Shoziiii/David_marshal_project/PCB 18.16 AS ORDERED/PCB 18.16 AS ORDERED/Knock sensor from PCB with Modifications.docx

Knock Sensor

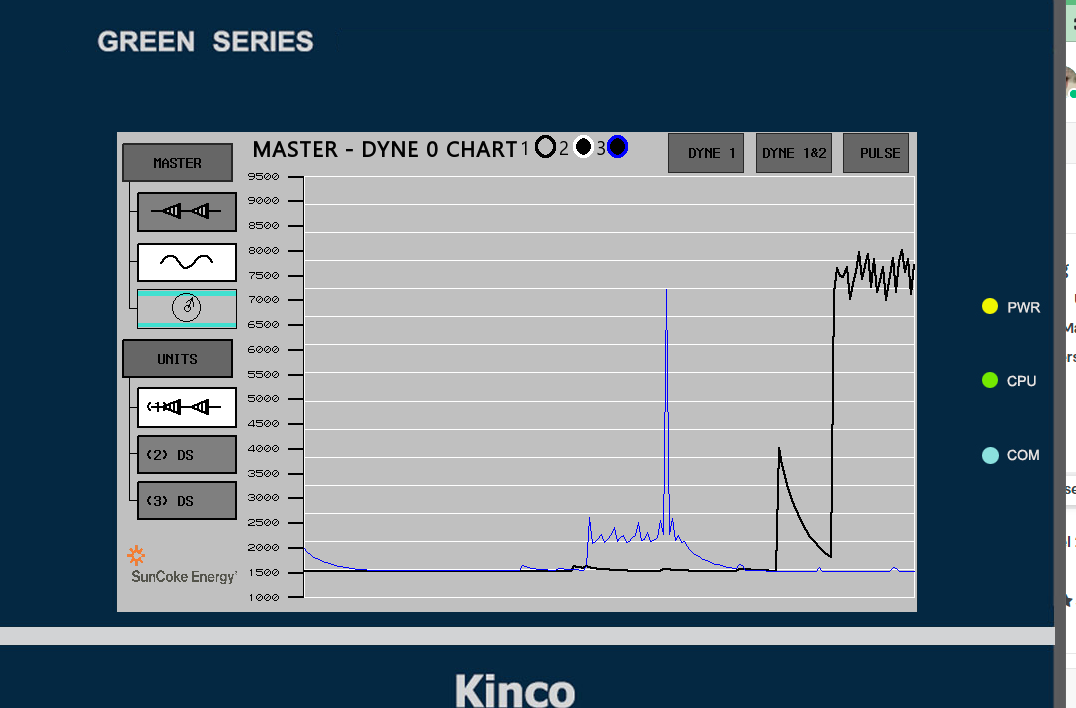
[picture p3: figure]

Blue is RST on PO-2, trigger

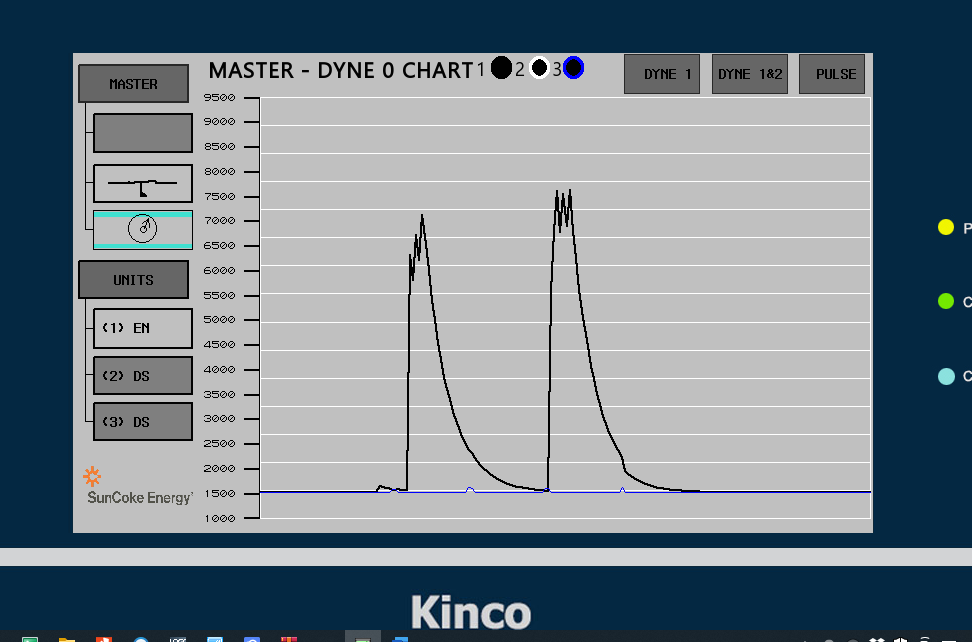
[picture p4: figure]
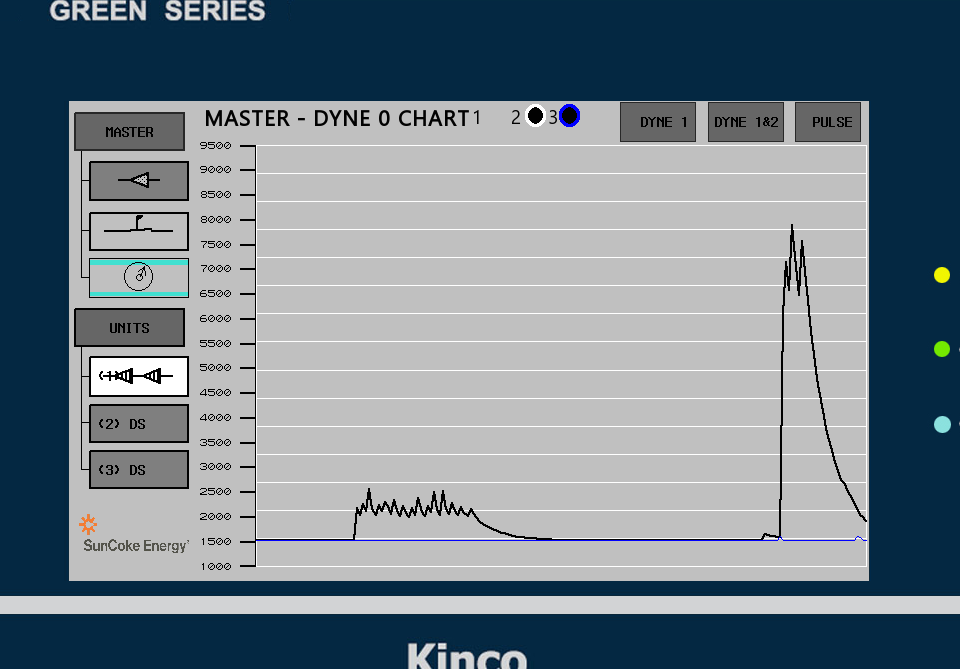
[picture p5: figure]

Black is 12V on RST, PO-1. Voltage is over 360R, V x 100
