Shoziiii/David_marshal_project/PCB 18.16 AS ORDERED/PCB 18.16 AS ORDERED/NODE RED/NODE RED MODBUS FLOW.PNG

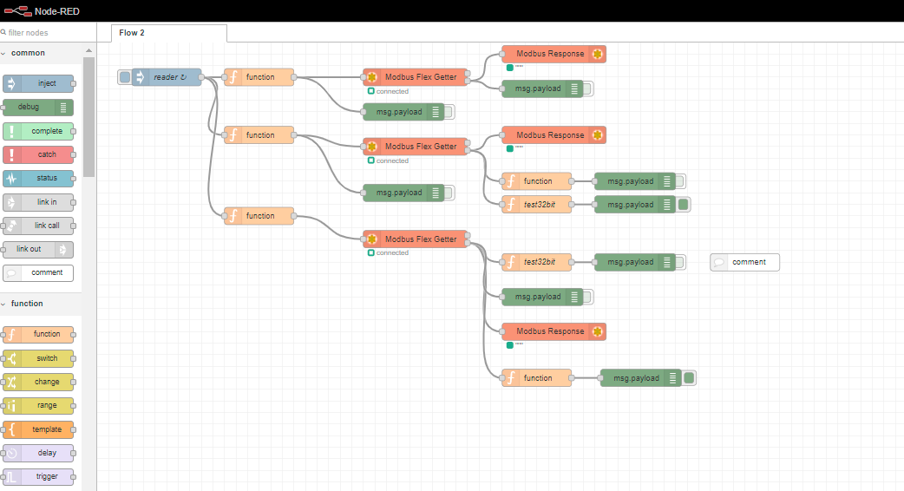
PCB 18.16 AS ORDERED/PCB 18.16 AS ORDERED/NODE RED/NODE RED MODBUS FLOW.PNG
