Shoziiii/David_marshal_project/PCB 18.16 AS ORDERED/PCB 18.16 AS ORDERED/Prob 1 3 5 Snaps B4 Aftr_01/Prob 5_After.png

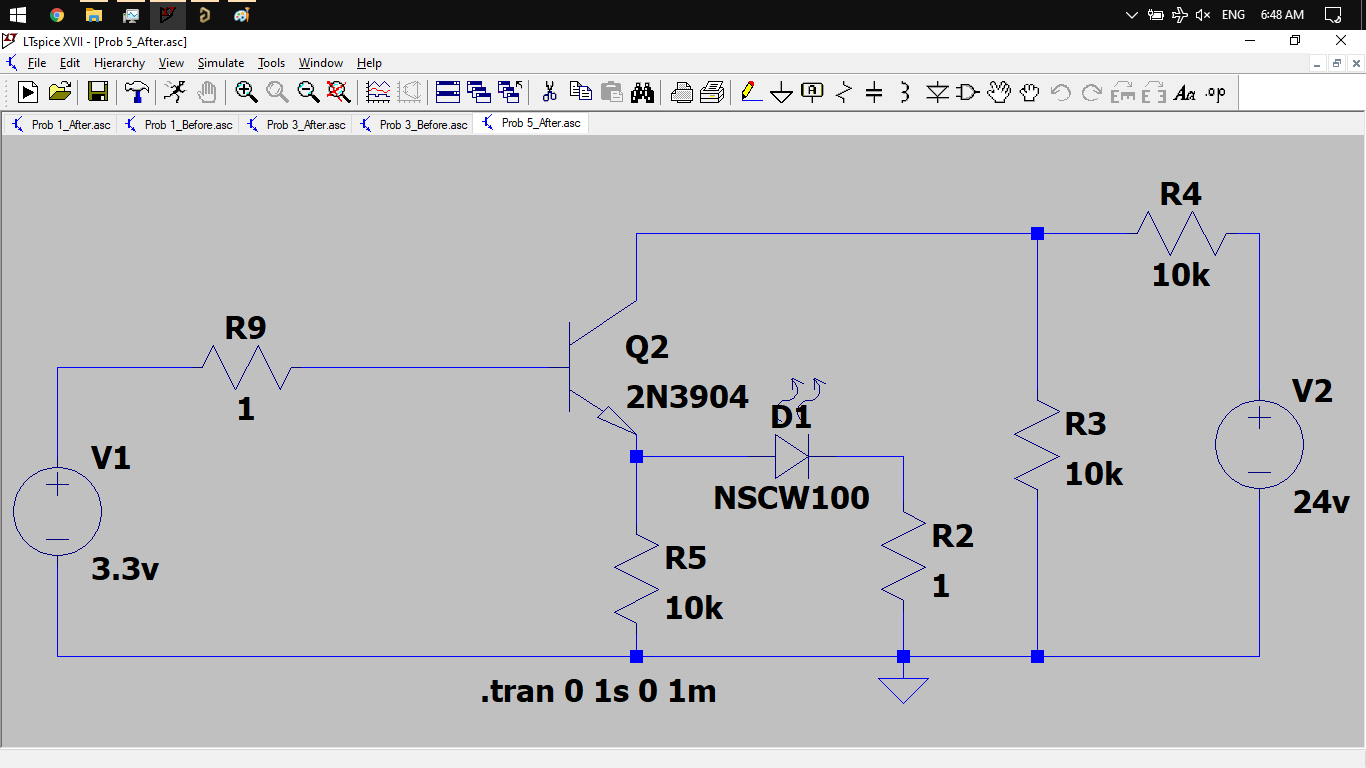
PCB 18.16 AS ORDERED/PCB 18.16 AS ORDERED/Prob 1 3 5 Snaps B4 Aftr_01/Prob 5_After.png
