Shoziiii/David_marshal_project/4220-0500-0400-0350-0105-00.DXF

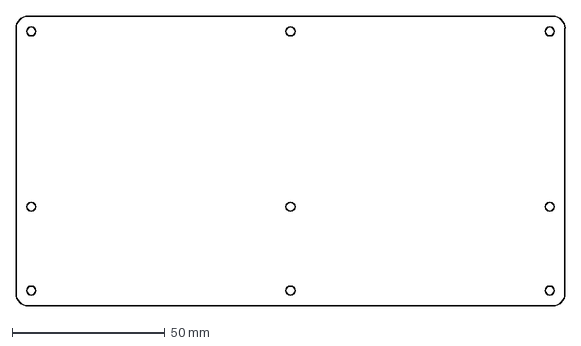
[picture p14: CAD file, 2022-06-06]
4220-0500-0400-0350-0105-00.DXF
180.0 x 95.0 mm
