Shoziiii/David_marshal_project/CAD MODELS/CAD MODELS/WJ15EDGVM-3.81-03P-14-00A.SLDPRT

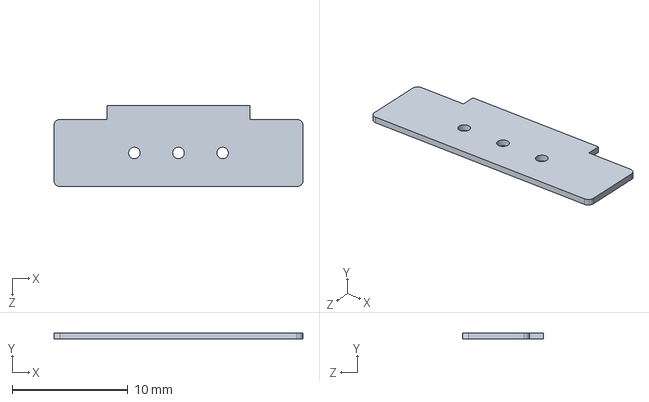
[picture p15: CAD file, 2022-06-06]
CAD MODELS/CAD MODELS/WJ15EDGVM-3.81-03P-14-00A.SLDPRT
21.5 x 0.5 x 7.00 mm
