Shoziiii/David_marshal_project/KICAD/symbols/LIB_INA3221AIRGVR/INA3221AIRGVR/3D/INA3221AIRGVR.stp

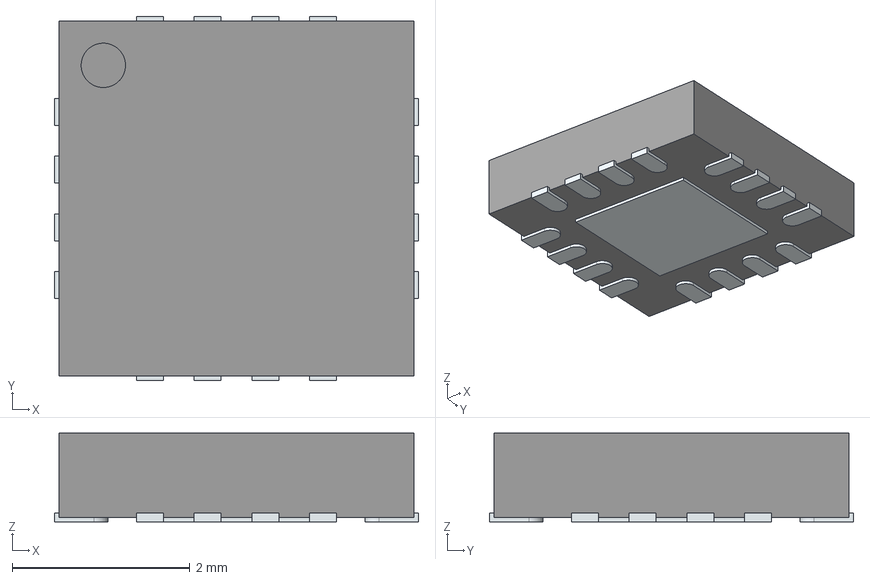
[picture p16: CAD file, 2022-06-06]
KICAD/symbols/LIB_INA3221AIRGVR/INA3221AIRGVR/3D/INA3221AIRGVR.stp
4.10 x 4.10 x 1.00 mm
ThermalPin
PinsArrayLR
PinsArrayTB
