Shoziiii/David_marshal_project/KICAD/symbols/LIB_LM358DR2G/LM358DR2G/3D/LM358DR2G.stp

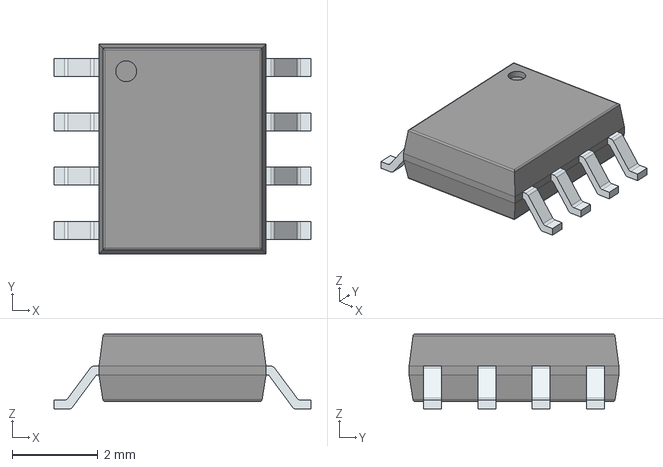
[picture p17: CAD file, 2022-06-06]
KICAD/symbols/LIB_LM358DR2G/LM358DR2G/3D/LM358DR2G.stp
6.00 x 4.90 x 1.75 mm
PinsArrayLR
