Shoziiii/David_marshal_project/KICAD/symbols/LIB_RVT1V471M1010/RVT1V471M1010/3D/RVT1V471M1010.stp

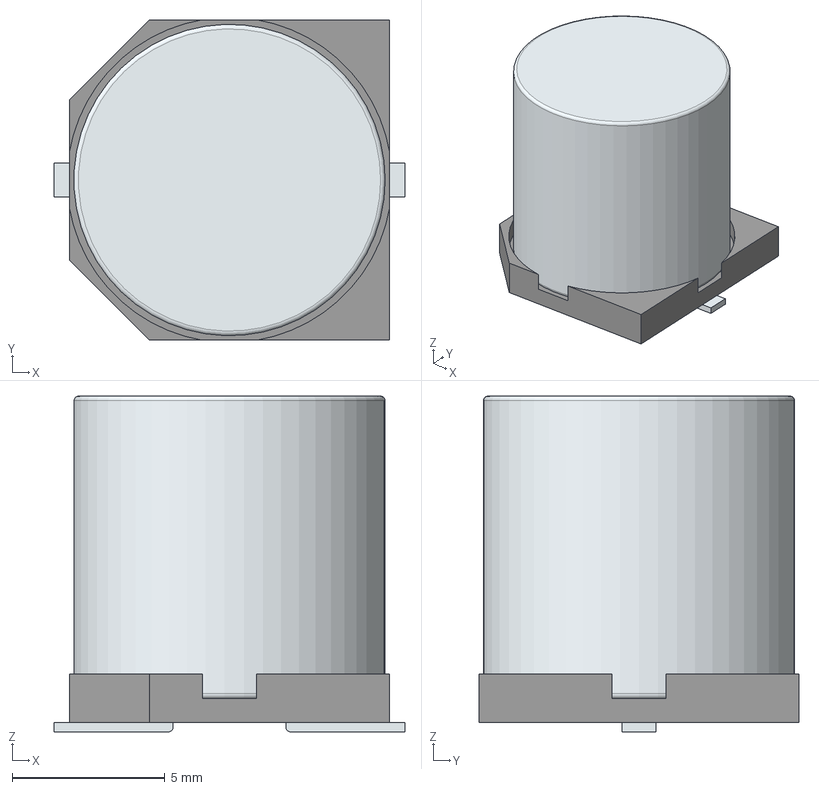
[picture p18: CAD file, 2022-06-06]
KICAD/symbols/LIB_RVT1V471M1010/RVT1V471M1010/3D/RVT1V471M1010.stp
11.5 x 10.5 x 11.0 mm
Base
Pin1Fillet
Pin2Fillet
