Shoziiii/David_marshal_project/KICAD/symbols/NE555DR/NE555DR.step

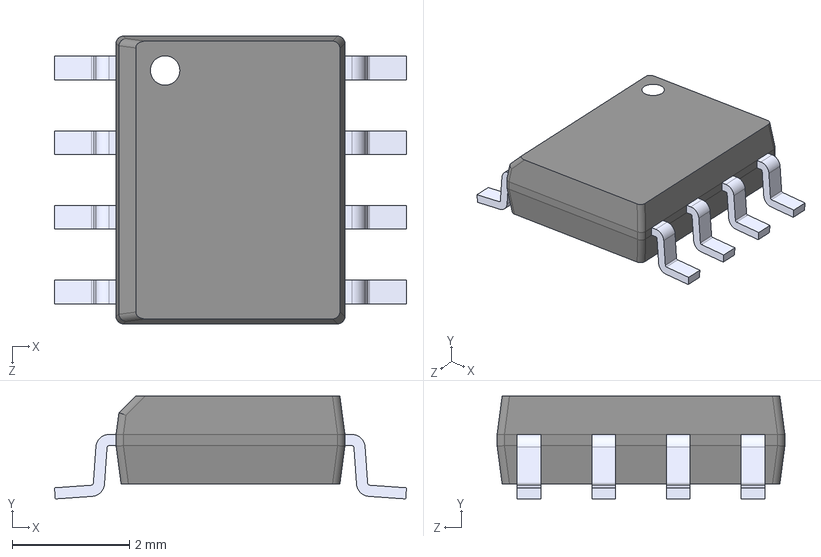
[picture p19: CAD file, 2022-06-06]
KICAD/symbols/NE555DR/NE555DR.step
5.99 x 1.75 x 4.90 mm
