Shoziiii/David_marshal_project/CAD MODELS/CAD MODELS/15EDGVM-3.81-02P-14-00A(H).SLDPRT

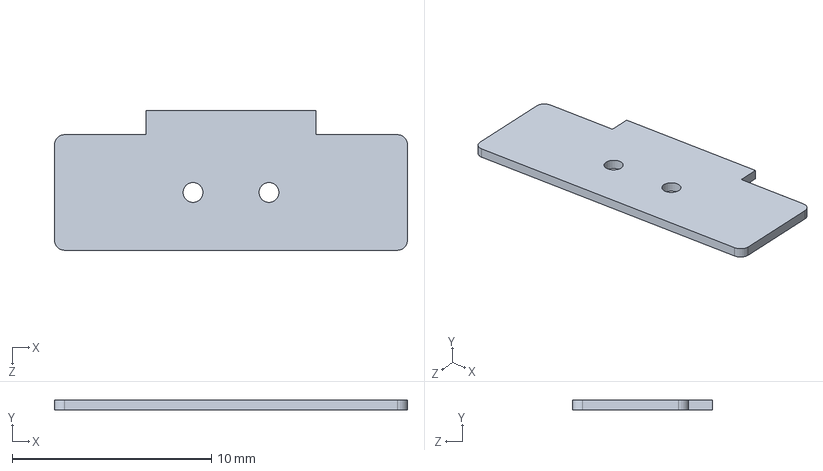
[picture p20: CAD file, 2022-06-06]
CAD MODELS/CAD MODELS/15EDGVM-3.81-02P-14-00A(H).SLDPRT
17.7 x 0.5 x 7.00 mm
