Shoziiii/David_marshal_project/CAD MODELS/CAD MODELS/WJ15EDGVM-3.81-04P-14-00A.SLDPRT

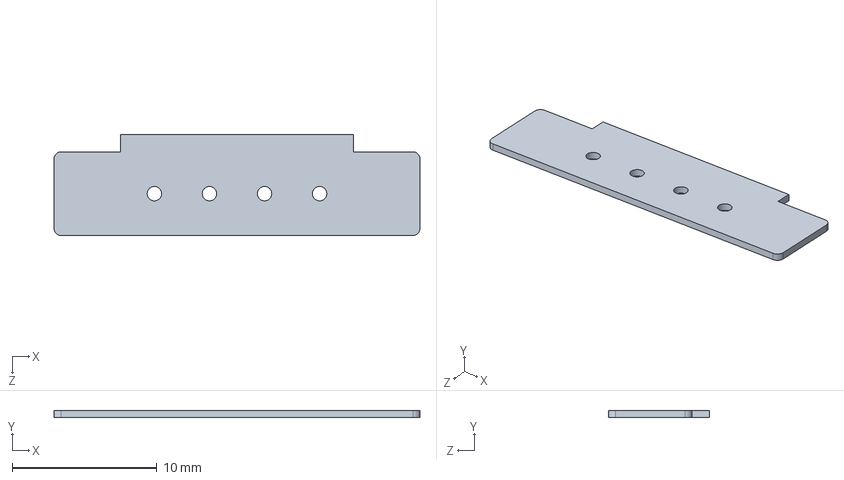
[picture p21: CAD file, 2022-06-06]
CAD MODELS/CAD MODELS/WJ15EDGVM-3.81-04P-14-00A.SLDPRT
25.3 x 0.5 x 7.00 mm
