Shoziiii/David_marshal_project/(list of files, cad)

Other CAD files:
KICAD/symbols/LIB_MCP6002T-I_SN/MCP6002T-I_SN/3D/MCP6002T-I_SN.stp
KICAD/symbols/LIB_XL1509-5.0E1/XL1509-5.0E1/3D/XL1509-5.0E1.stp
CAD MODELS/CAD MODELS/15EDGVM-3.81-02P-14-00A(H).SLDDRW
CAD MODELS/CAD MODELS/WJ15EDGVM-3.81-03P-14-00A.SLDDRW
KICAD/symbols/LIB_INA3221AIRGVR/INA3221AIRGVR/3D/INA3221AIRGVR.stl
KICAD/symbols/LIB_INA3221AIRGVR/INA3221AIRGVR/Allegro/qfn65p400x400x100-17n-d.psm
KICAD/symbols/LIB_INA3221AIRGVR/INA3221AIRGVR/DEHDL/ina3221airgvr/chips/chips.prt
KICAD/symbols/LIB_LM358DR2G/LM358DR2G/3D/LM358DR2G.stl
KICAD/symbols/LIB_LM358DR2G/LM358DR2G/Allegro/soic127p600x175-8n.psm
KICAD/symbols/LIB_LM358DR2G/LM358DR2G/DEHDL/lm358dr2g/chips/chips.prt
KICAD/symbols/LIB_MCP6002T-I_SN/MCP6002T-I_SN/3D/MCP6002T-I_SN.stl
KICAD/symbols/LIB_MCP6002T-I_SN/MCP6002T-I_SN/Allegro/soic127p600x175-8n.psm
KICAD/symbols/LIB_MCP6002T-I_SN/MCP6002T-I_SN/DEHDL/mcp6002t_i_sn/chips/chips.prt
KICAD/symbols/LIB_RVT1V471M1010/RVT1V471M1010/3D/RVT1V471M1010.stl
KICAD/symbols/LIB_RVT1V471M1010/RVT1V471M1010/Allegro/capae1030x1100n.psm
KICAD/symbols/LIB_RVT1V471M1010/RVT1V471M1010/DEHDL/rvt1v471m1010/chips/chips.prt
KICAD/symbols/LIB_XL1509-5.0E1/XL1509-5.0E1/3D/XL1509-5.0E1.stl
KICAD/symbols/LIB_XL1509-5.0E1/XL1509-5.0E1/Allegro/soic127p600x175-8n.psm
KICAD/symbols/LIB_XL1509-5.0E1/XL1509-5.0E1/DEHDL/xl1509_5.0e1/chips/chips.prt
