Shoziiii/David_marshal_project/PCB 18.16 AS ORDERED/PCB 18.16 AS ORDERED/CODE/Arduino Build Document.docx

Pins_arduino.h file:

C:\Users\dj1en\AppData\Local\Arduino15\packages\arduino\hardware\mbed_rp2040\2.7.2\variants\RASPBERRY_PI_PICO

Change:

I2C Wire:

// Wire

#define PIN_WIRE_SDA (8u)

#define PIN_WIRE_SCL (9u)
