Shoziiii/David_marshal_project/19.20/Schematic Diagram PDF/19.20.pdf

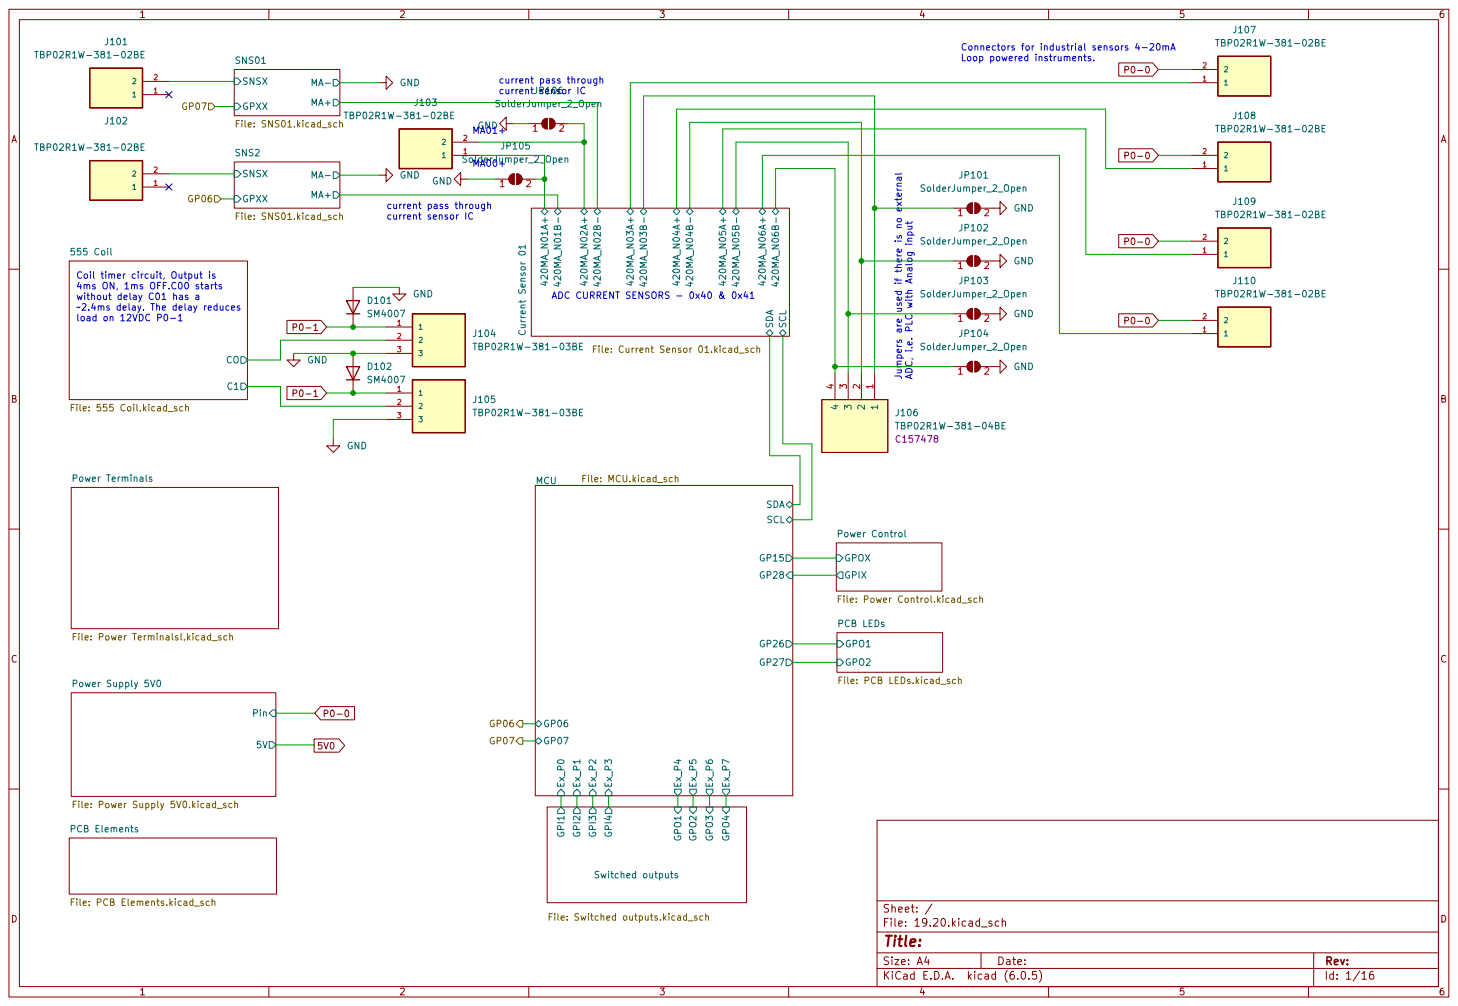
[picture p27: page 1]

Connectors for industrial sensors 4-20mA

File: Power Supply 5V0.kicad_sch CO

current pass through current sensor IC

SNSX
Power Control File: Power Control.kicad_sch MA- MA+ GPXX

~2.4ms delay. The delay reduces
load on 12VDC P0-1

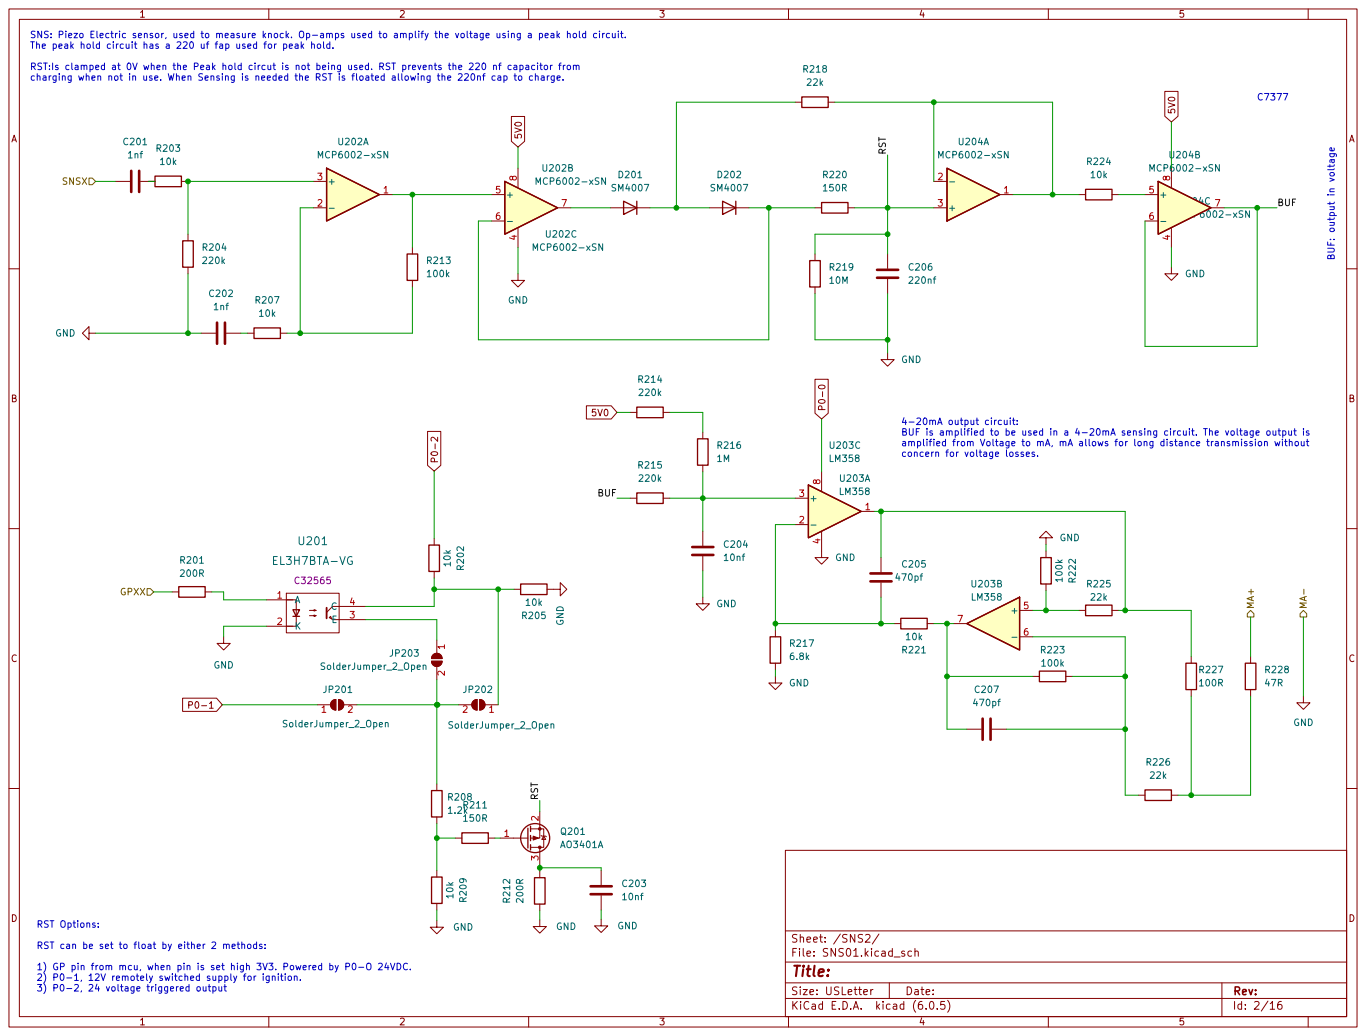
[picture p28: page 2]

SNS: Piezo Electric sensor, used to measure knock. Op-amps used to amplify the voltage using a peak hold circuit.
The peak hold circuit has a 220 uf fap used for peak hold.

RST:Is clamped at 0V when the Peak hold circut is not being used. RST prevents the 220 nf capacitor from
charging when not in use. When Sensing is needed the RST is floated allowing the 220nf cap to charge.

4-20mA output circuit:
BUF is amplified to be used in a 4-20mA sensing circuit. The voltage output is
amplified from Voltage to mA, mA allows for long distance transmission without
concern for voltage losses.

RST can be set to float by either 2 methods:

1) GP pin from mcu, when pin is set high 3V3. Powered by P0-O 24VDC.
2) P0-1, 12V remotely switched supply for ignition.

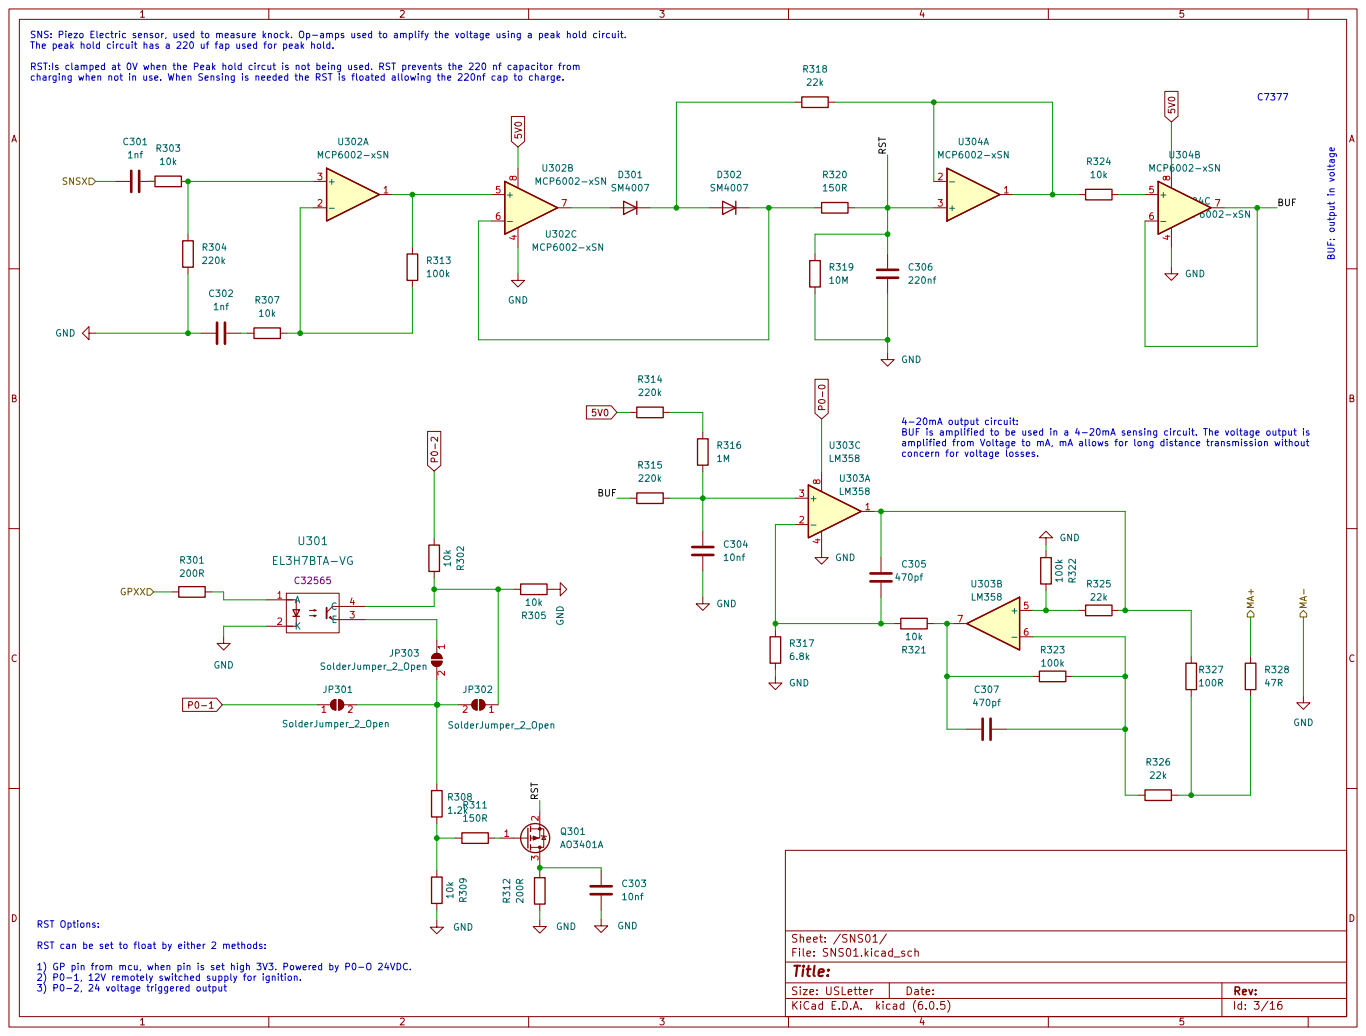
[picture p29: page 3]
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

RST can be set to float by either 2 methods:

1) GP pin from mcu, when pin is set high 3V3. Powered by P0-O 24VDC.
2) P0-1, 12V remotely switched supply for ignition.

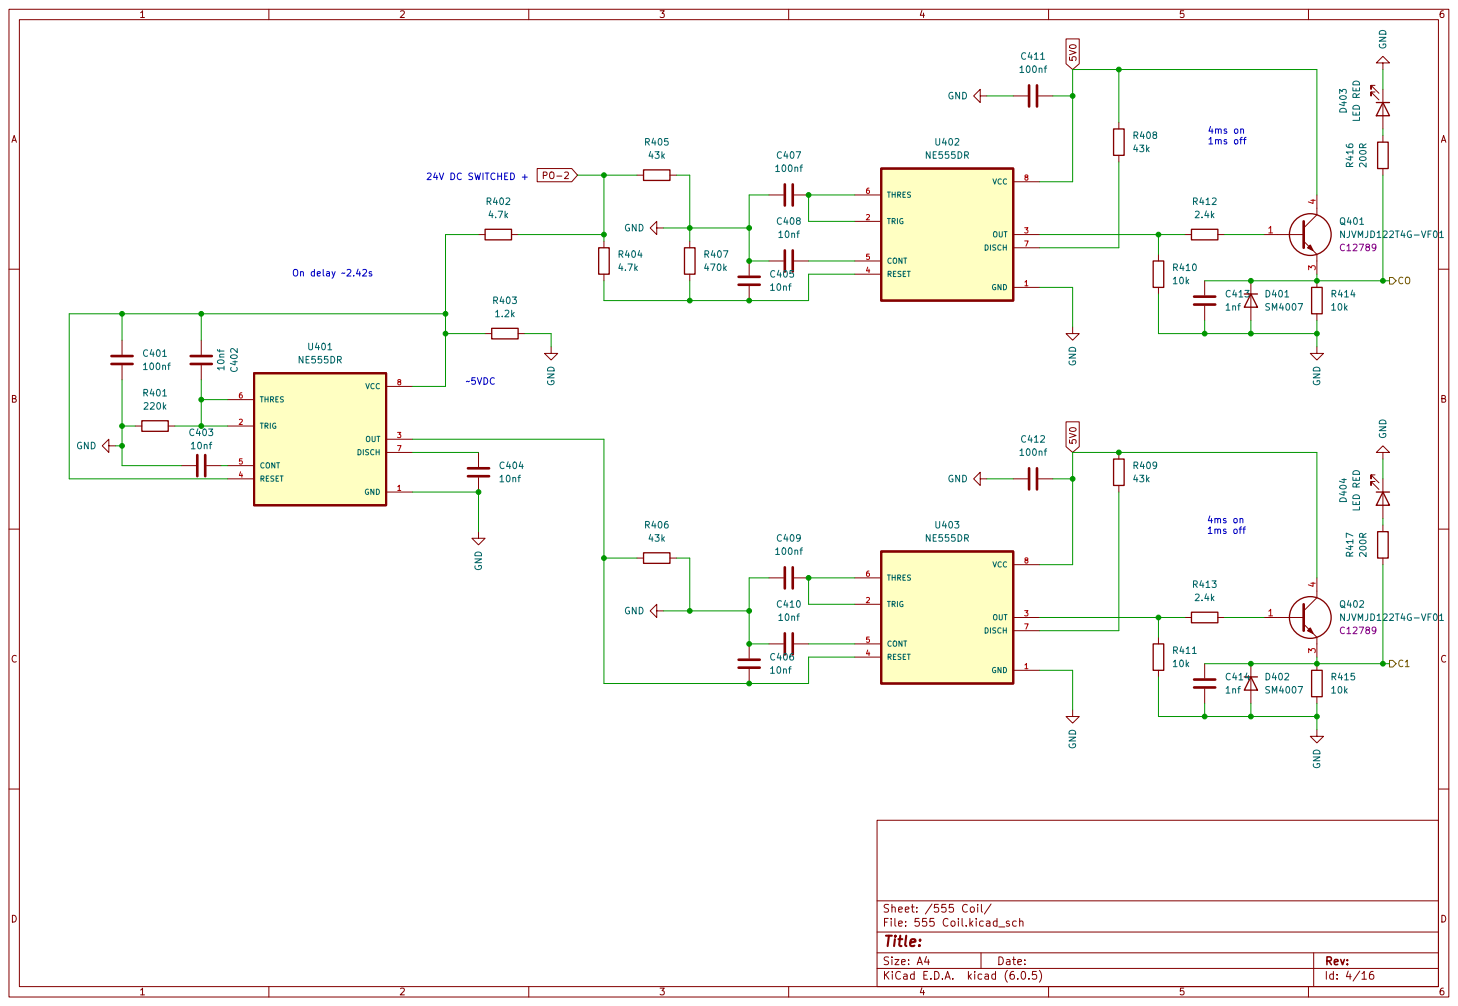
[picture p30: page 4]

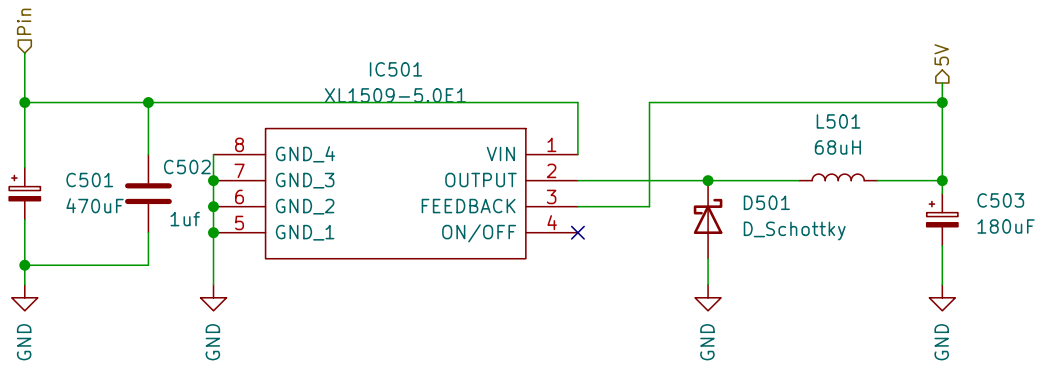
[picture p31: page 5]

Sheet: /Power Supply 5V0/ GND

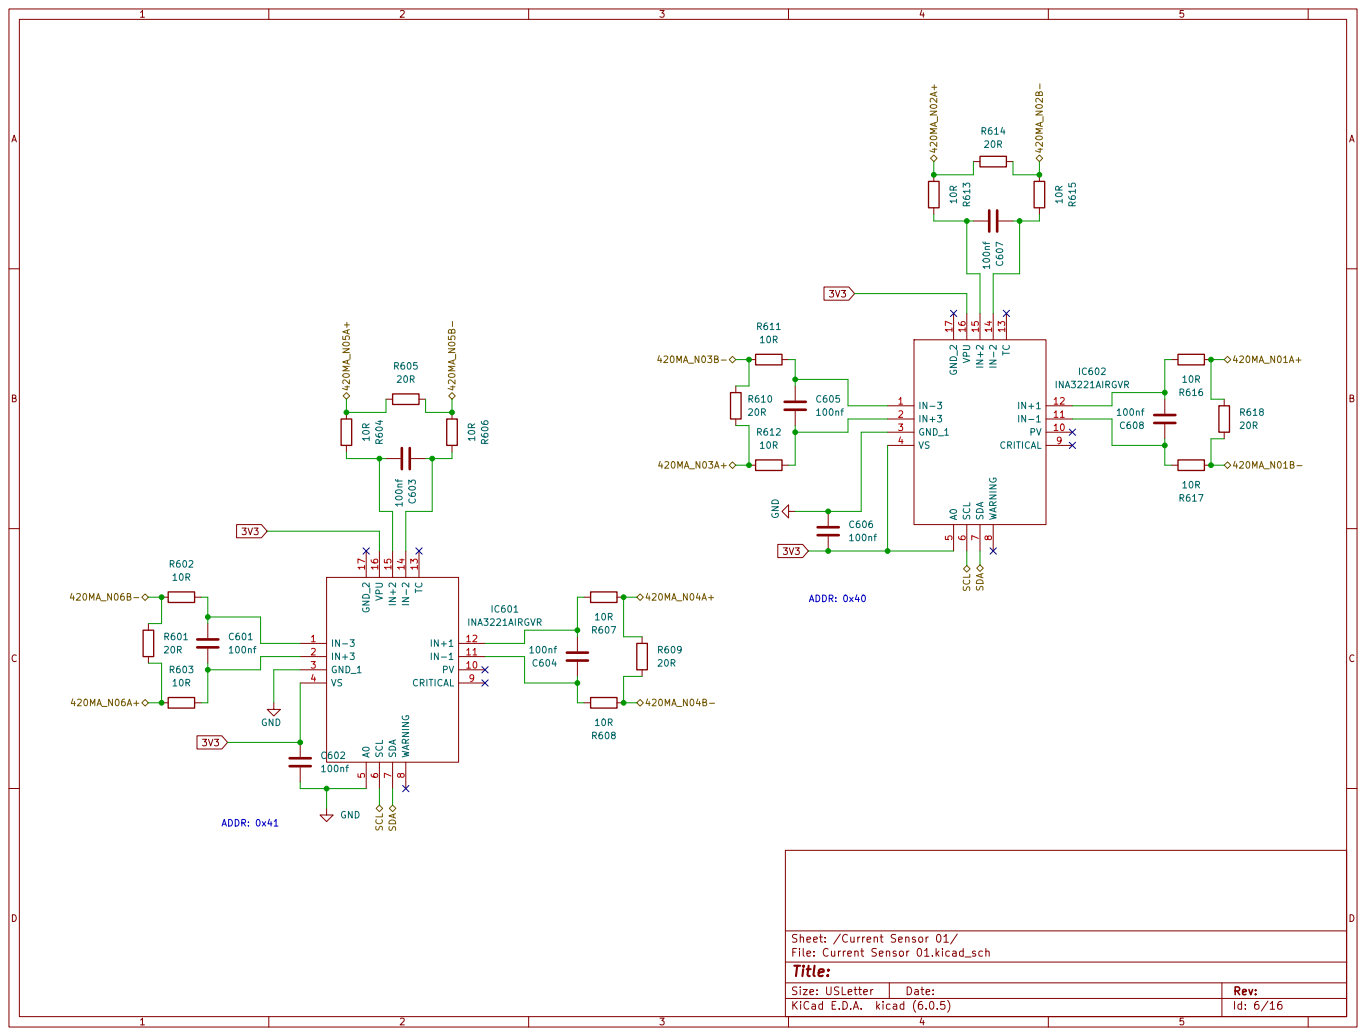
[picture p32: page 6]

File: Current Sensor 01.kicad_sch Sheet: /Current Sensor 01/

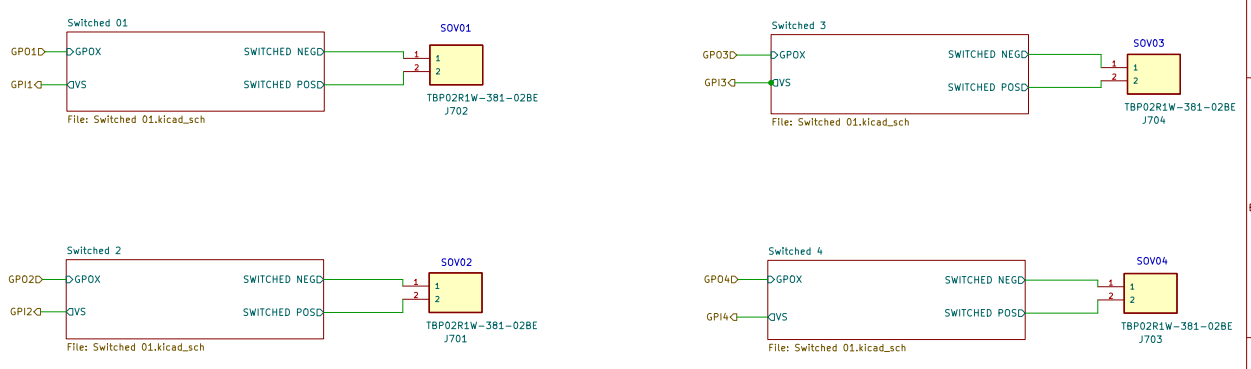
[picture p33: page 7]

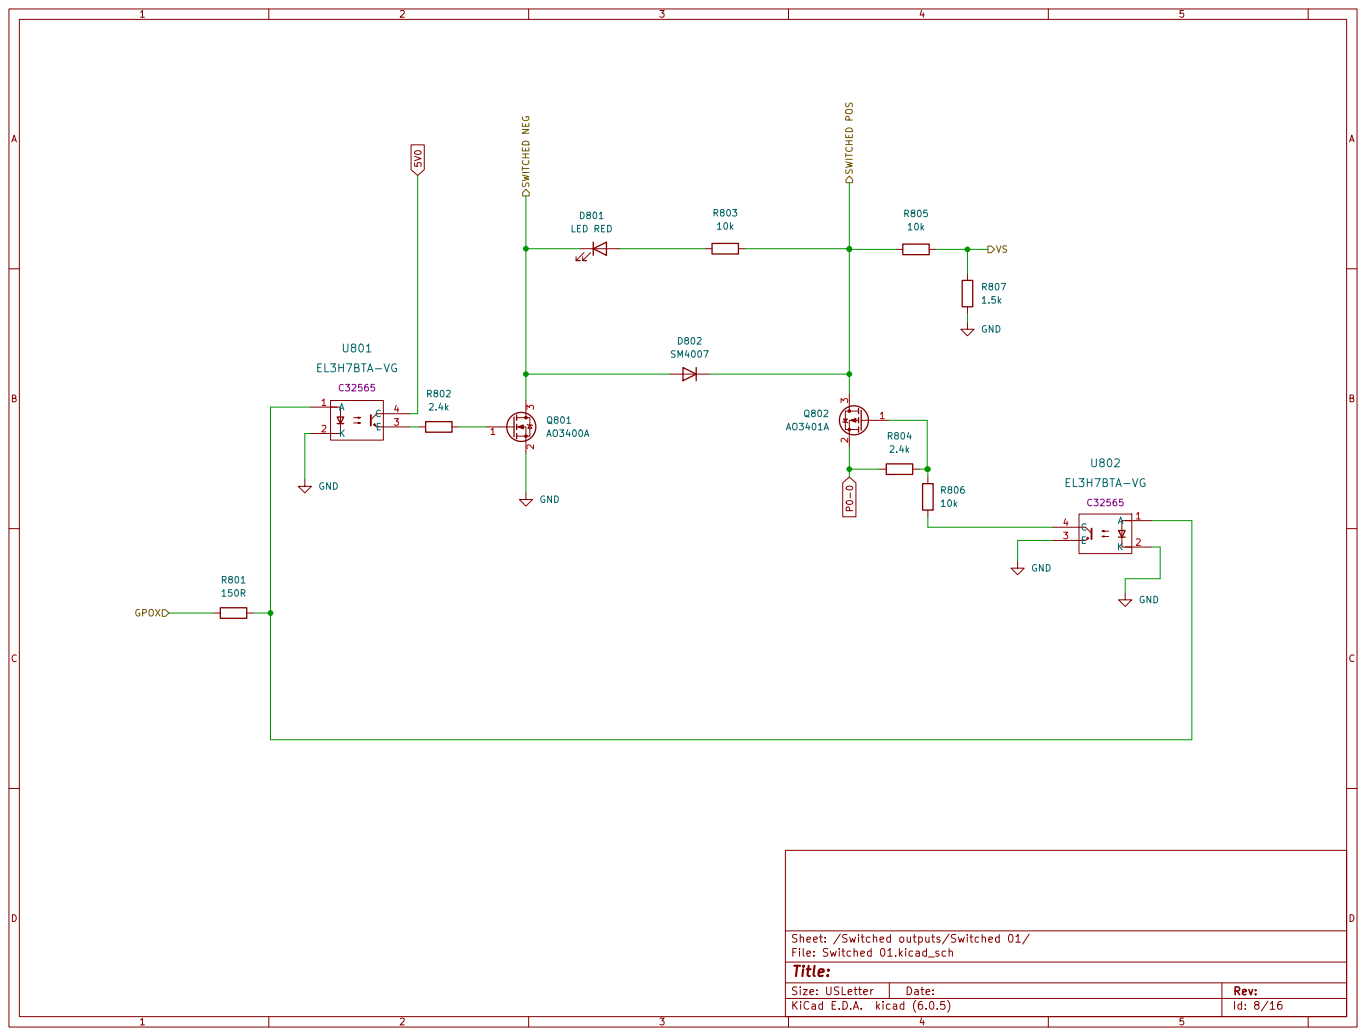
[picture p34: page 8]

Sheet: /Switched outputs/Switched 01/ GND

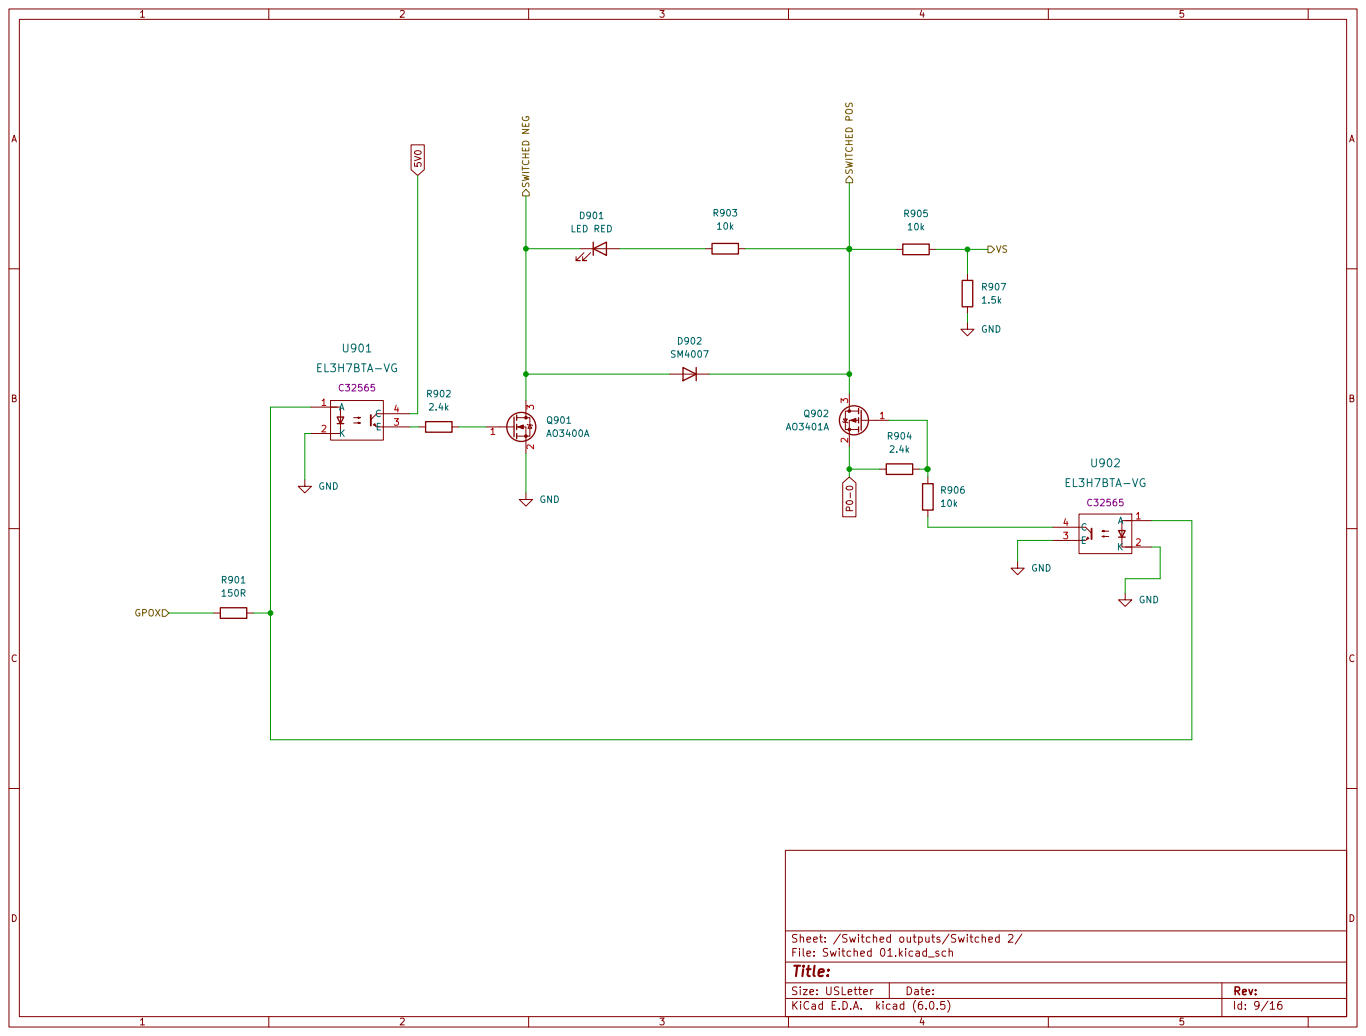
[picture p35: page 9]

Sheet: /Switched outputs/Switched 2/ GND

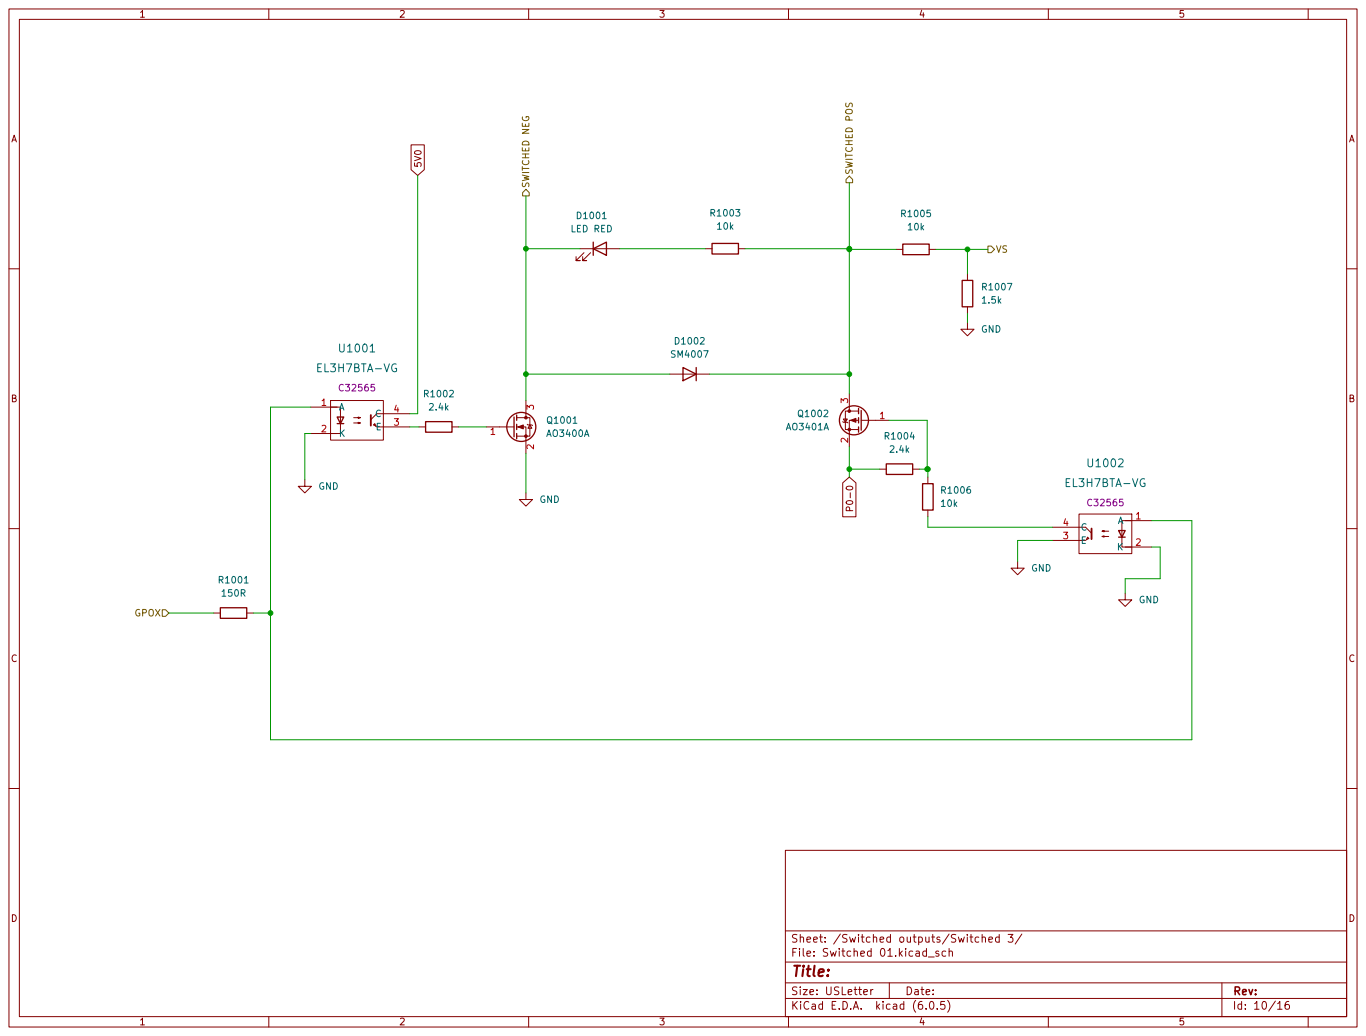
[picture p36: page 10]

Sheet: /Switched outputs/Switched 3/ GND

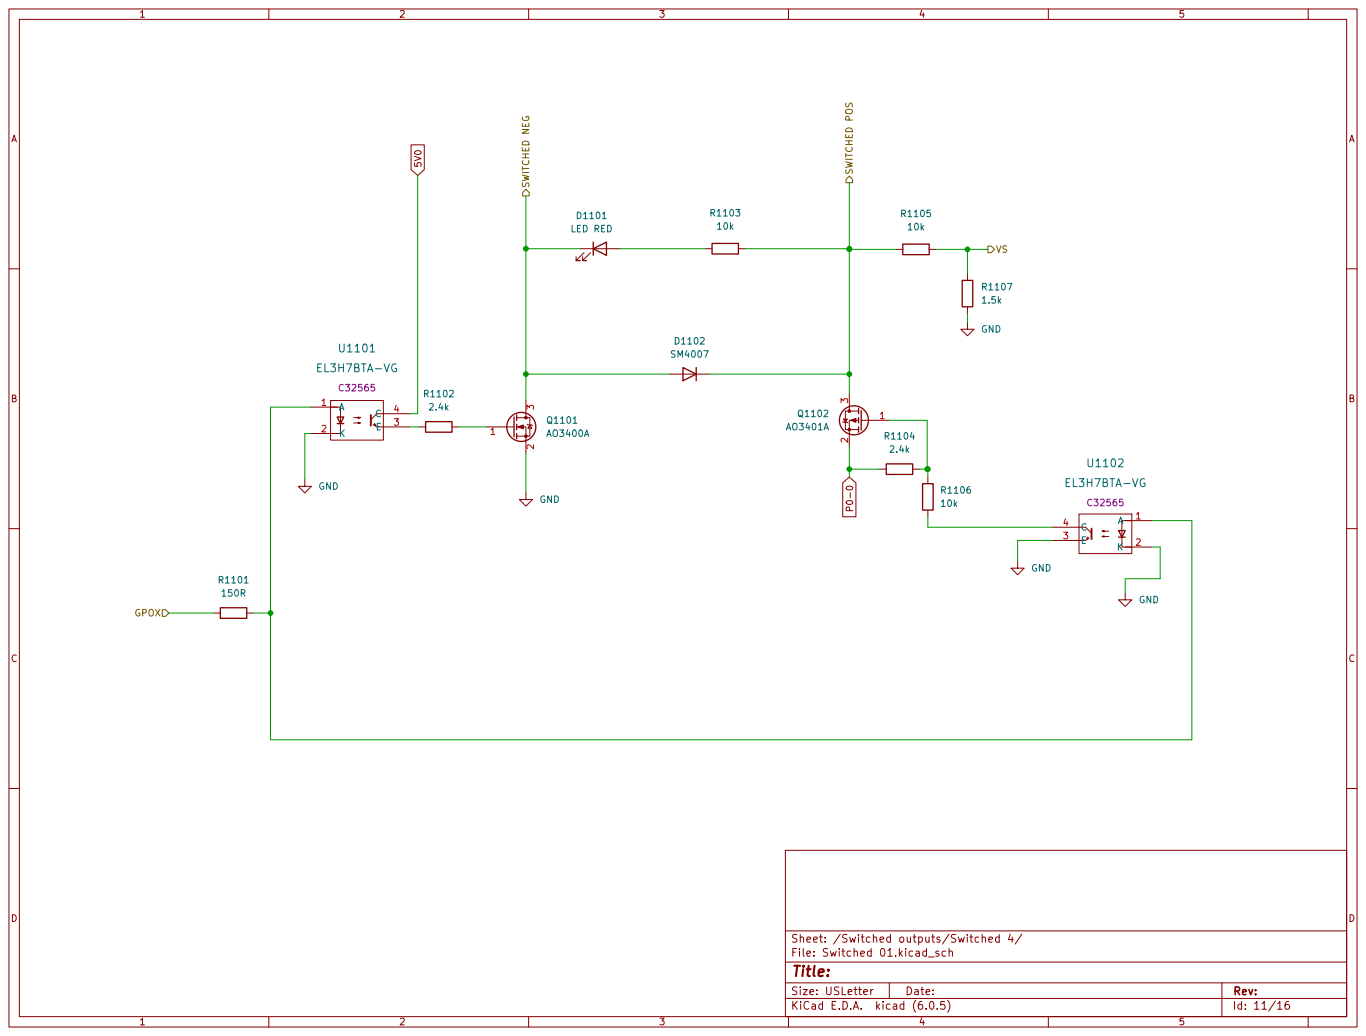
[picture p37: page 11]

Sheet: /Switched outputs/Switched 4/ GND

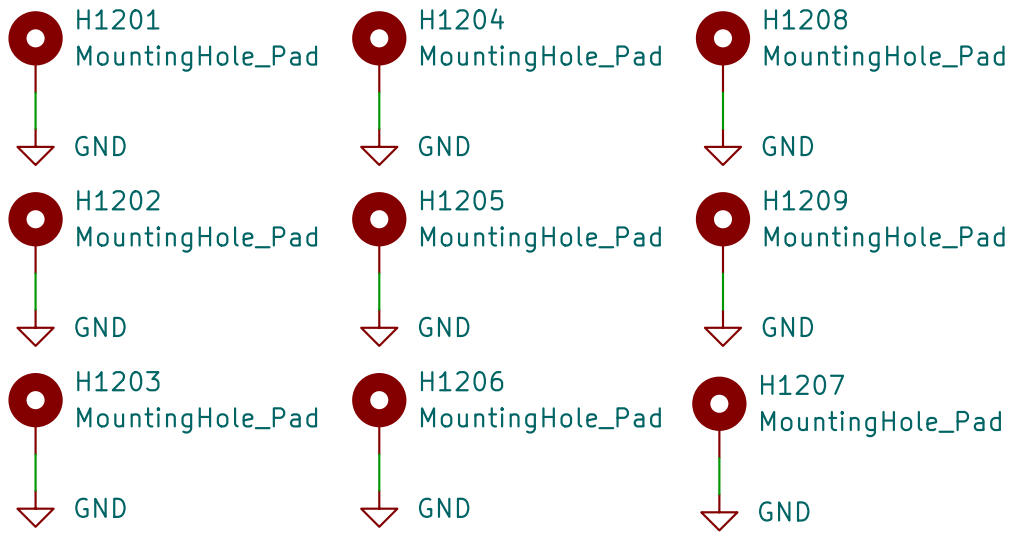
[picture p38: page 12]

File: PCB Elements.kicad_sch Sheet: /PCB Elements/
Id: 12/16 Title:

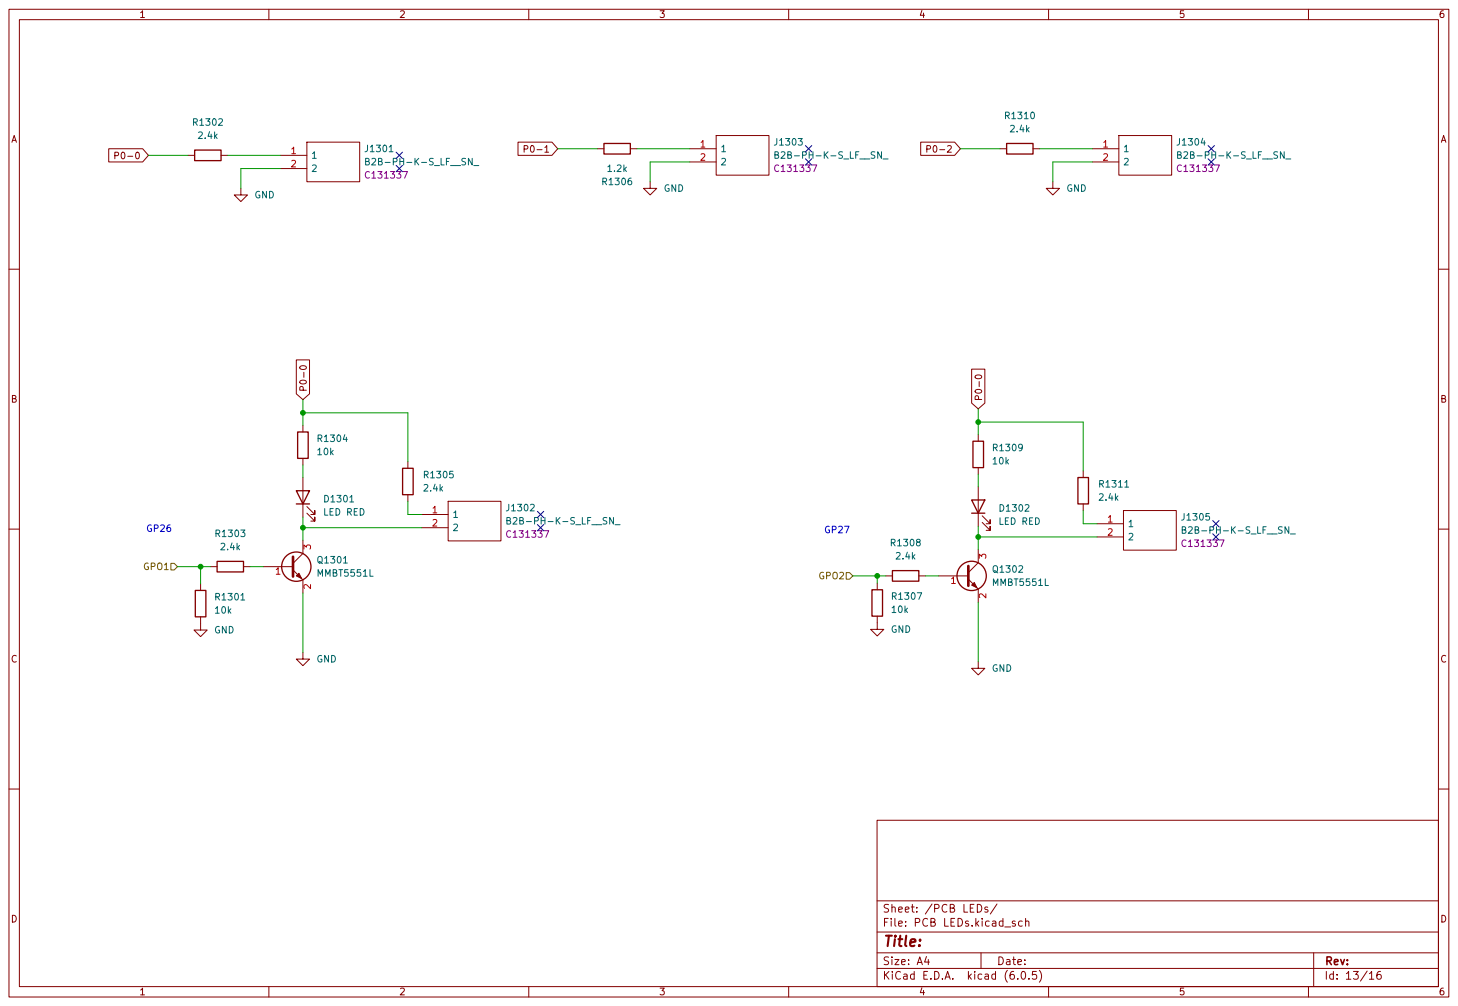
[picture p39: page 13]

File: PCB LEDs.kicad_sch Sheet: /PCB LEDs/
Id: 13/16 Title:

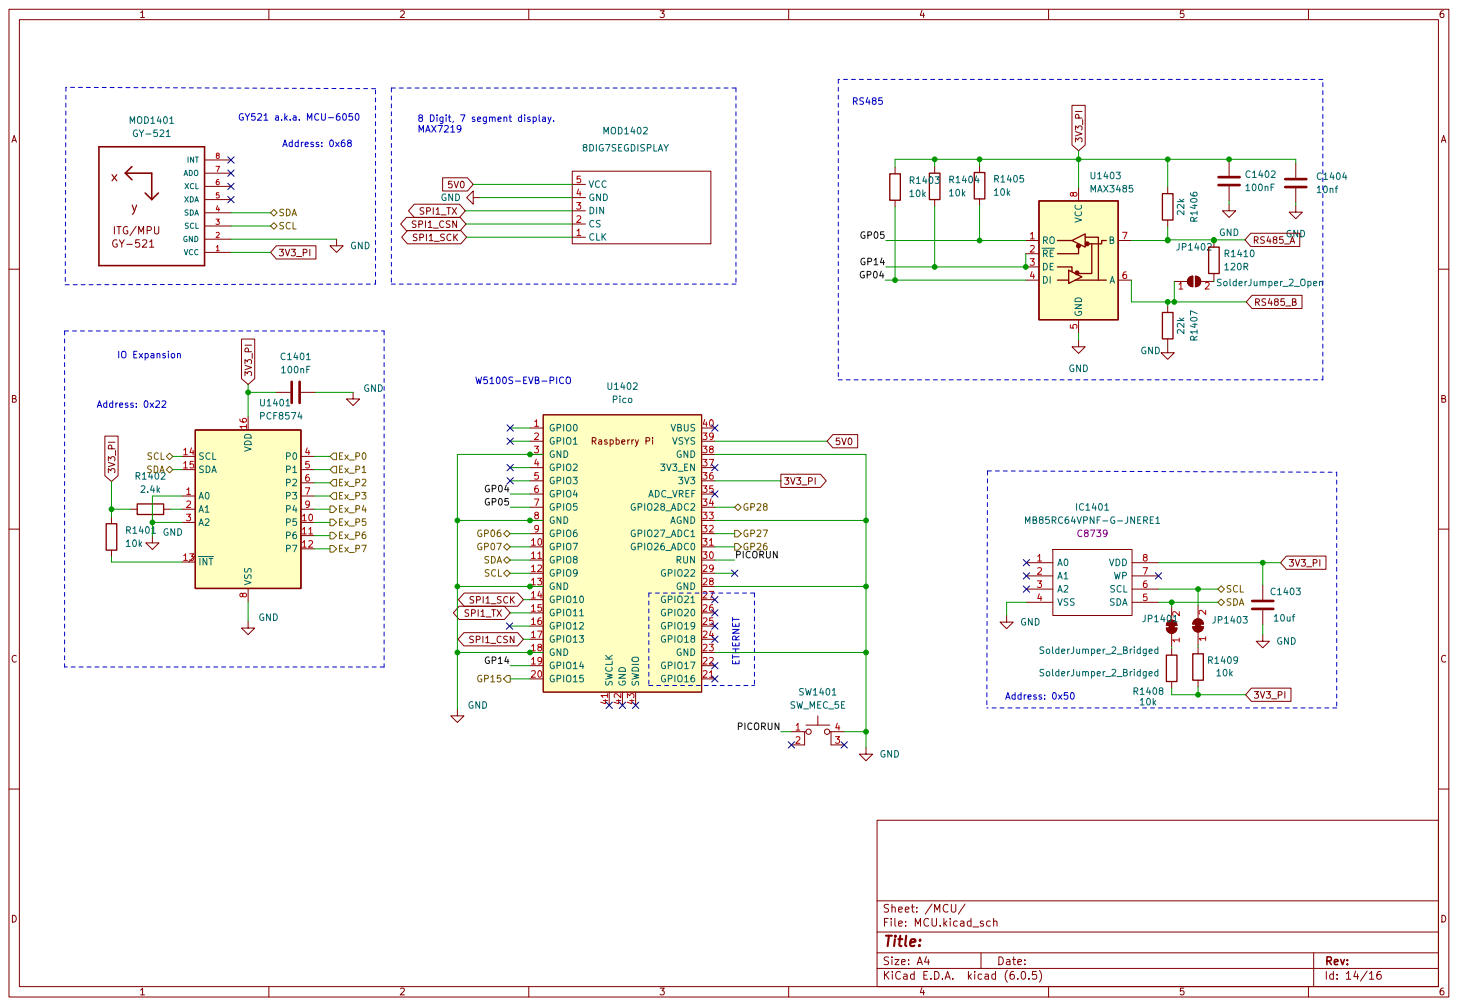
[picture p40: page 14]

File: MCU.kicad_sch Sheet: /MCU/
Id: 14/16 Title:

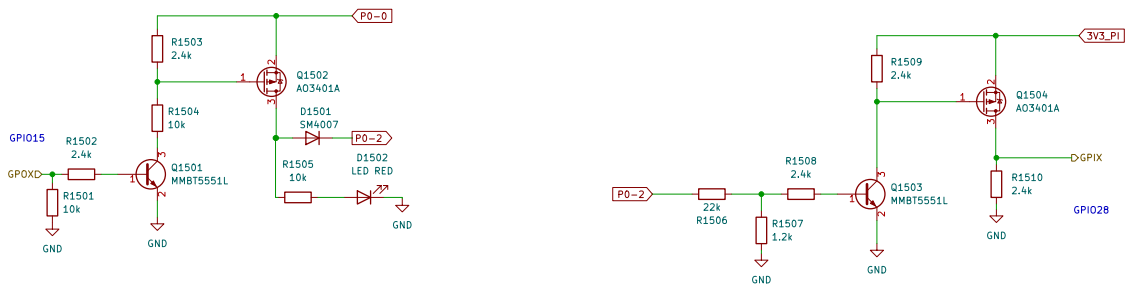
[picture p41: page 15]

File: Power Control.kicad_sch Sheet: /Power Control/ GND

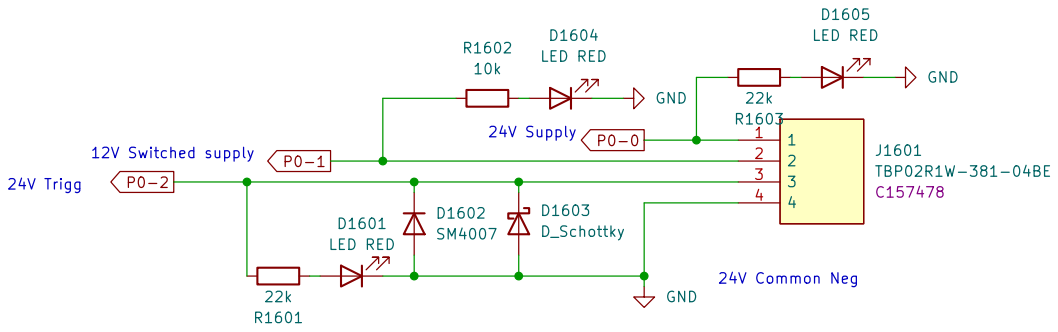
[picture p42: page 16]

File: Power Terminalsl.kicad_sch Sheet: /Power Terminals/
Id: 16/16 Title:
