Shoziiii/David_marshal_project/PCB 18.16 AS ORDERED/PCB 18.16 AS ORDERED/Schematic_DV_MR_rev_modbus_18.16_2022-01-25.pdf

## 24VDC / 2 Amps / Induductive coil load

## 24VDC / 2 Amps / Induductive coil load

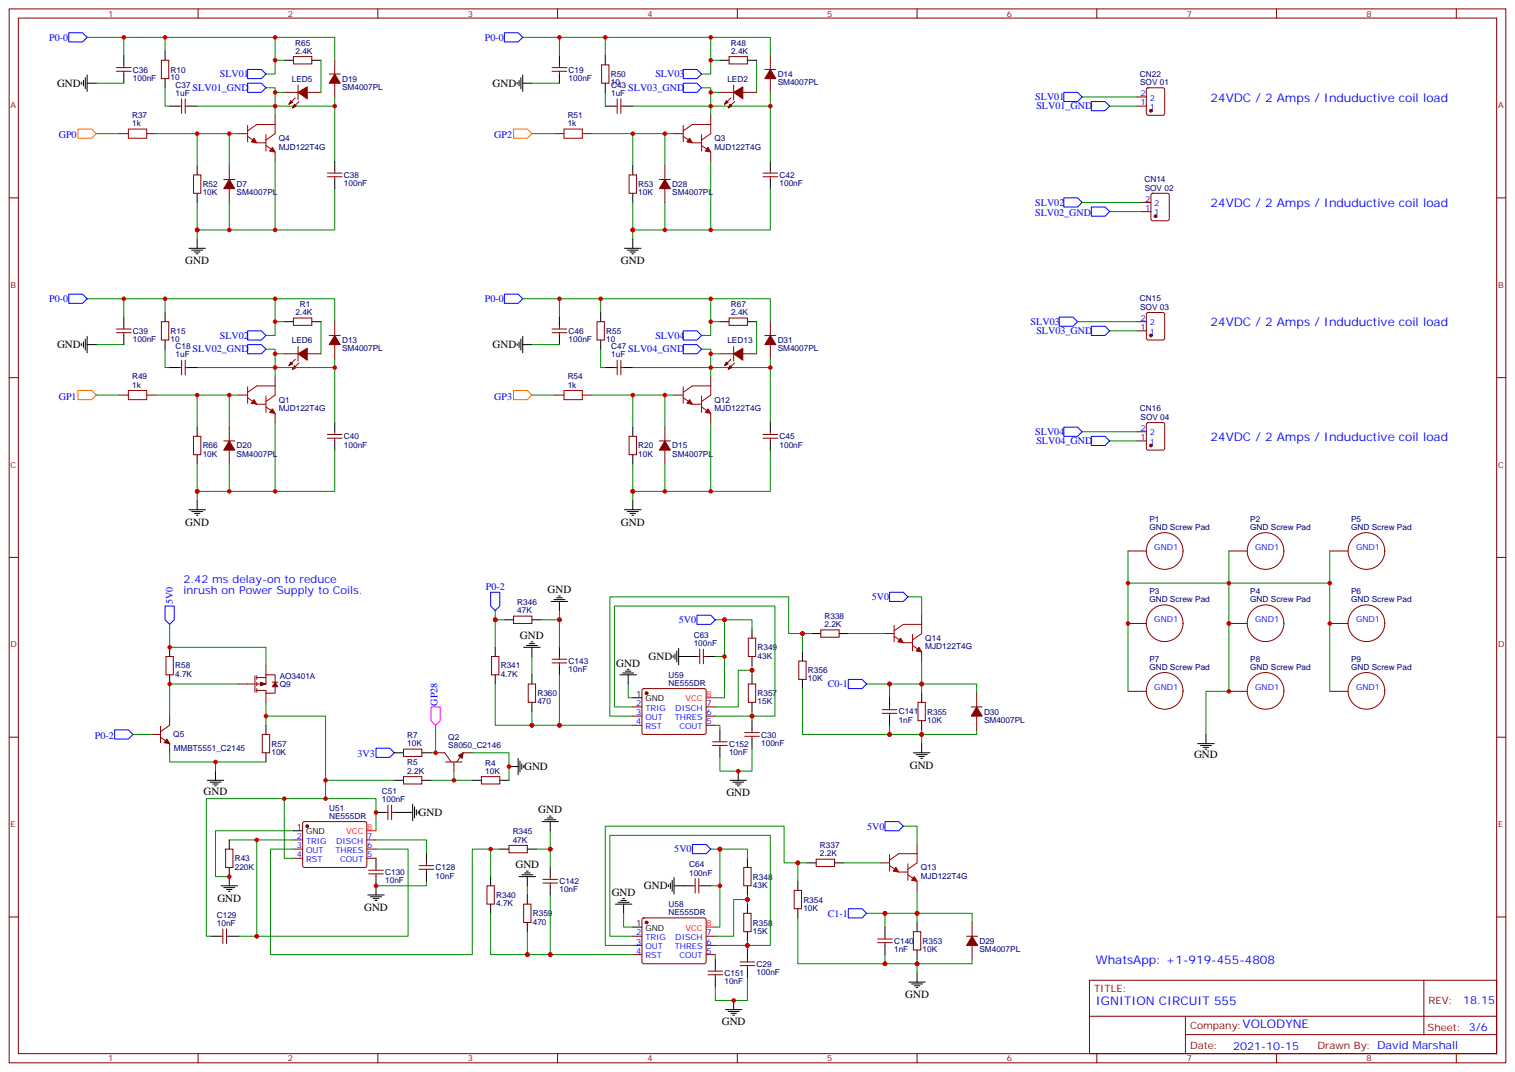
[picture p43: page 1]

24VDC / 2 Amps / Induductive coil load

2.42 ms delay-on to reduce
inrush on Power Supply to Coils.

Drawn By: David Marshall

# REVIEW ALL ADDRESS FOR I2C BUS GP¹⁴

## GYROSCOPE, added to I2C interface

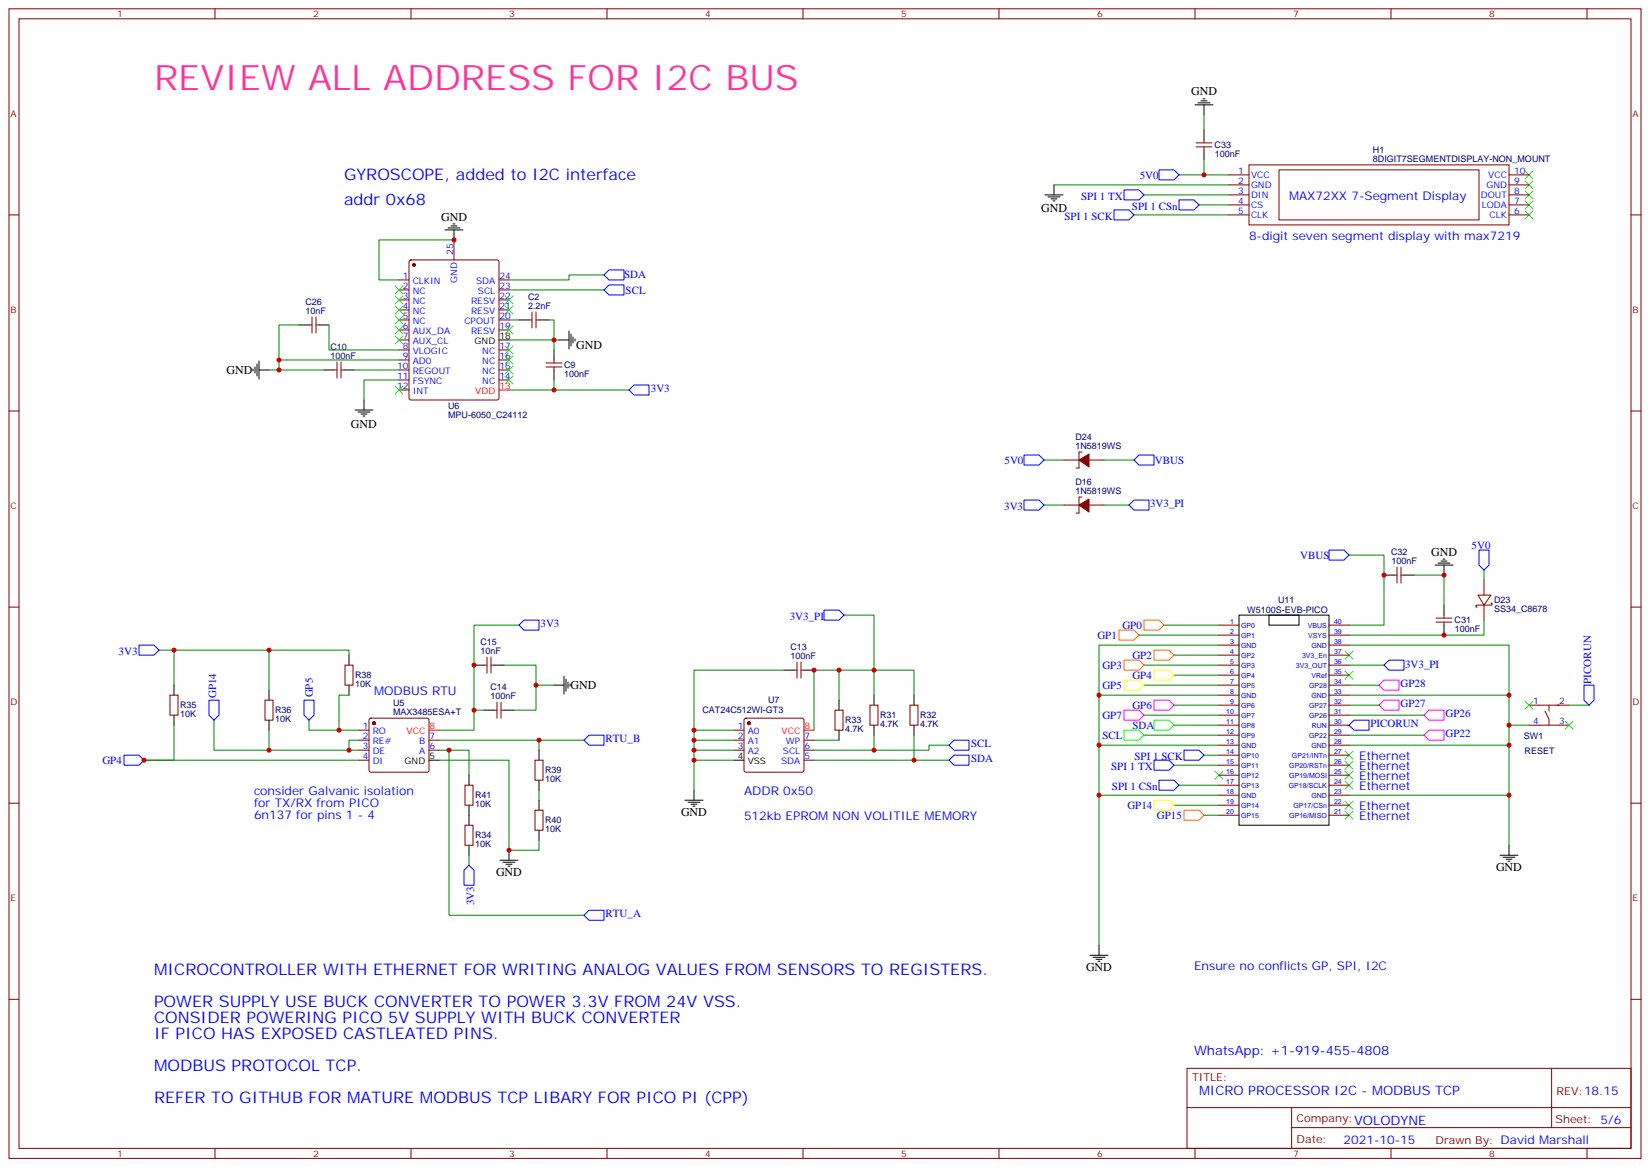
[picture p44: page 2]

consider Galvanic isolation
for TX/RX from PICO
6n137 for pins 1 - 4

ADDR 0x50
512kb EPROM NON VOLITILE MEMORY

POWER SUPPLY USE BUCK CONVERTER TO POWER 3.3V FROM 24V VSS.
CONSIDER POWERING PICO 5V SUPPLY WITH BUCK CONVERTER
IF PICO HAS EXPOSED CASTLEATED PINS.
MODBUS PROTOCOL TCP.
REFER TO GITHUB FOR MATURE MODBUS TCP LIBARY FOR PICO PI (CPP)

Ensure no conflicts GP, SPI, I2C

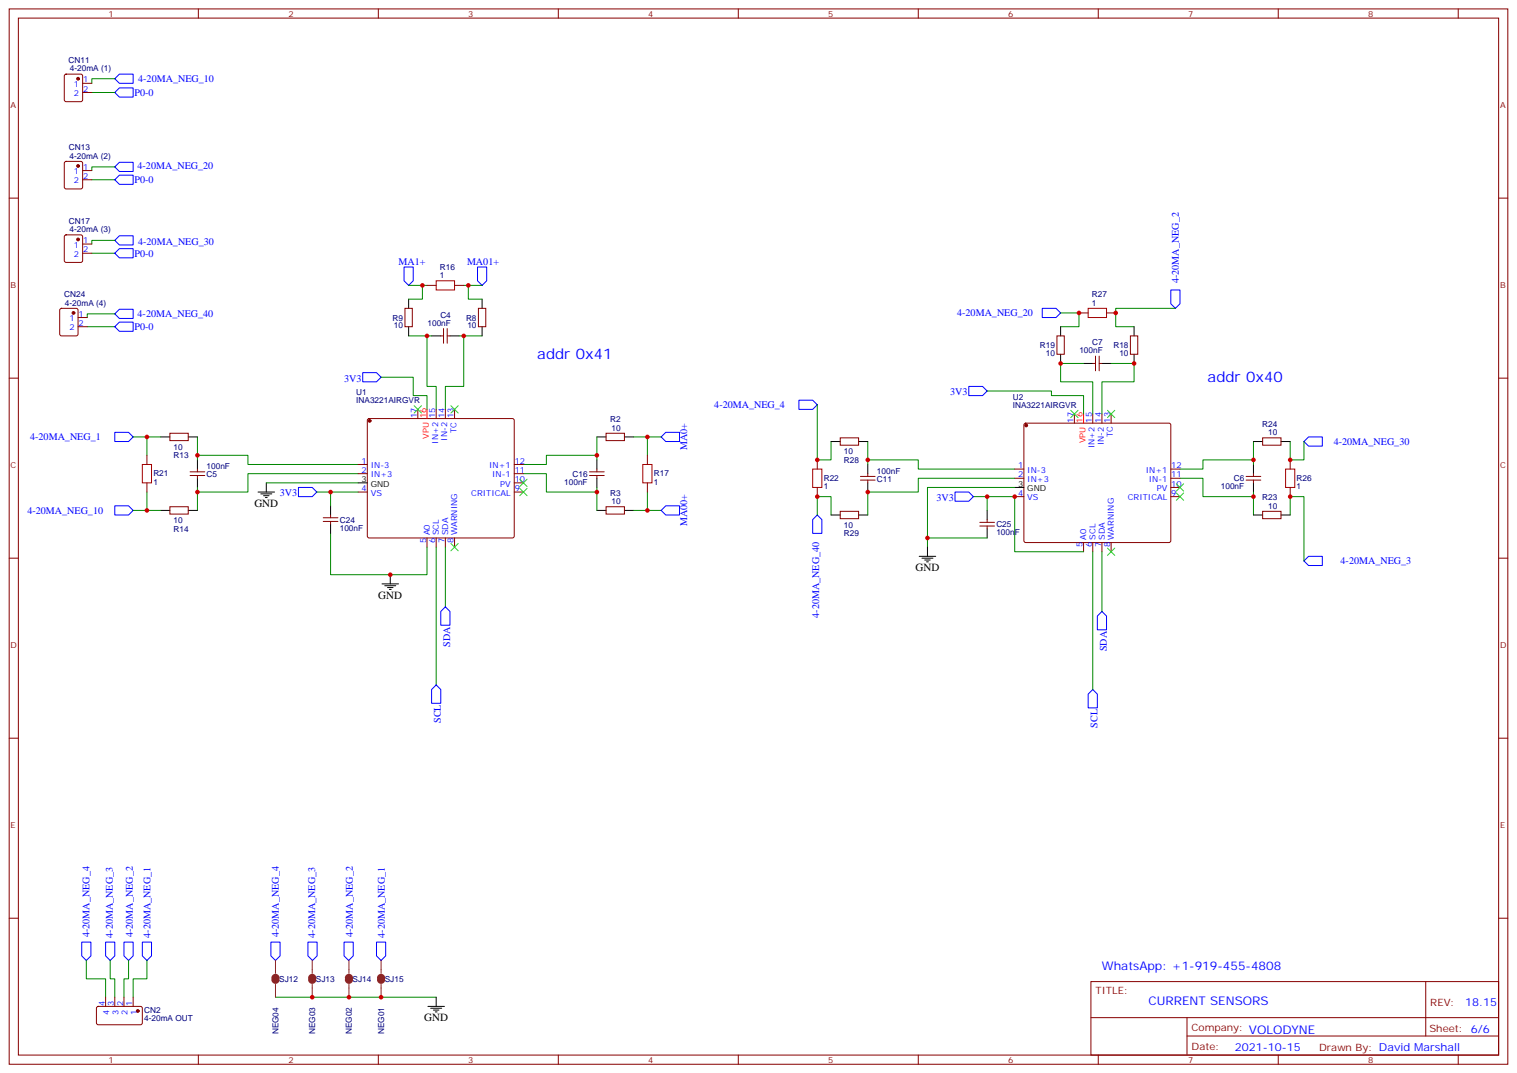
[picture p45: page 3]

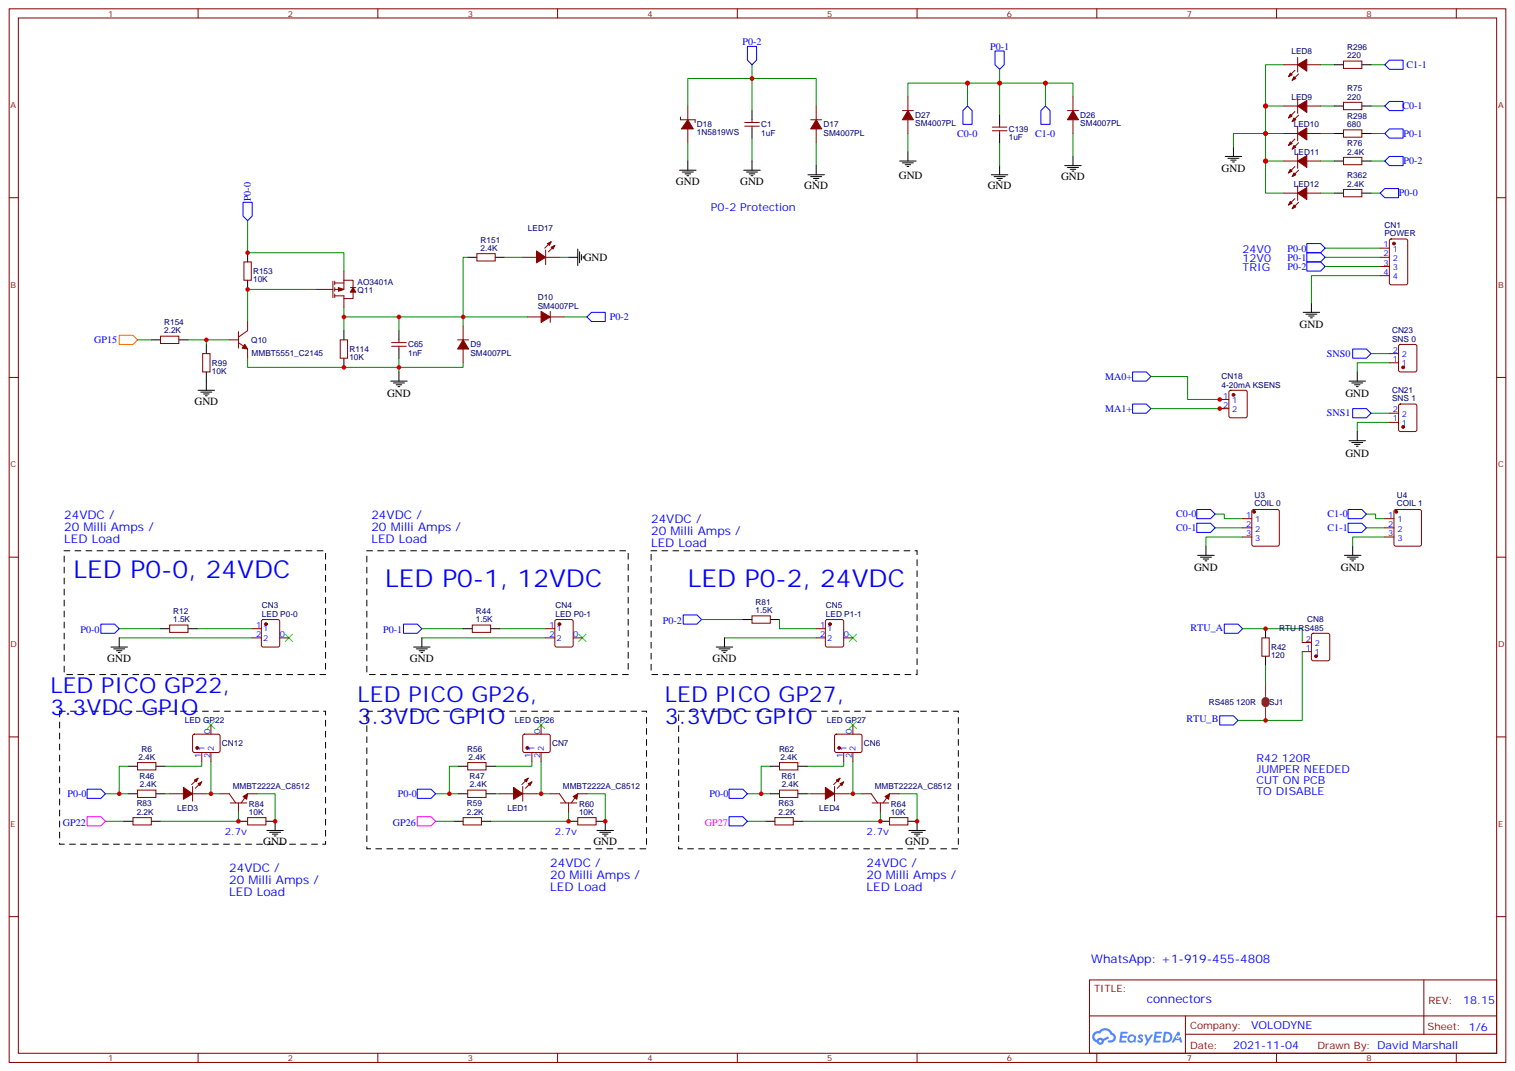
[picture p46: page 4]

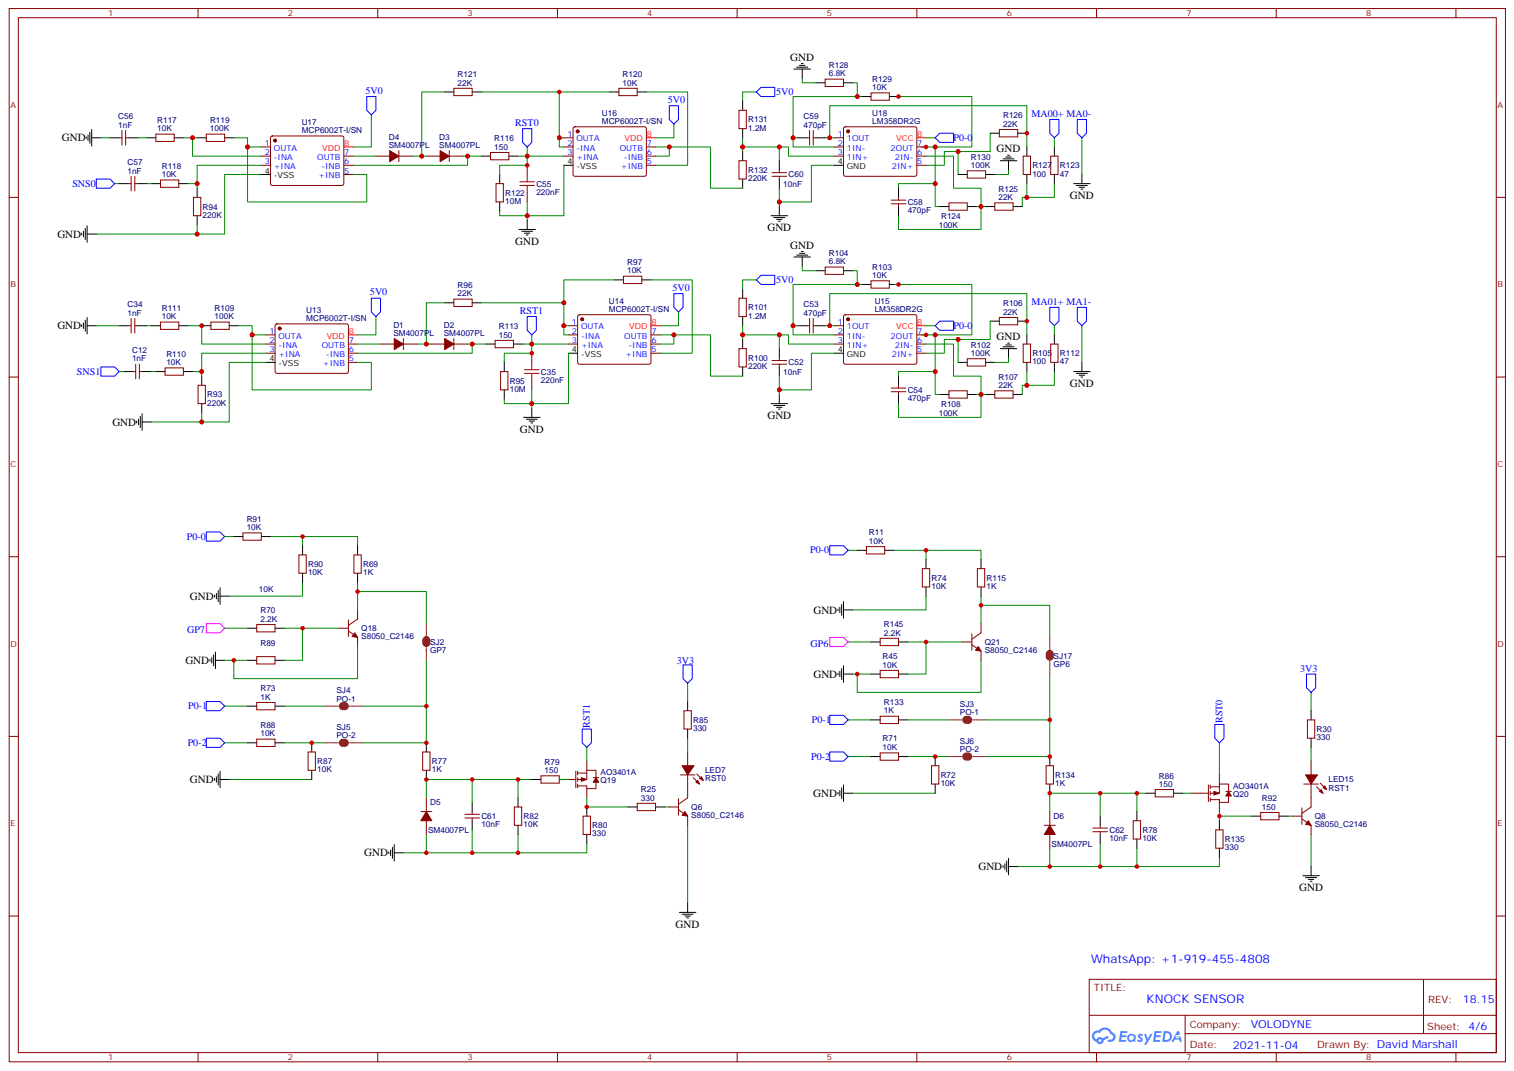
[picture p47: page 5]

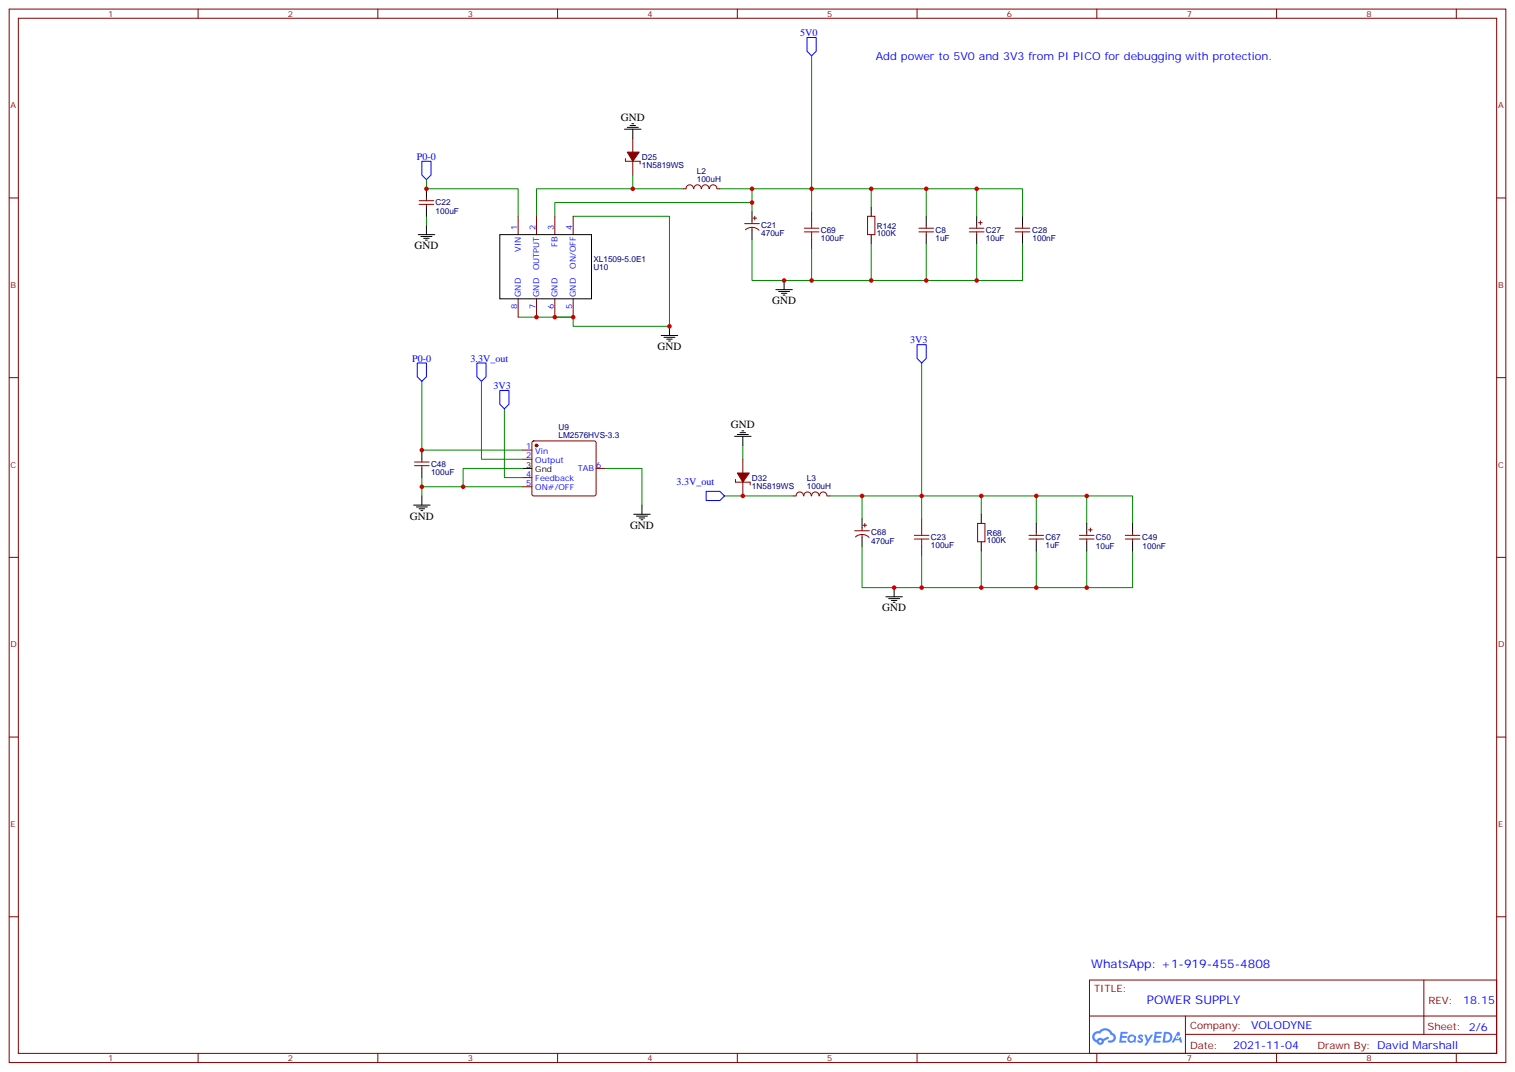
[picture p48: page 6]

Add power to 5V0 and 3V3 from PI PICO for debugging with protection.
