Shoziiii/David_marshal_project/19.20.pdf

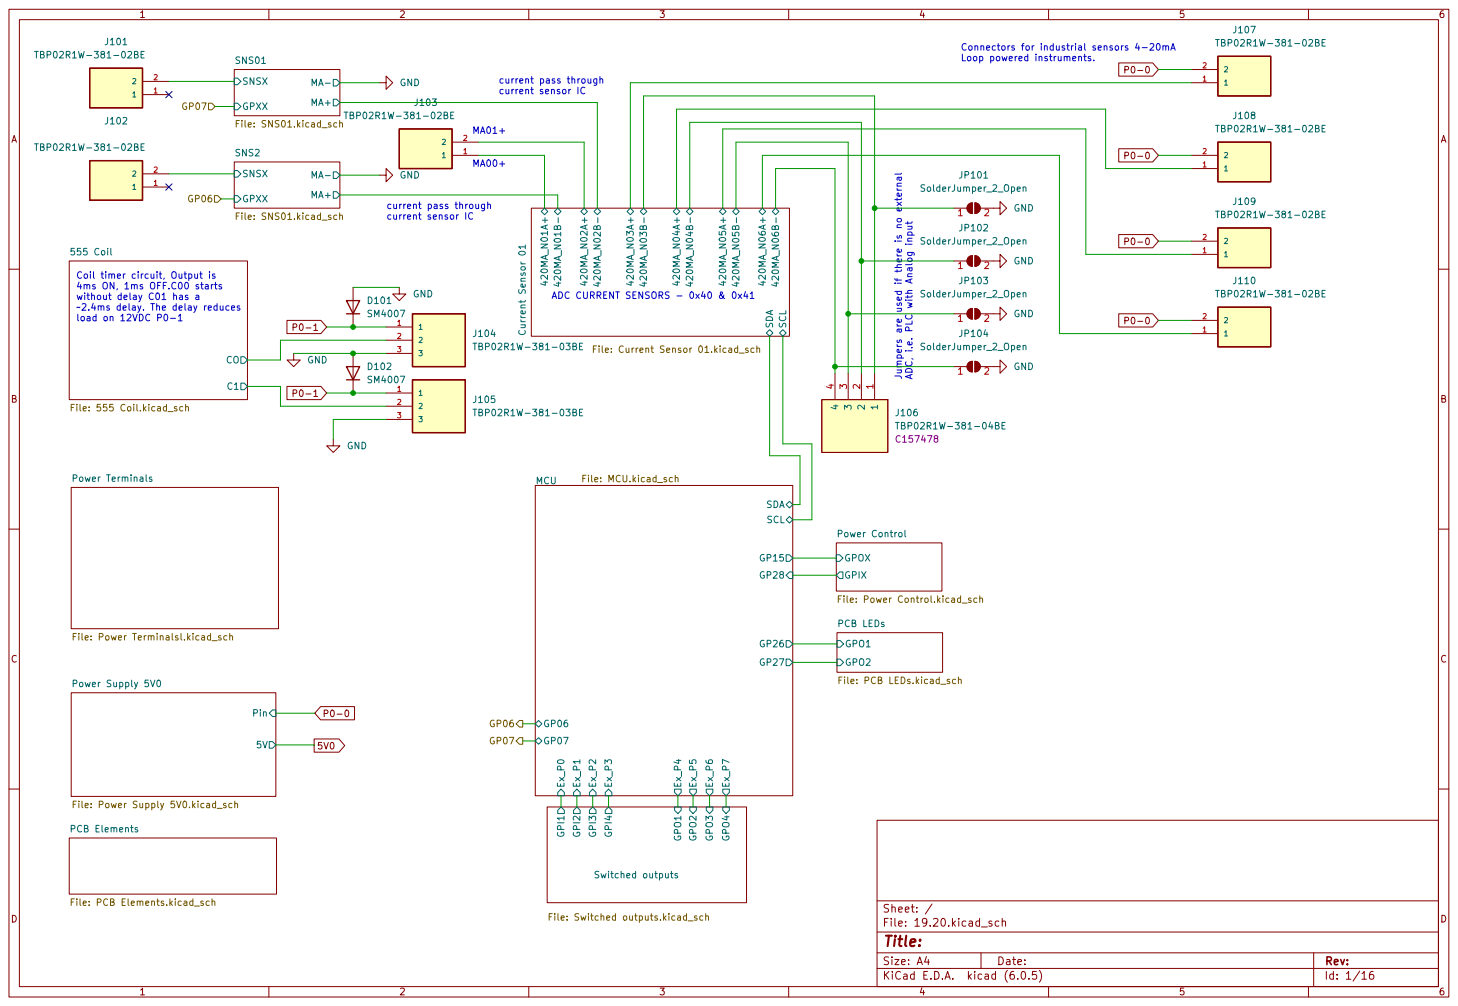
[picture p49: page 1]

Loop powered instruments. Jumpers are used if there is no external ADC, i.e. PLC with Analog input MA01+

current pass through current sensor IC

File: Power Supply 5V0.kicad_sch Power Terminals File: Power Terminalsl.kicad_sch

ADC CURRENT SENSORS - 0x40 & 0x41 Coil timer circuit, Output is 4ms ON, 1ms OFF.C00 starts without delay C01 has a

~2.4ms delay. The delay reduces

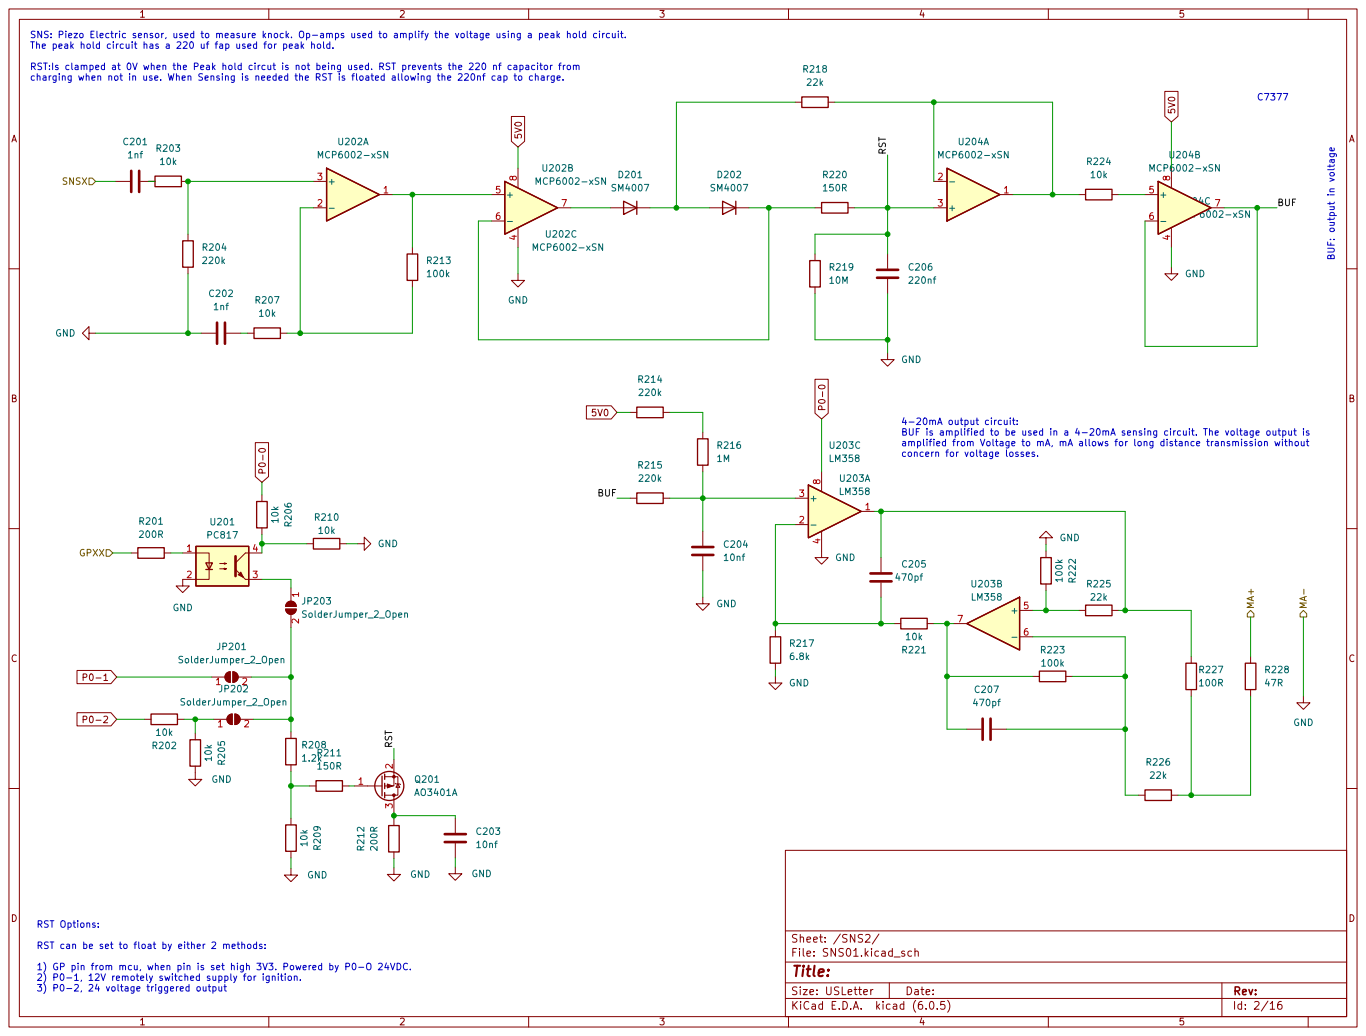
[picture p50: page 2]

SNS: Piezo Electric sensor, used to measure knock. Op-amps used to amplify the voltage using a peak hold circuit.
The peak hold circuit has a 220 uf fap used for peak hold.

RST:Is clamped at 0V when the Peak hold circut is not being used. RST prevents the 220 nf capacitor from
charging when not in use. When Sensing is needed the RST is floated allowing the 220nf cap to charge.

4-20mA output circuit:
BUF is amplified to be used in a 4-20mA sensing circuit. The voltage output is
amplified from Voltage to mA, mA allows for long distance transmission without
concern for voltage losses.

RST can be set to float by either 2 methods:

1) GP pin from mcu, when pin is set high 3V3. Powered by P0-O 24VDC.
2) P0-1, 12V remotely switched supply for ignition.
3) P0-2, 24 voltage triggered output

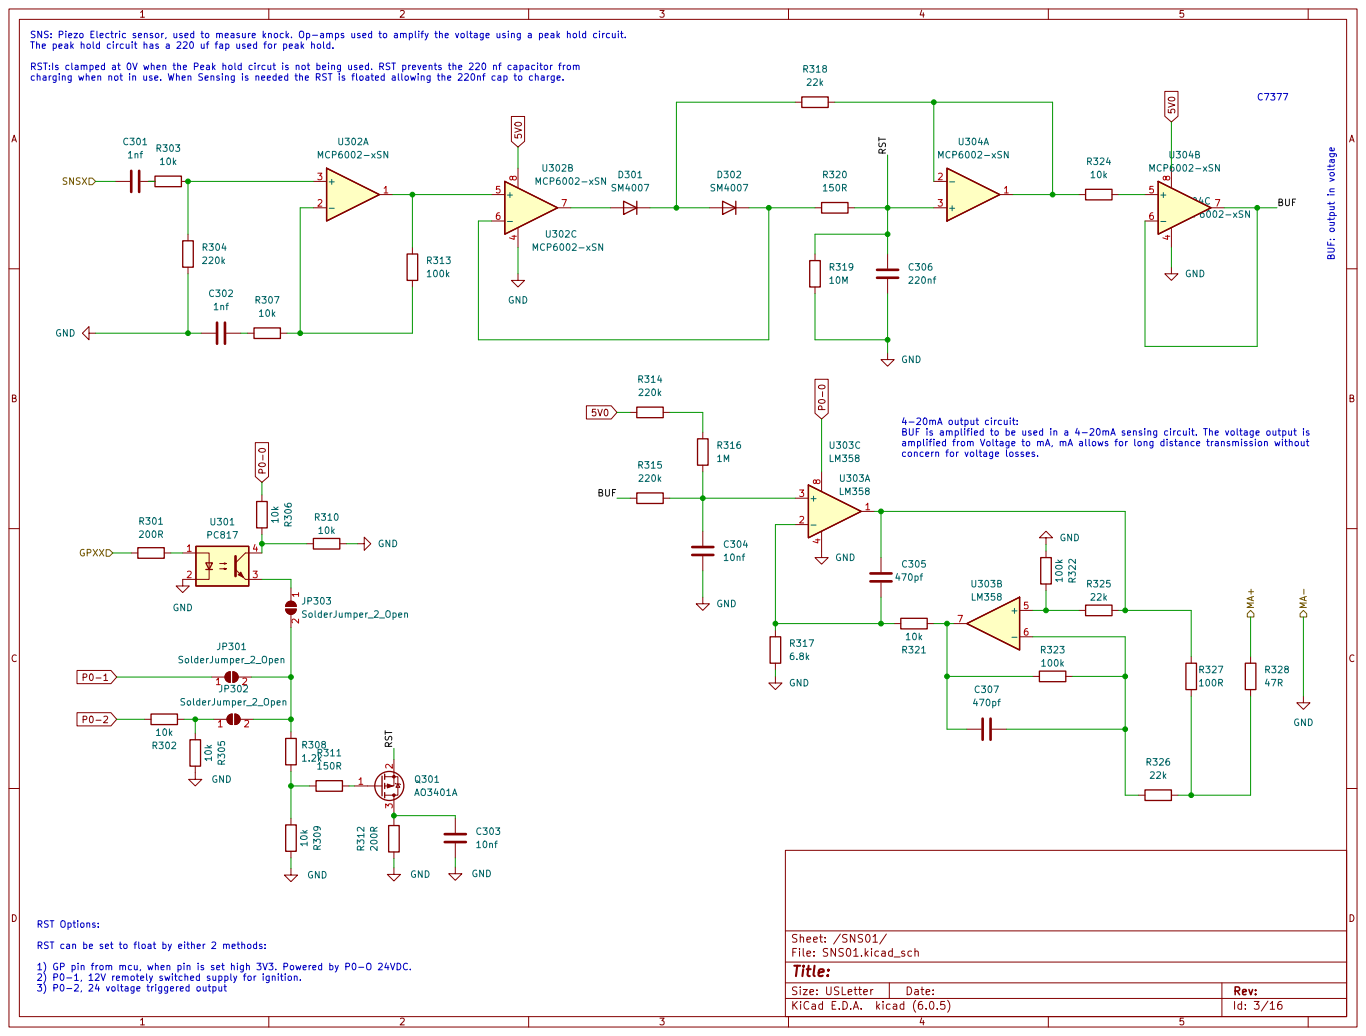
[picture p51: page 3]

SNS: Piezo Electric sensor, used to measure knock. Op-amps used to amplify the voltage using a peak hold circuit.
The peak hold circuit has a 220 uf fap used for peak hold.
7 U302B MCP6002-xSN R309 10k

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

RST can be set to float by either 2 methods:

1) GP pin from mcu, when pin is set high 3V3. Powered by P0-O 24VDC.
2) P0-1, 12V remotely switched supply for ignition.
3) P0-2, 24 voltage triggered output

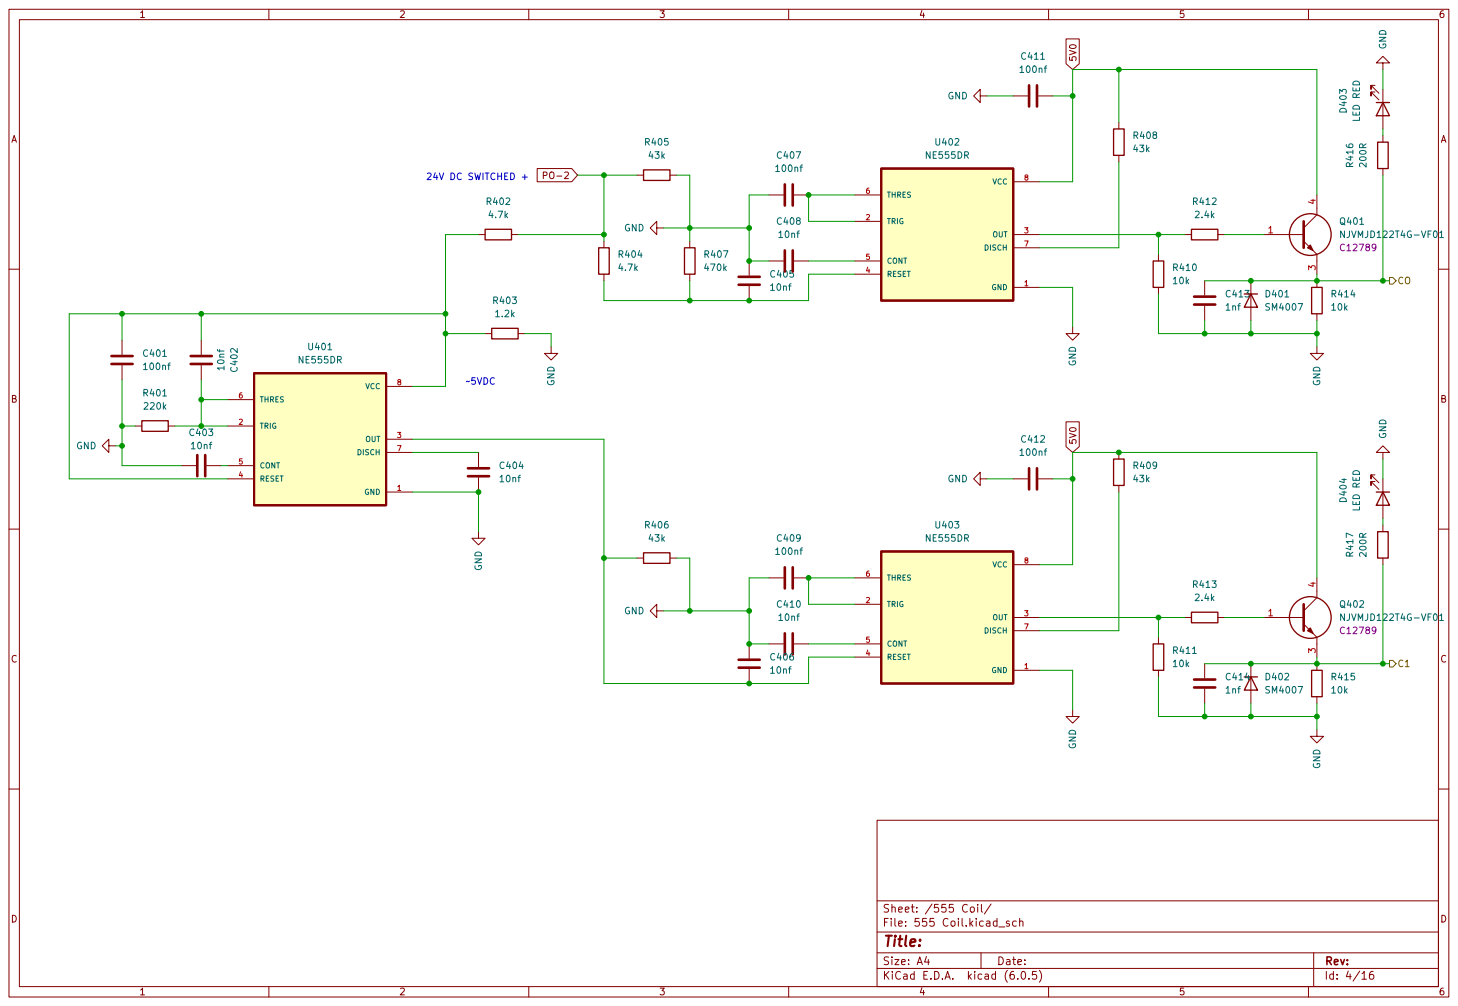
[picture p52: page 4]


Sheet: /Power Supply 5V0/ GND


File: Current Sensor 01.kicad_sch Sheet: /Current Sensor 01/


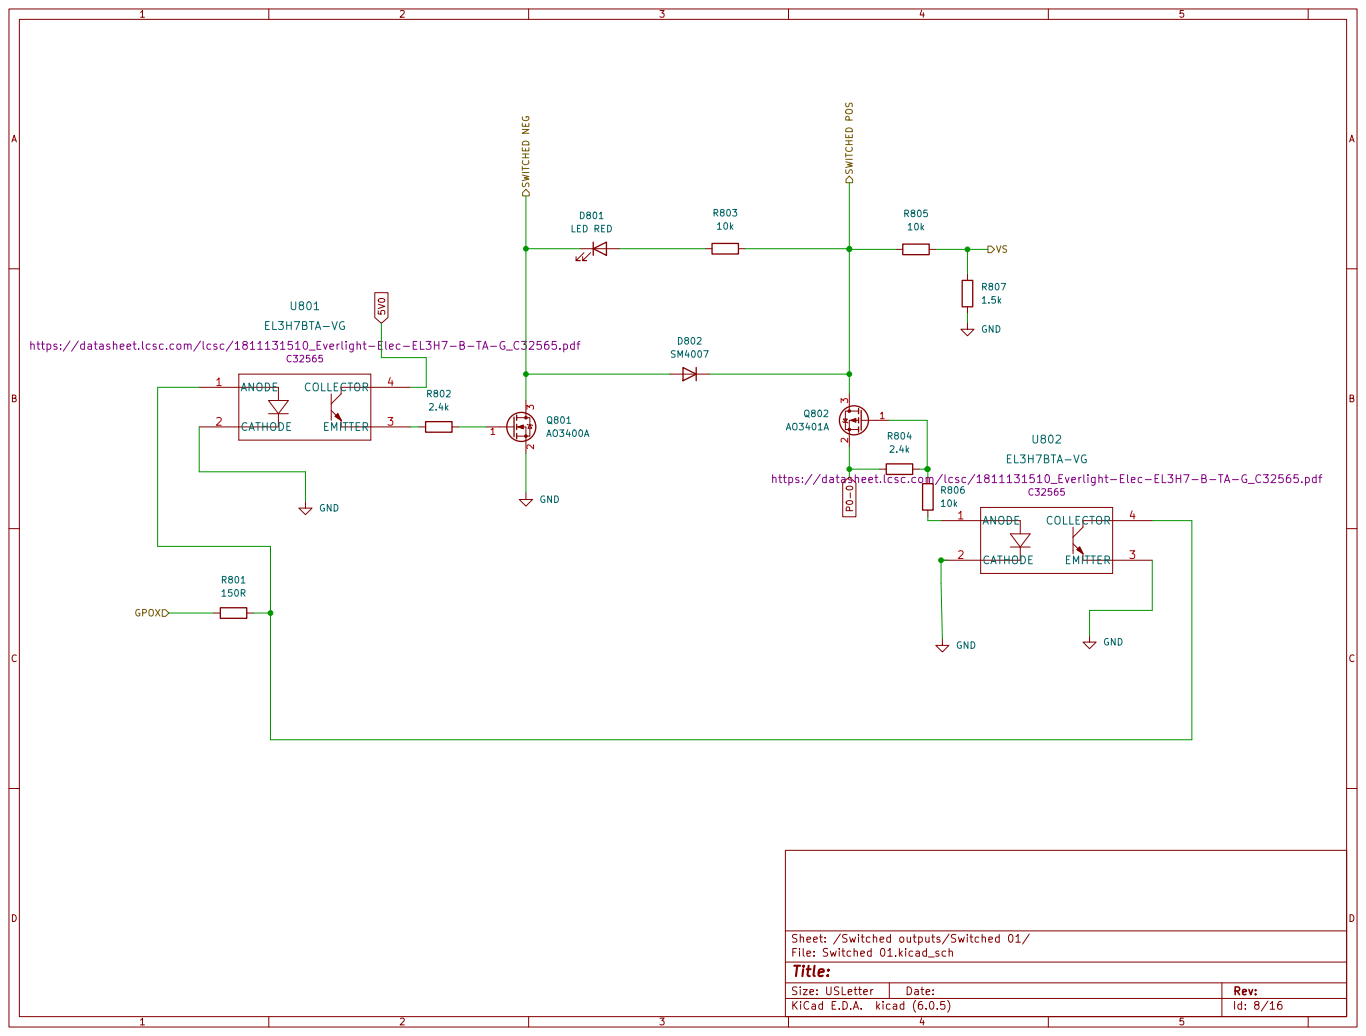
[picture p53: page 8]

https://datasheet.lcsc.com/lcsc/1811131510_Everlight-Elec-EL3H7-B-TA-G_C32565.pdf C32565

Sheet: /Switched outputs/Switched 01/ R801

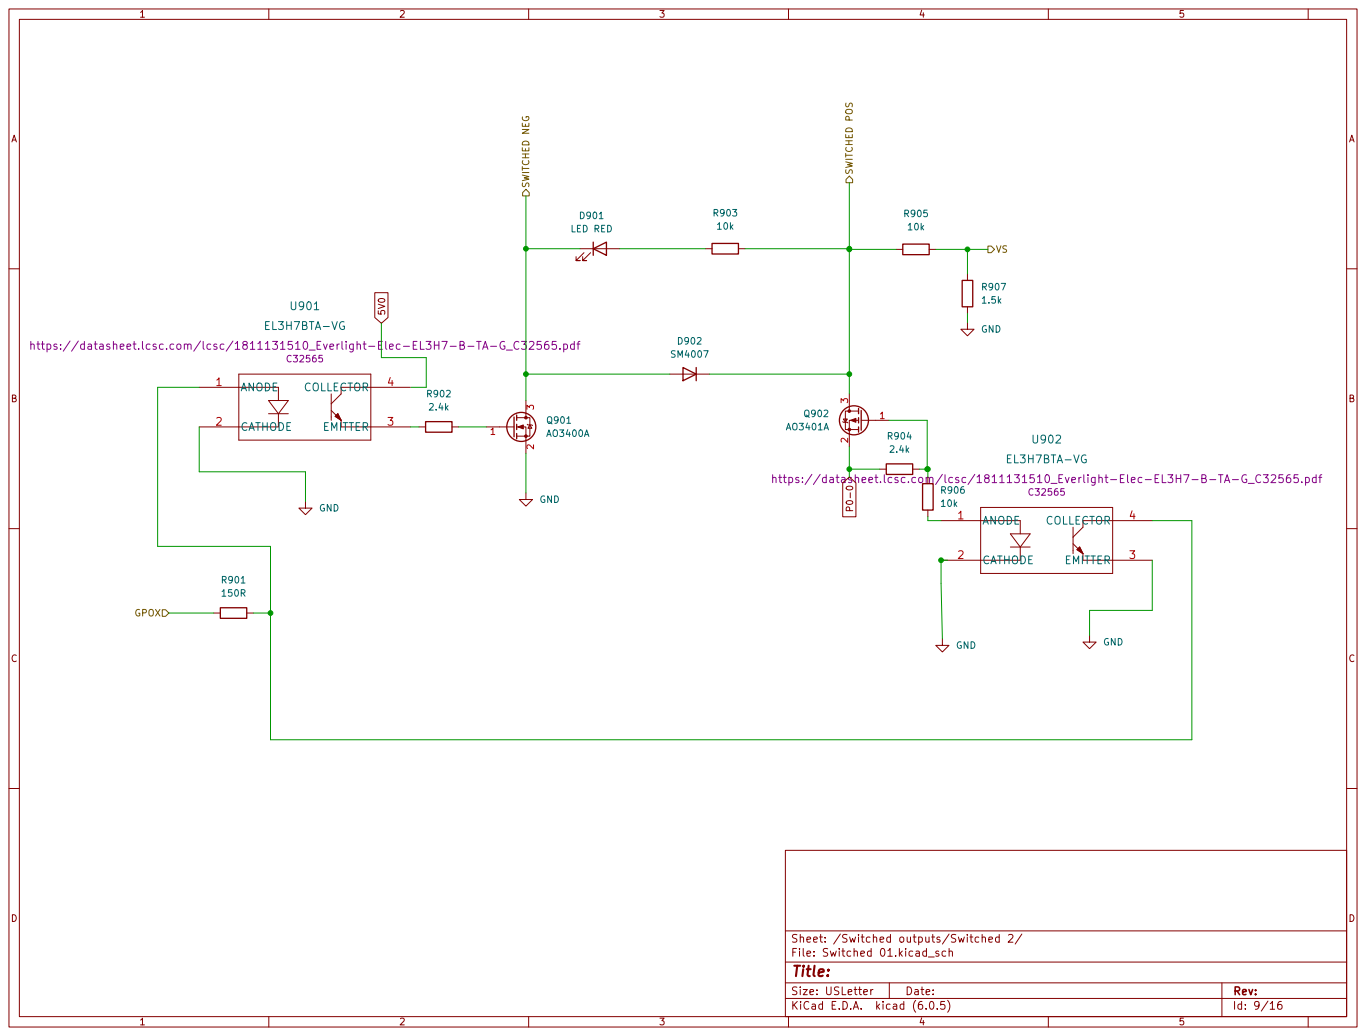
[picture p54: page 9]

https://datasheet.lcsc.com/lcsc/1811131510_Everlight-Elec-EL3H7-B-TA-G_C32565.pdf C32565

Sheet: /Switched outputs/Switched 2/ R901

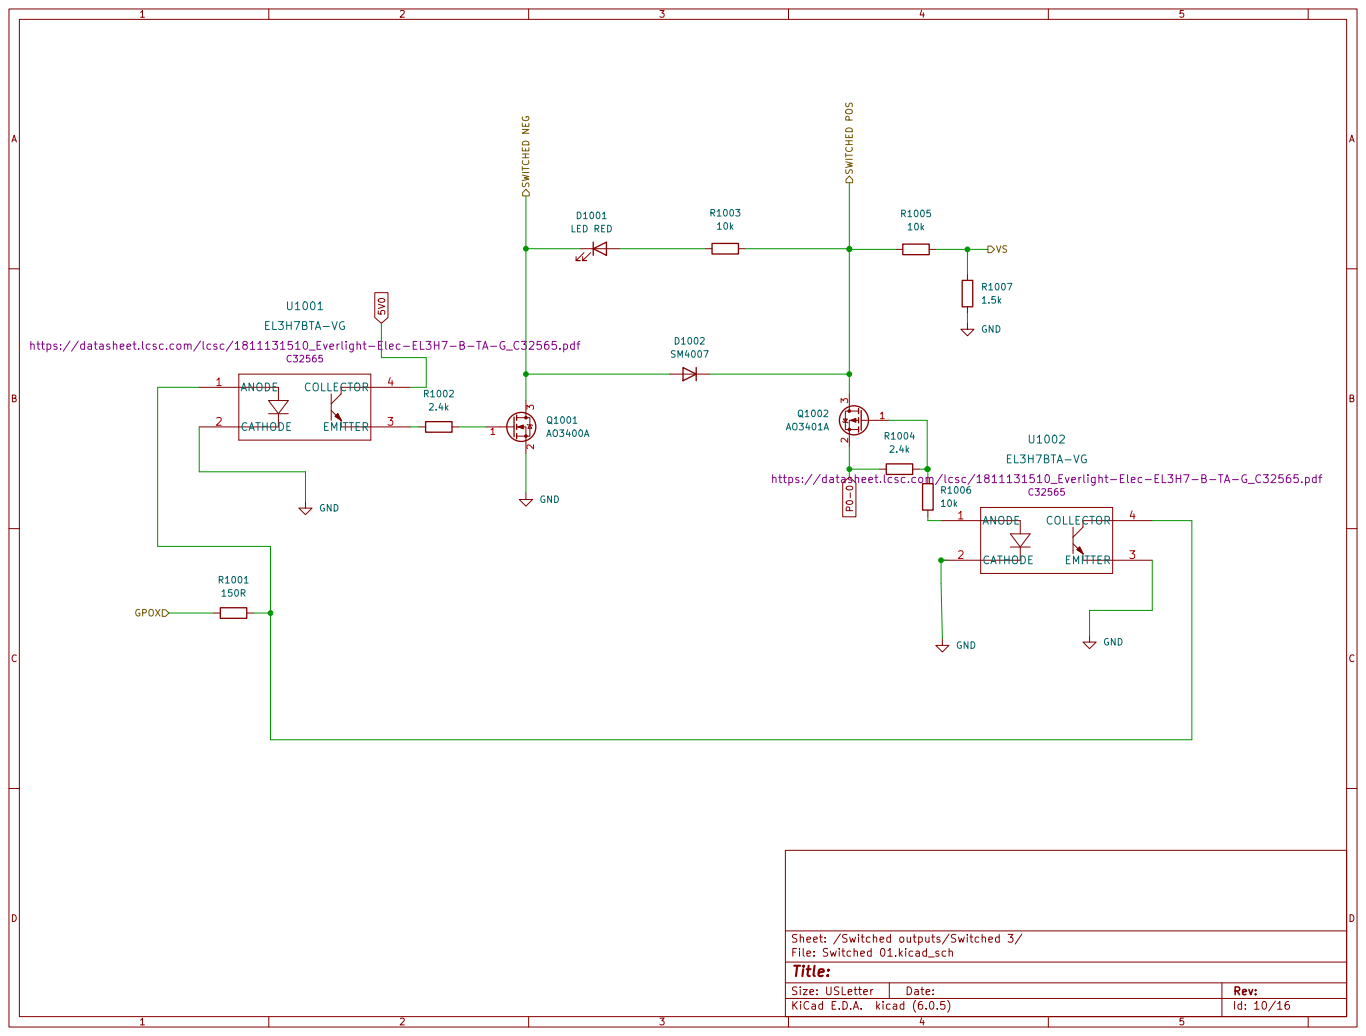
[picture p55: page 10]

https://datasheet.lcsc.com/lcsc/1811131510_Everlight-Elec-EL3H7-B-TA-G_C32565.pdf C32565

Sheet: /Switched outputs/Switched 3/ R1001

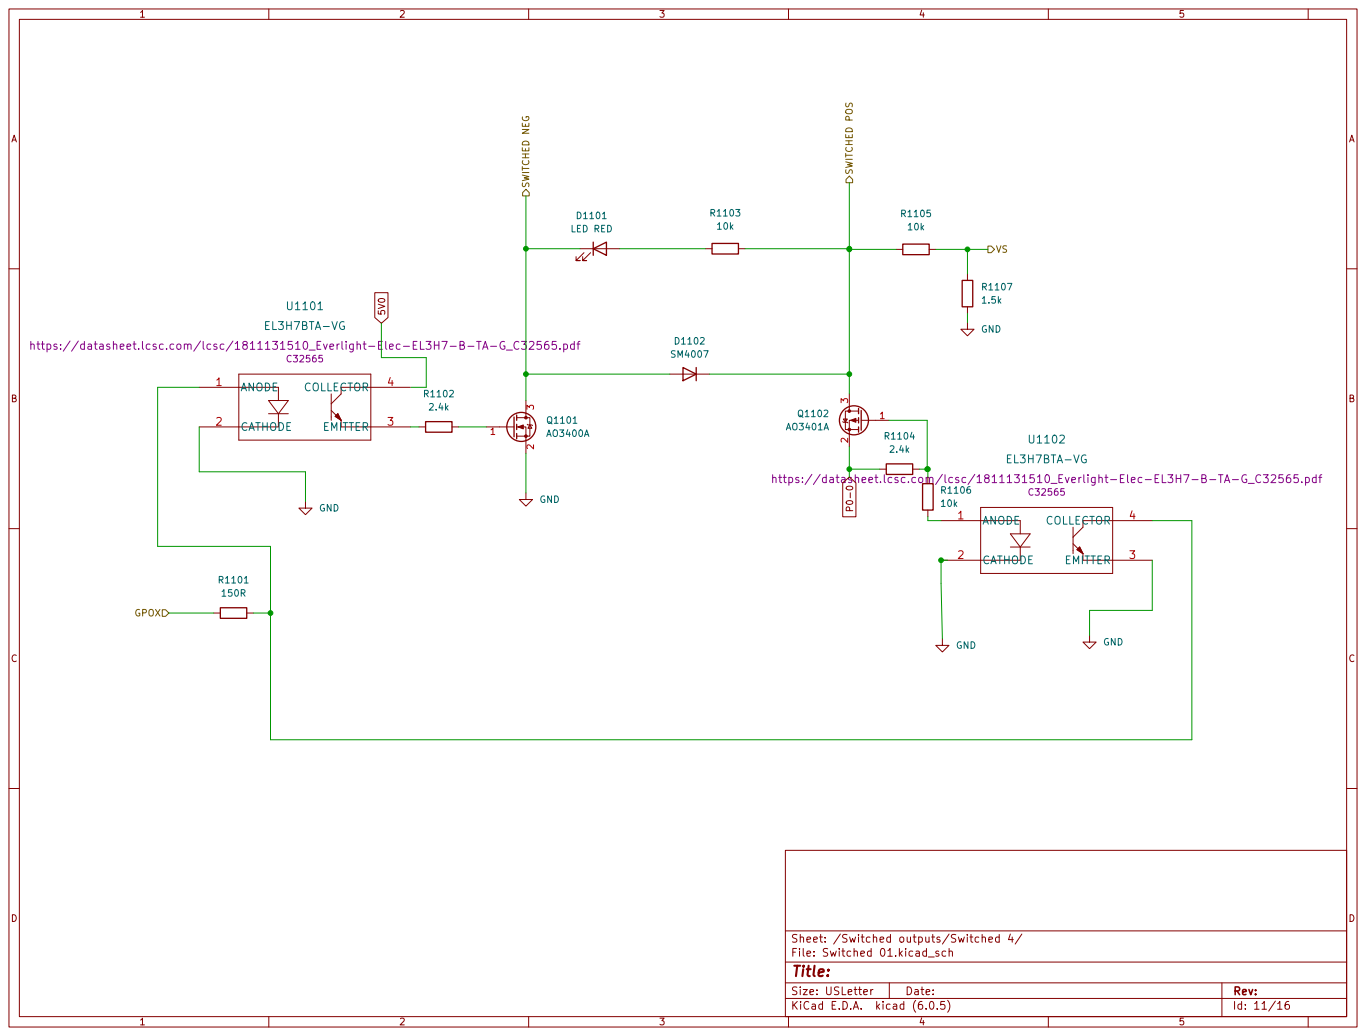
[picture p56: page 11]

https://datasheet.lcsc.com/lcsc/1811131510_Everlight-Elec-EL3H7-B-TA-G_C32565.pdf C32565

Sheet: /Switched outputs/Switched 4/ R1101


File: PCB Elements.kicad_sch Sheet: /PCB Elements/
Id: 12/16 Title:


File: PCB LEDs.kicad_sch Sheet: /PCB LEDs/
Id: 13/16 Title:

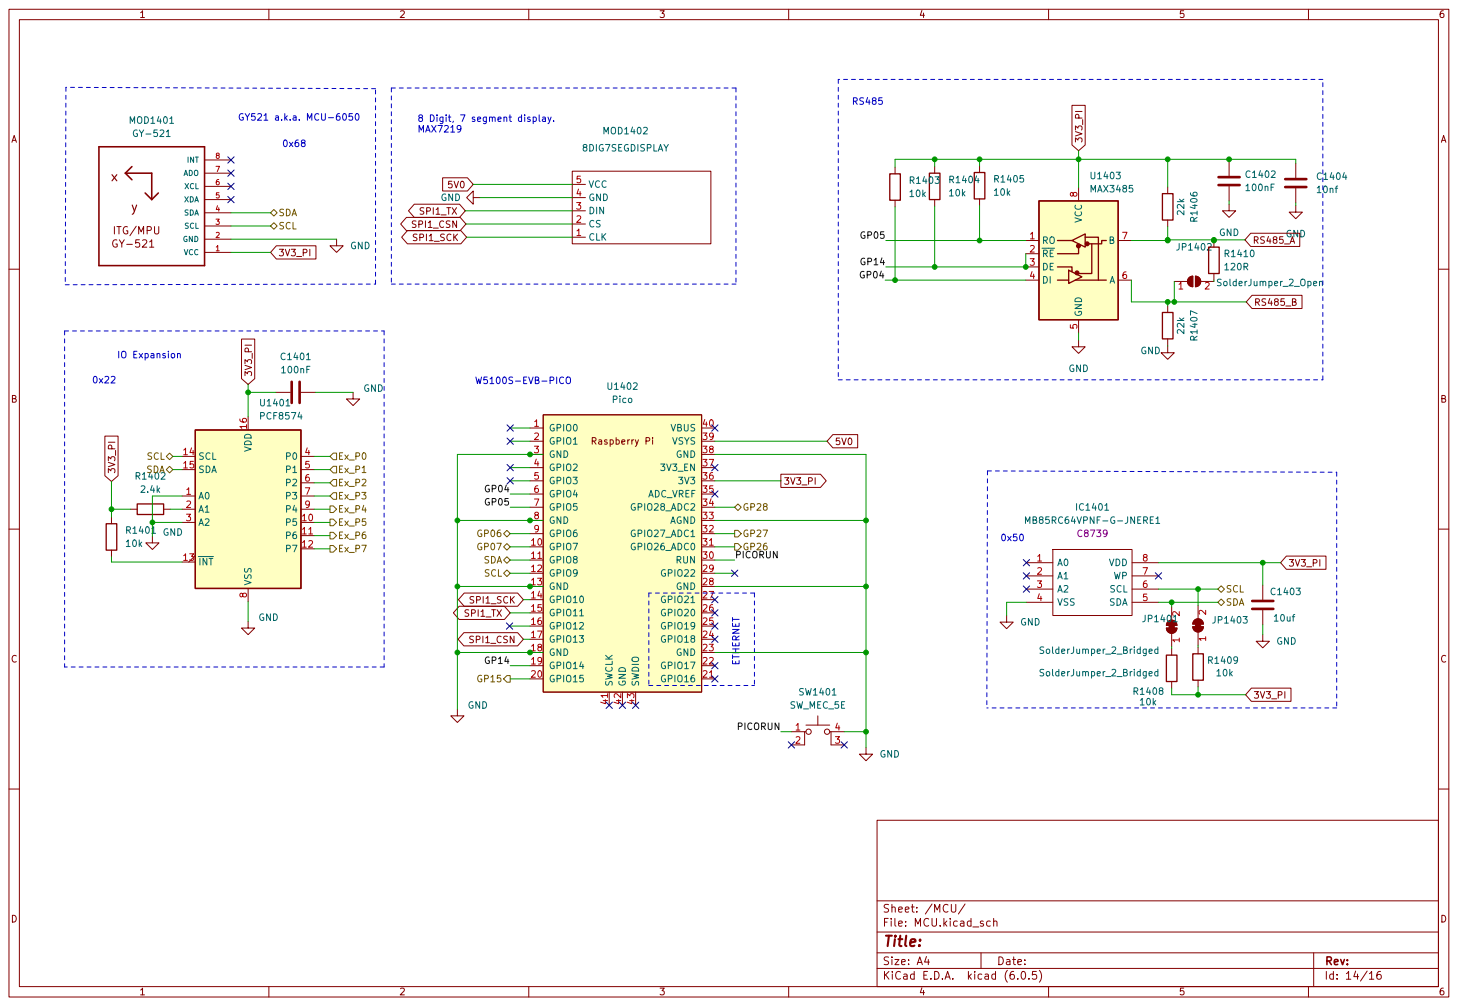
[picture p57: page 14]

File: MCU.kicad_sch Sheet: /MCU/
Id: 14/16 Title:

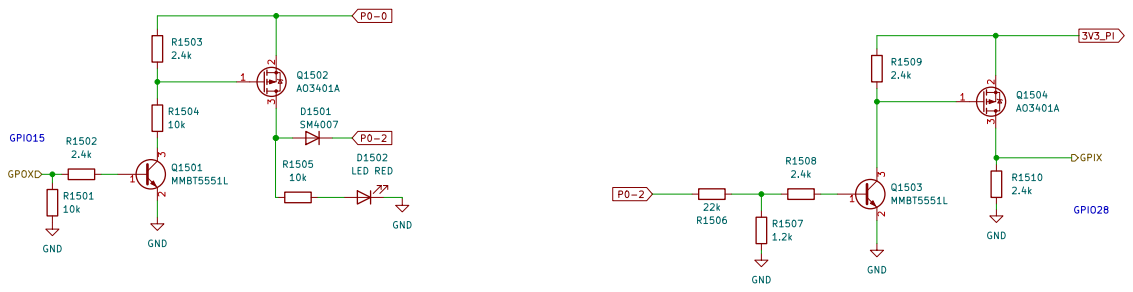
[picture p58: page 15]

File: Power Control.kicad_sch Sheet: /Power Control/ GND


File: Power Terminalsl.kicad_sch Sheet: /Power Terminals/
Id: 16/16 Title:
