Shoziiii/David_marshal_project/4220-0500-0400-0350-0105-00.pdf

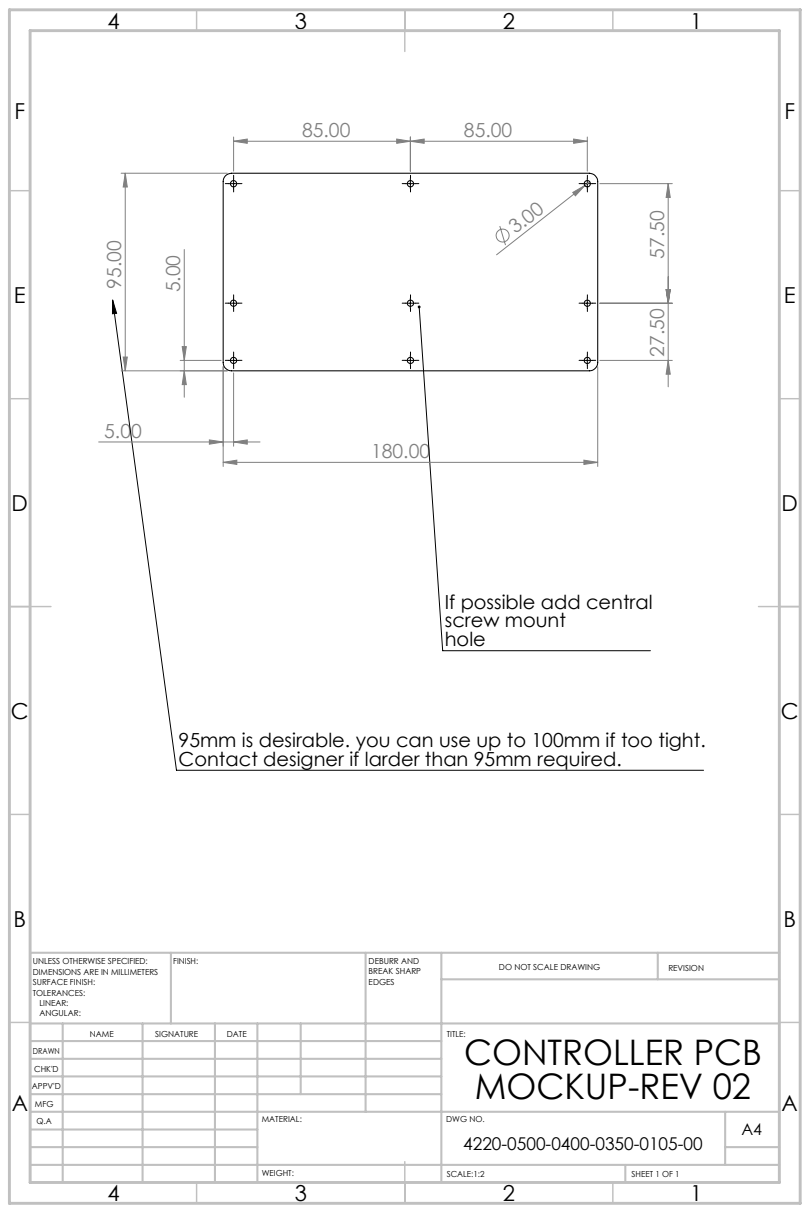
[picture p59: page 1]
FINISH:; DEBURR AND; BREAK SHARP; DO NOT SCALE DRAWING; REVISION; SCALE:1:2; SHEET 1 OF 1

If possible add central
screw mount
hole

95mm is desirable. you can use up to 100mm if too tight.
Contact designer if larder than 95mm required.

UNLESS OTHERWISE SPECIFIED:
DIMENSIONS ARE IN MILLIMETERS
SURFACE FINISH:
TOLERANCES:
LINEAR:
ANGULAR:

NAME | SIGNATURE | DATE | | | | TITLE: CONTROLLER PCB MOCKUP-REV 02

DRAWN
CHK'D
APPV'D
MFG
Q.A | | | | MATERIAL: | DWG NO. 4220-0500-0400-0350-0105-00 | A4
