Shoziiii/David_marshal_project/CAD MODELS/CAD MODELS/WJ15EDGVM-3.81-04P-14-00A.pdf

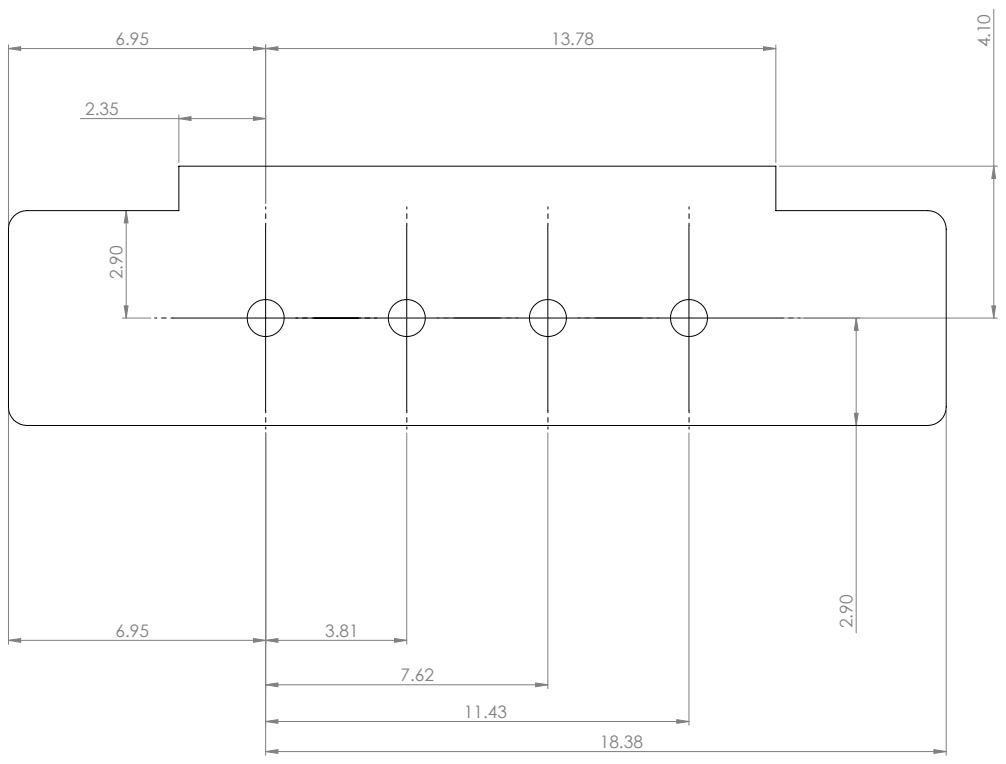
[picture p60: page 1]
