Shoziiii/David_marshal_project/PCB 18.16 AS ORDERED/PCB 18.16 AS ORDERED/Prob 1 3 5 Sims B4 Aftr_01/Prob 1 3 5 Sims B4 Aftr_01/Prob 1_After.asc

D1: LED; NSCW100
Q1: npn; 2N3904
R1: res; 1k
R2: res; 4.7k
R3: res; 10k
R4: res; 10k
R5: res; 2.2k
R6: res; 10k
R7: res; 220
U1: PC817A
V1: voltage; 12v
V2: voltage; 5v
V3: voltage; 3.3v
Named nets: 0
.tran 0 1s 0 1m
