Shoziiii/David_marshal_project/PCB 18.16 AS ORDERED/PCB 18.16 AS ORDERED/Prob 1 3 5 Sims B4 Aftr_01/Prob 1 3 5 Sims B4 Aftr_01/Prob 1_Before.asc

D1: diode
M1: pmos; RRS040P03
Q1: npn; 2N3904
Q2: npn; 2N3904
R2: res; 4.7k
R3: res; 10k
R4: res; 10k
R5: res; 2.2k
R7: res; 10k
R8: res; 10k
V1: voltage; 12v
V2: voltage; 5v
V3: voltage; 3.3v
Named nets: 0
.tran 0 1s 0 1m
