Shoziiii/David_marshal_project/PCB 18.16 AS ORDERED/PCB 18.16 AS ORDERED/Prob 1 3 5 Sims B4 Aftr_01/Prob 1 3 5 Sims B4 Aftr_01/Prob 3_After.asc

C1: cap; 1µ; V=16v
D1: LED; NSPW500BS
D2: diode; MURS120
D3: LED; NSCW100
R1: res; 4.7k
R2: res; 330
R3: res; 10k
R4: res; 10k
R5: res; 220
U1: PC817A
V1: voltage; 3.3v
V2: voltage; 24v
Named nets: 0
.tran 0 1s 0 1m
