Shoziiii/David_marshal_project/PCB 18.16 AS ORDERED/PCB 18.16 AS ORDERED/Prob 1 3 5 Sims B4 Aftr_01/Prob 1 3 5 Sims B4 Aftr_01/Prob 3_Before.asc

C1: cap; 1n
D1: diode
D2: diode; 1SR154-600
D3: LED; NSCW100
D4: diode; 1SR154-600
M1: pmos; RRS040P03
Q2: npn; 2N3904
R1: res; 10k
R2: res; 10k
R5: res; 2.4k
R7: res; 10k
R9: res; 2.2k
V1: voltage; 3.3v
V2: voltage; 24v
V3: voltage; 12v
Named nets: 0
.tran 0 1s 0 1m
