Shoziiii/David_marshal_project/PCB 18.16 AS ORDERED/PCB 18.16 AS ORDERED/Prob 1 3 5 Sims B4 Aftr_01/Prob 1 3 5 Sims B4 Aftr_01/Prob 5_AFTER DJM.asc

Q2: npn; 2N3904
R1: res; 10k
R2: res; 10k
R3: res; 10k
R4: res; 10k
R9: res; 1k
V1: voltage; 3.3V
V2: voltage; 24v
Named nets: 0
.tran 0 1s 0 1m
