Shoziiii/David_marshal_project/PCB 18.16 AS ORDERED/PCB 18.16 AS ORDERED/Prob 1 3 5 Sims B4 Aftr_01/Prob 1 3 5 Sims B4 Aftr_01/Prob 5_After.asc

D1: LED; NSCW100
Q2: npn; 2N3904
R2: res; 1
R3: res; 10k
R4: res; 10k
R5: res; 10k
R9: res; 1
V1: voltage; 3.3v
V2: voltage; 24v
Named nets: 0
.tran 0 1s 0 1m
