Shoziiii/David_marshal_project/(list of files, drawings)

Other design files:
PCB 18.16 AS ORDERED/PCB 18.16 AS ORDERED/SCH_DV_MR_rev_modbus_18.16_2022-01-16.json
PCB 18.16 AS ORDERED/PCB 18.16 AS ORDERED/Verified Max7219/Verified Max7219/Source files/bme280_spi/max7219_spi.fzz
