Shoziiii/David_marshal_project/19.20/19.20.kicad_pcb

## KiCad design 19.20/19.20.kicad_pcb (2022-06-06)

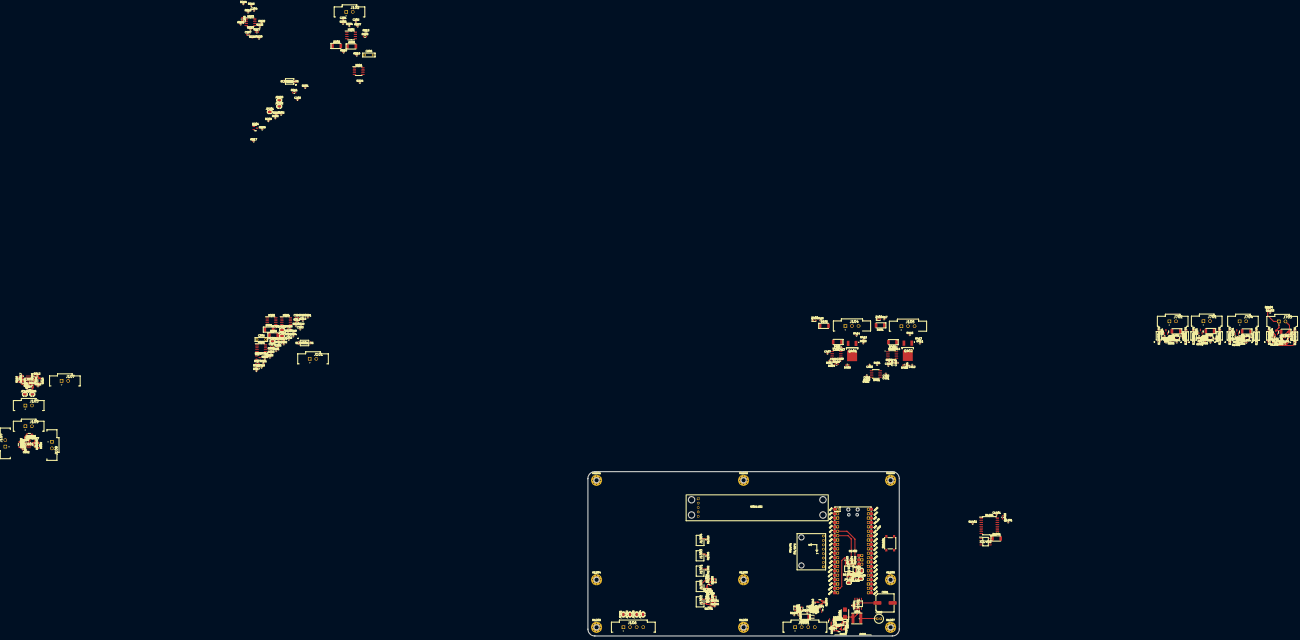
[picture p61: board 19.20.kicad_pcb from above]

Board: 2 copper layers, 180.0 x 95.0 mm, 313 parts (0 on the bottom side), 193 nets.

Parts:
C201, C202, C301, C302, C413, C414: 1nf; C_0402_1005Metric
C203, C204, C303, C304, C402, C403, C404, C405, C406, C408, C410, C1404: 10nf; C_0402_1005Metric
C205, C207, C305, C307: 470pf; C_0603_1608Metric
C206, C306: 220nf; C_Rect_L7.0mm_W2.0mm_P5.00mm
C401, C407, C409, C411, C412, C601, C602, C603, C604, C605, C606, C607, C608: 100nf; C_0402_1005Metric
C501: 470uF; C_Elec_10x10.2
C502: 1uf; C_0402_1005Metric
C503: 180uF; C_Radial_D5.0mm_H11.0mm_P2.00mm
C1401, C1402: 100nF; C_0402_1005Metric
C1403: 10uf; C_0603_1608Metric
D101, D102, D201, D202, D301, D302, D401, D402, D802, D902, D1002, D1102, D1501, D1501#2, D1602: SM4007; D_MELF
D403, D404, D801, D901, D1001, D1101, D1301, D1302, D1502, D1601, D1604, D1605: LED RED; LED_0603_1608Metric
D501: D_Schottky; D_SMB
D1603: D_Schottky; D_SOD-323
H1201, H1202, H1203, H1204, H1205, H1206, H1207, H1208, H1209: MountingHole_Pad; MountingHole_3.2mm_M3_Pad_Via
IC501: XL1509-5.0E1; SOIC127P600X175-8N
IC601, IC602: INA3221AIRGVR; QFN65P400X400X100-17N-D
IC1401: MB85RC64VPNF-G-JNERE1; SOIC127P600X175-8N
J101, J102, J103, J107, J108, J109, J110, J701, J702, J703, J704: TBP02R1W-381-02BE; 15EDGVM-3.81-02P-14-00A(H)
J104, J105: TBP02R1W-381-03BE; 15EDGVM-3.81-03P-14-00A(H)
J106, J1601: TBP02R1W-381-04BE; CUI_TBP02R1W-381-04GR-UPDATE
J1301, J1302, J1303, J1304, J1305: B2B-PH-K-S_LF__SN_; SHDR2W50P0X200_1X2_590X450X600P
JP101, JP102, JP103, JP104, JP105, JP106, JP201, JP202, JP203, JP301, JP302, JP303, JP1402: SolderJumper_2_Open; SolderJumper-2_P1.3mm_Open_RoundedPad1.0x1.5mm
JP1401, JP1403: SolderJumper_2_Bridged; SolderJumper-2_P1.3mm_Bridged_RoundedPad1.0x1.5mm
L501: 68uH; L_6.0x6.0_4.5
MOD1401: GY-521
MOD1402: 8DIG7SEGDISPLAY; 8DIG7SEDDISPLAY
Q201, Q301, Q802, Q902, Q1002, Q1102, Q1502, Q1504: AO3401A; SOT-23
Q401, Q402: NJVMJD122T4G-VF01; NJVMJD122T4GVF01
Q801, Q901, Q1001, Q1101: AO3400A; SOT-23
Q1301, Q1302, Q1501, Q1503: MMBT5551L; SOT-23
R201, R212, R301, R312, R416, R417: 200R; R_0402_1005Metric
R202, R203, R205, R207, R209, R221, R224, R302, R303, R305, R307, R309, R321, R324, R410, R411, R414, R415, R803, R805, R806, R903, R905, R906, R1003, R1005, R1006, R1103, R1105, R1106, R1301, R1304, R1307, R1309, R1401, R1403, R1404, R1405, R1408, R1409, R1501, R1504, R1505, R1602: 10k; R_0402_1005Metric
R204, R214, R215, R304, R314, R315, R401: 220k; R_0402_1005Metric
R208, R308, R403, R1306, R1507: 1.2k; R_0402_1005Metric
R211, R220, R311, R320, R801, R901, R1001, R1101: 150R; R_0603_1608Metric
R213, R222, R223, R313, R322, R323: 100k; R_0402_1005Metric
R216, R316: 1M; R_0402_1005Metric
R217, R317: 6.8k; R_0402_1005Metric
R218, R225, R318, R325, R1406, R1407, R1506, R1601, R1603: 22k; R_0402_1005Metric
R219, R319: 10M; R_0402_1005Metric
R226, R326: 22k; R_01005_0402Metric
R227, R327: 100R; R_0603_1608Metric
R228, R328: 47R; R_0402_1005Metric
R402, R404: 4.7k; R_0402_1005Metric
R405, R406, R408, R409: 43k; R_0603_1608Metric
R407: 470k; R_0402_1005Metric
R412, R413, R802, R804, R902, R904, R1002, R1004, R1102, R1104, R1302, R1303, R1305, R1308, R1310, R1311, R1402, R1502, R1503, R1508, R1509, R1510: 2.4k; R_0402_1005Metric
R601, R605, R609, R610, R614, R618: 20R; R_1206_3216Metric
R602, R603, R604, R606, R607, R608, R611, R612, R613, R615, R616, R617: 10R; R_0402_1005Metric
R807, R907, R1007, R1107: 1.5k; R_0402_1005Metric
R1410: 120R; R_0402_1005Metric
SW1401: SW_MEC_5E; SW_SPST_PTS645
U201, U301, U801, U802, U901, U902, U1001, U1002, U1101, U1102: EL3H7BTA-VG
U202, U204, U302, U304: MCP6002-xSN; SOIC-8_3.9x4.9mm_P1.27mm
U203, U303: LM358; SOIC-8_3.9x4.9mm_P1.27mm
U401, U402, U403: NE555DR; SOIC127P599X175-8N
U1401: PCF8574; SOIC-16W_7.5x10.3mm_P1.27mm
U1402: Pico; RPi_Pico_SMD_TH
U1403: MAX3485; SOIC127P600X175-8N 2

Connections:
3V3: C602.2, C606.1, IC601.4 (VS), IC601.16 (VPU), IC602.4 (VS), IC602.5 (A0), IC602.16 (VPU)
3V3_PI: C1401.2, C1402.1, C1403.2, C1404.2, IC1401.8 (VDD), MOD1401.1 (VCC), Q1504.2 (S), R1401.1, R1402.2, R1403.1, R1404.1, R1405.1, R1406.2, R1408.2, R1409.2, R1509.1, U1401.16 (VDD), U1402.36 (3V3), U1403.8 (VCC)
5V0: C411.2, C412.2, C503.1, IC501.3 (FEEDBACK), L501.2, MOD1402.5 (VCC), Q401.4, Q402.4, R214.1, R314.1, R408.1, R409.1, U202.8 (V+), U204.8 (V+), U302.8 (V+), U304.8 (V+), U402.8 (VCC), U403.8 (VCC), U801.4 (C), U901.4 (C), U1001.4 (C), U1101.4 (C), U1402.39 (VSYS)
/555 Coil/C1: C414.1, D402.1 (K), J105.2, Q402.3, R415.1, R417.2
/555 Coil/CO: C413.1, D401.1 (K), J104.2, Q401.3, R414.1, R416.2
/Current Sensor 01/420MA_N01A+: J103.1, JP105.2 (B), R616.2, R618.1
/Current Sensor 01/420MA_N01B-: R228.2, R617.2, R618.2
/Current Sensor 01/420MA_N02A+: J103.2, JP106.2 (B), R613.2, R614.1
/Current Sensor 01/420MA_N02B-: R328.2, R614.2, R615.2
/Current Sensor 01/420MA_N03A+: J107.1, R610.1, R612.2
/Current Sensor 01/420MA_N03B-: J106.1, JP101.1 (A), R610.2, R611.2
/Current Sensor 01/420MA_N04A+: J108.1, R607.2, R609.1
/Current Sensor 01/420MA_N04B-: J106.2, JP102.1 (A), R608.2, R609.2
/Current Sensor 01/420MA_N05A+: J109.1, R604.2, R605.2
/Current Sensor 01/420MA_N05B-: J106.3, JP103.1 (A), R605.1, R606.2
/Current Sensor 01/420MA_N06A+: J110.1, R601.2, R603.2
/Current Sensor 01/420MA_N06B-: J106.4, JP104.1 (A), R601.1, R602.2
/Current Sensor 01/SCL: IC601.6 (SCL), IC602.6 (SCL), IC1401.6 (SCL), JP1403.2 (B), MOD1401.3 (SCL), U1401.14 (SCL), U1402.12 (GPIO9)
/Current Sensor 01/SDA: IC601.7 (SDA), IC602.7 (SDA), IC1401.5 (SDA), JP1401.2 (B), MOD1401.4 (SDA), U1401.15 (SDA), U1402.11 (GPIO8)
/GP06: R201.1, U1402.9 (GPIO6)
/GP07: R301.1, U1402.10 (GPIO7)
/MCU/Ex_P0: R805.2, R807.1, U1401.4 (P0)
/MCU/Ex_P1: R905.2, R907.1, U1401.5 (P1)
/MCU/Ex_P2: R1005.2, R1007.1, U1401.6 (P2)
/MCU/Ex_P3: R1105.2, R1107.1, U1401.7 (P3)
/MCU/Ex_P4: R801.1, U1401.9 (P4)
/MCU/Ex_P5: R901.1, U1401.10 (P5)
/MCU/Ex_P6: R1001.1, U1401.11 (P6)
/MCU/Ex_P7: R1101.1, U1401.12 (P7)
/MCU/GP04: R1403.2, U1402.6 (GPIO4), U1403.4 (DI)
/MCU/GP05: R1405.2, U1402.7 (GPIO5), U1403.1 (RO)
/MCU/GP14: R1404.2, U1402.19 (GPIO14), U1403.2 (~RE), U1403.3 (DE)
/MCU/GP15: R1501.1, R1502.2, U1402.20 (GPIO15)
/MCU/GP26: R1301.2, R1303.2, U1402.31 (GPIO26_ADC0)
/MCU/GP27: R1307.2, R1308.2, U1402.32 (GPIO27_ADC1)
/MCU/GP28: Q1504.3 (D), R1510.2, U1402.34 (GPIO28_ADC2)
/MCU/PICORUN: SW1401.1, U1402.30 (RUN)
/SNS01/BUF: R315.1, U304.6 (-), U304.7
/SNS01/RST: C306.2, Q301.2 (S), R319.1, R320.2, U304.3 (+)
/SNS01/SNSX: C301.1, J101.2
/SNS2/BUF: R215.1, U204.6 (-), U204.7
/SNS2/RST: C206.2, Q201.2 (S), R219.1, R220.2, U204.3 (+)
/SNS2/SNSX: C201.1, J102.2
/Switched outputs/Switched 01/SWITCHED NEG: D801.1 (K), D802.2 (A), J702.1, Q801.3 (D)
/Switched outputs/Switched 01/SWITCHED POS: D802.1 (K), J702.2, Q802.3 (D), R803.2, R805.1
/Switched outputs/Switched 2/SWITCHED NEG: D901.1 (K), D902.2 (A), J701.1, Q901.3 (D)
/Switched outputs/Switched 2/SWITCHED POS: D902.1 (K), J701.2, Q902.3 (D), R903.2, R905.1
/Switched outputs/Switched 3/SWITCHED NEG: D1001.1 (K), D1002.2 (A), J704.1, Q1001.3 (D)
/Switched outputs/Switched 3/SWITCHED POS: D1002.1 (K), J704.2, Q1002.3 (D), R1003.2, R1005.1
/Switched outputs/Switched 4/SWITCHED NEG: D1101.1 (K), D1102.2 (A), J703.1, Q1101.3 (D)
/Switched outputs/Switched 4/SWITCHED POS: D1102.1 (K), J703.2, Q1102.3 (D), R1103.2, R1105.1
GND: C202.1, C203.1, C204.1, C206.1, C302.1, C303.1, C304.1, C306.1, C401.1, C403.1, C404.1, C405.2, C406.2, C407.1, C408.1, C409.1, C410.1, C411.1, C412.1, C413.2, C414.2, C501.2, C502.1, C503.2, C602.1, C606.2, C1401.1, C1402.2, C1403.1, C1404.1, D101.2 (A), D102.2 (A), D401.2 (A), D402.2 (A), D403.1 (K), D404.1 (K), D501.2 (A), D1502.1 (K), D1601.1 (K), D1602.2 (A), D1603.2 (A), D1604.1 (K), D1605.1 (K), H1201.1, H1202.1, H1203.1, H1204.1, H1205.1, H1206.1, H1207.1, H1208.1, H1209.1, IC501.5 (GND_1), IC501.6 (GND_2), IC501.7 (GND_3), IC501.8 (GND_4), IC601.3 (GND_1), IC601.5 (A0), IC602.3 (GND_1), IC1401.4 (VSS), J104.3, J105.3, J1301.2, J1303.2, J1304.2, J1601.4, JP101.2 (B), JP102.2 (B), JP103.2 (B), JP104.2 (B), JP105.1 (A), JP106.1 (A), MOD1401.2 (GND), MOD1402.4 (GND), Q801.2 (S), Q901.2 (S), Q1001.2 (S), Q1101.2 (S), Q1301.2 (E), Q1302.2 (E), Q1501.2 (E), Q1503.2 (E), R204.1, R205.1, R209.1, R212.2, R217.1, R219.2, R222.1, R304.1, R305.1, R309.1, R312.2, R317.1, R319.2, R322.1, R401.2, R403.2, R405.2, R406.2, R407.2, R410.2, R411.2, R414.2, R415.2, R807.2, R907.2, R1007.2, R1107.2, R1301.1, R1307.1, R1407.1, R1501.2, R1507.1, R1510.1, U201.2 (K), U202.4 (V-), U203.4 (V-), U204.4 (V-), U301.2 (K), U302.4 (V-), U303.4 (V-), U304.4 (V-), U401.1 (GND), U402.1 (GND), U403.1 (GND), U801.2 (K), U802.2 (K), U802.3 (E), U901.2 (K), U902.2 (K), U902.3 (E), U1001.2 (K), U1002.2 (K), U1002.3 (E), U1101.2 (K), U1102.2 (K), U1102.3 (E), U1401.1 (A0), U1401.3 (A2), U1401.8 (VSS), U1402.3 (GND), U1402.8 (GND), U1402.13 (GND), U1402.18 (GND), U1402.23 (GND), U1402.28 (GND), U1402.33 (AGND), U1402.38 (GND), U1403.5 (GND)
unnamed: C201.2, R203.2
unnamed: C202.2, R207.1
unnamed: C203.2, Q201.3 (D), R212.1
unnamed: C204.2, R215.2, R216.1, U203.3 (+)
unnamed: C205.1, R225.1, R227.1, U203.1
unnamed: C205.2, R217.2, R221.1, U203.2 (-)
unnamed: C207.1, R223.2, R226.1, U203.6 (-)
unnamed: C207.2, R221.2, R223.1, U203.7
unnamed: C301.2, R303.2
unnamed: C302.2, R307.1
unnamed: C303.2, Q301.3 (D), R312.1
unnamed: C304.2, R315.2, R316.1, U303.3 (+)
unnamed: C305.1, R325.1, R327.1, U303.1
unnamed: C305.2, R317.2, R321.1, U303.2 (-)
unnamed: C307.1, R323.2, R326.1, U303.6 (-)
unnamed: C307.2, R321.2, R323.1, U303.7
unnamed: C401.2, C402.1, R402.1, R403.1, U401.4 (RESET), U401.8 (VCC)
unnamed: C402.2, R401.1, U401.2 (TRIG), U401.6 (THRES)
unnamed: C403.2, U401.5 (CONT)
unnamed: C404.2, U401.7 (DISCH)
unnamed: C405.1, R404.2, R407.1, U402.4 (RESET)
unnamed: C406.1, R406.1, U401.3 (OUT), U403.4 (RESET)
unnamed: C407.2, U402.2 (TRIG), U402.6 (THRES)
unnamed: C408.2, U402.5 (CONT)
unnamed: C409.2, U403.2 (TRIG), U403.6 (THRES)
unnamed: C410.2, U403.5 (CONT)
unnamed: C601.1, IC601.2 (IN+3), R603.1
unnamed: C601.2, IC601.1 (IN-3), R602.1
unnamed: C603.1, IC601.15 (IN+2), R604.1
unnamed: C603.2, IC601.14 (IN-2), R606.1
unnamed: C604.1, IC601.12 (IN+1), R607.1
unnamed: C604.2, IC601.11 (IN-1), R608.1
unnamed: C605.1, IC602.2 (IN+3), R612.1
unnamed: C605.2, IC602.1 (IN-3), R611.1
unnamed: C607.1, IC602.15 (IN+2), R613.1
unnamed: C607.2, IC602.14 (IN-2), R615.1
unnamed: C608.1, IC602.12 (IN+1), R616.1
unnamed: C608.2, IC602.11 (IN-1), R617.1
unnamed: D201.1 (K), D202.2 (A), R218.1
unnamed: D201.2 (A), U202.7
unnamed: D202.1 (K), R220.1, U202.6 (-)
unnamed: D301.1 (K), D302.2 (A), R318.1
unnamed: D301.2 (A), U302.7
unnamed: D302.1 (K), R320.1, U302.6 (-)
unnamed: D403.2 (A), R416.1
unnamed: D404.2 (A), R417.1
unnamed: D501.1 (K), IC501.2 (OUTPUT), L501.1
unnamed: D801.2 (A), R803.1
unnamed: D901.2 (A), R903.1
unnamed: D1001.2 (A), R1003.1
unnamed: D1101.2 (A), R1103.1
unnamed: D1301.1 (K), J1302.2, Q1301.3 (C)
unnamed: D1301.2 (A), R1304.1
unnamed: D1302.1 (K), J1305.2, Q1302.3 (C)
unnamed: D1302.2 (A), R1309.1
unnamed: D1501.2 (A), D1501#2.2 (A), Q1502.3 (D), R1505.2
unnamed: D1502.2 (A), R1505.1
unnamed: D1601.2 (A), R1601.2
unnamed: D1604.2 (A), R1602.1
unnamed: D1605.2 (A), R1603.2
unnamed: J1301.1, R1302.1
unnamed: J1302.1, R1305.2
unnamed: J1303.1, R1306.1
unnamed: J1304.1, R1310.1
unnamed: J1305.1, R1311.2
unnamed: JP201.2 (B), JP203.2 (B), R208.2
unnamed: JP203.1 (A), U201.3 (E)
unnamed: JP301.2 (B), JP303.2 (B), R308.2
unnamed: JP303.1 (A), U301.3 (E)
unnamed: JP1401.1 (A), R1408.1
unnamed: JP1402.2 (B), R1410.2
unnamed: JP1403.1 (A), R1409.1
unnamed: Q201.1 (G), R211.2
unnamed: Q301.1 (G), R311.2
unnamed: Q401.1, R412.1
unnamed: Q402.1, R413.1
unnamed: Q801.1 (G), R802.1
unnamed: Q802.1 (G), R804.1, R806.2
unnamed: Q901.1 (G), R902.1
unnamed: Q902.1 (G), R904.1, R906.2
unnamed: Q1001.1 (G), R1002.1
unnamed: Q1002.1 (G), R1004.1, R1006.2
unnamed: Q1101.1 (G), R1102.1
unnamed: Q1102.1 (G), R1104.1, R1106.2
unnamed: Q1301.1 (B), R1303.1
unnamed: Q1302.1 (B), R1308.1
unnamed: Q1501.1 (B), R1502.1
unnamed: Q1501.3 (C), R1504.2
unnamed: Q1502.1 (G), R1503.2, R1504.1
unnamed: Q1503.1 (B), R1508.1
unnamed: Q1503.3 (C), Q1504.1 (G), R1509.2
unnamed: R201.2, U201.1 (A)
unnamed: R203.1, R204.2, U202.3 (+)
unnamed: R207.2, R213.1, U202.2 (-)
unnamed: R208.1, R209.2, R211.1
unnamed: R213.2, U202.1, U202.5 (+)
unnamed: R214.2, R216.2
unnamed: R218.2, R224.1, U204.1, U204.2 (-)
unnamed: R222.2, R225.2, U203.5 (+)
unnamed: R224.2, U204.5 (+)
unnamed: R226.2, R227.2, R228.1
unnamed: R301.2, U301.1 (A)
unnamed: R303.1, R304.2, U302.3 (+)
unnamed: R307.2, R313.1, U302.2 (-)
unnamed: R308.1, R309.2, R311.1
unnamed: R313.2, U302.1, U302.5 (+)
unnamed: R314.2, R316.2
unnamed: R318.2, R324.1, U304.1, U304.2 (-)
unnamed: R322.2, R325.2, U303.5 (+)
unnamed: R324.2, U304.5 (+)
unnamed: R326.2, R327.2, R328.1
unnamed: R408.2, U402.7 (DISCH)
unnamed: R409.2, U403.7 (DISCH)
unnamed: R410.1, R412.2, U402.3 (OUT)
unnamed: R411.1, R413.2, U403.3 (OUT)
unnamed: R801.2, U801.1 (A), U802.1 (A)
unnamed: R802.2, U801.3 (E)
unnamed: R806.1, U802.4 (C)
unnamed: R901.2, U901.1 (A), U902.1 (A)
unnamed: R902.2, U901.3 (E)
unnamed: R906.1, U902.4 (C)
unnamed: R1001.2, U1001.1 (A), U1002.1 (A)
unnamed: R1002.2, U1001.3 (E)
unnamed: R1006.1, U1002.4 (C)
unnamed: R1101.2, U1101.1 (A), U1102.1 (A)
unnamed: R1102.2, U1101.3 (E)
unnamed: R1106.1, U1102.4 (C)
unnamed: R1401.2, U1401.13 (~INT)
unnamed: R1402.1, U1401.2 (A1)
unnamed: R1506.2, R1507.2, R1508.2
unnamed: JP202.1 (A), R202.2, R205.2, U201.4 (C)
unnamed: JP302.1 (A), R302.2, R305.2, U301.4 (C)
P0-0: C501.1, C502.2, IC501.1 (VIN), J107.2, J108.2, J109.2, J110.2, J1601.1, Q802.2 (S), Q902.2 (S), Q1002.2 (S), Q1102.2 (S), Q1502.2 (S), R804.2, R904.2, R1004.2, R1104.2, R1302.2, R1304.2, R1305.1, R1309.2, R1311.1, R1503.1, R1603.1, U203.8 (V+), U303.8 (V+)
P0-1: D101.1 (K), D102.1 (K), J104.1, J105.1, J1601.2, JP201.1 (A), JP301.1 (A), R1306.2, R1602.2
P0-2: D1501.1 (K), D1501#2.1 (K), D1602.1 (K), D1603.1 (K), J1601.3, R202.1, R302.1, R1310.2, R1506.1, R1601.1
PO-2: R402.2, R404.1, R405.1
RS485_A: R1406.1, R1410.1, U1403.7 (B)
RS485_B: JP1402.1 (A), R1407.2, U1403.6 (A)
SPI1_CSN: MOD1402.2 (CS), U1402.17 (GPIO13)
SPI1_SCK: MOD1402.1 (CLK), U1402.14 (GPIO10)
SPI1_TX: MOD1402.3 (DIN), U1402.15 (GPIO11)
