Shoziiii/David_marshal_project/KICAD/symbols/Kicad/BalancingRobot.kicad_pcb

## KiCad design KICAD/symbols/Kicad/BalancingRobot.kicad_pcb (2022-06-06)

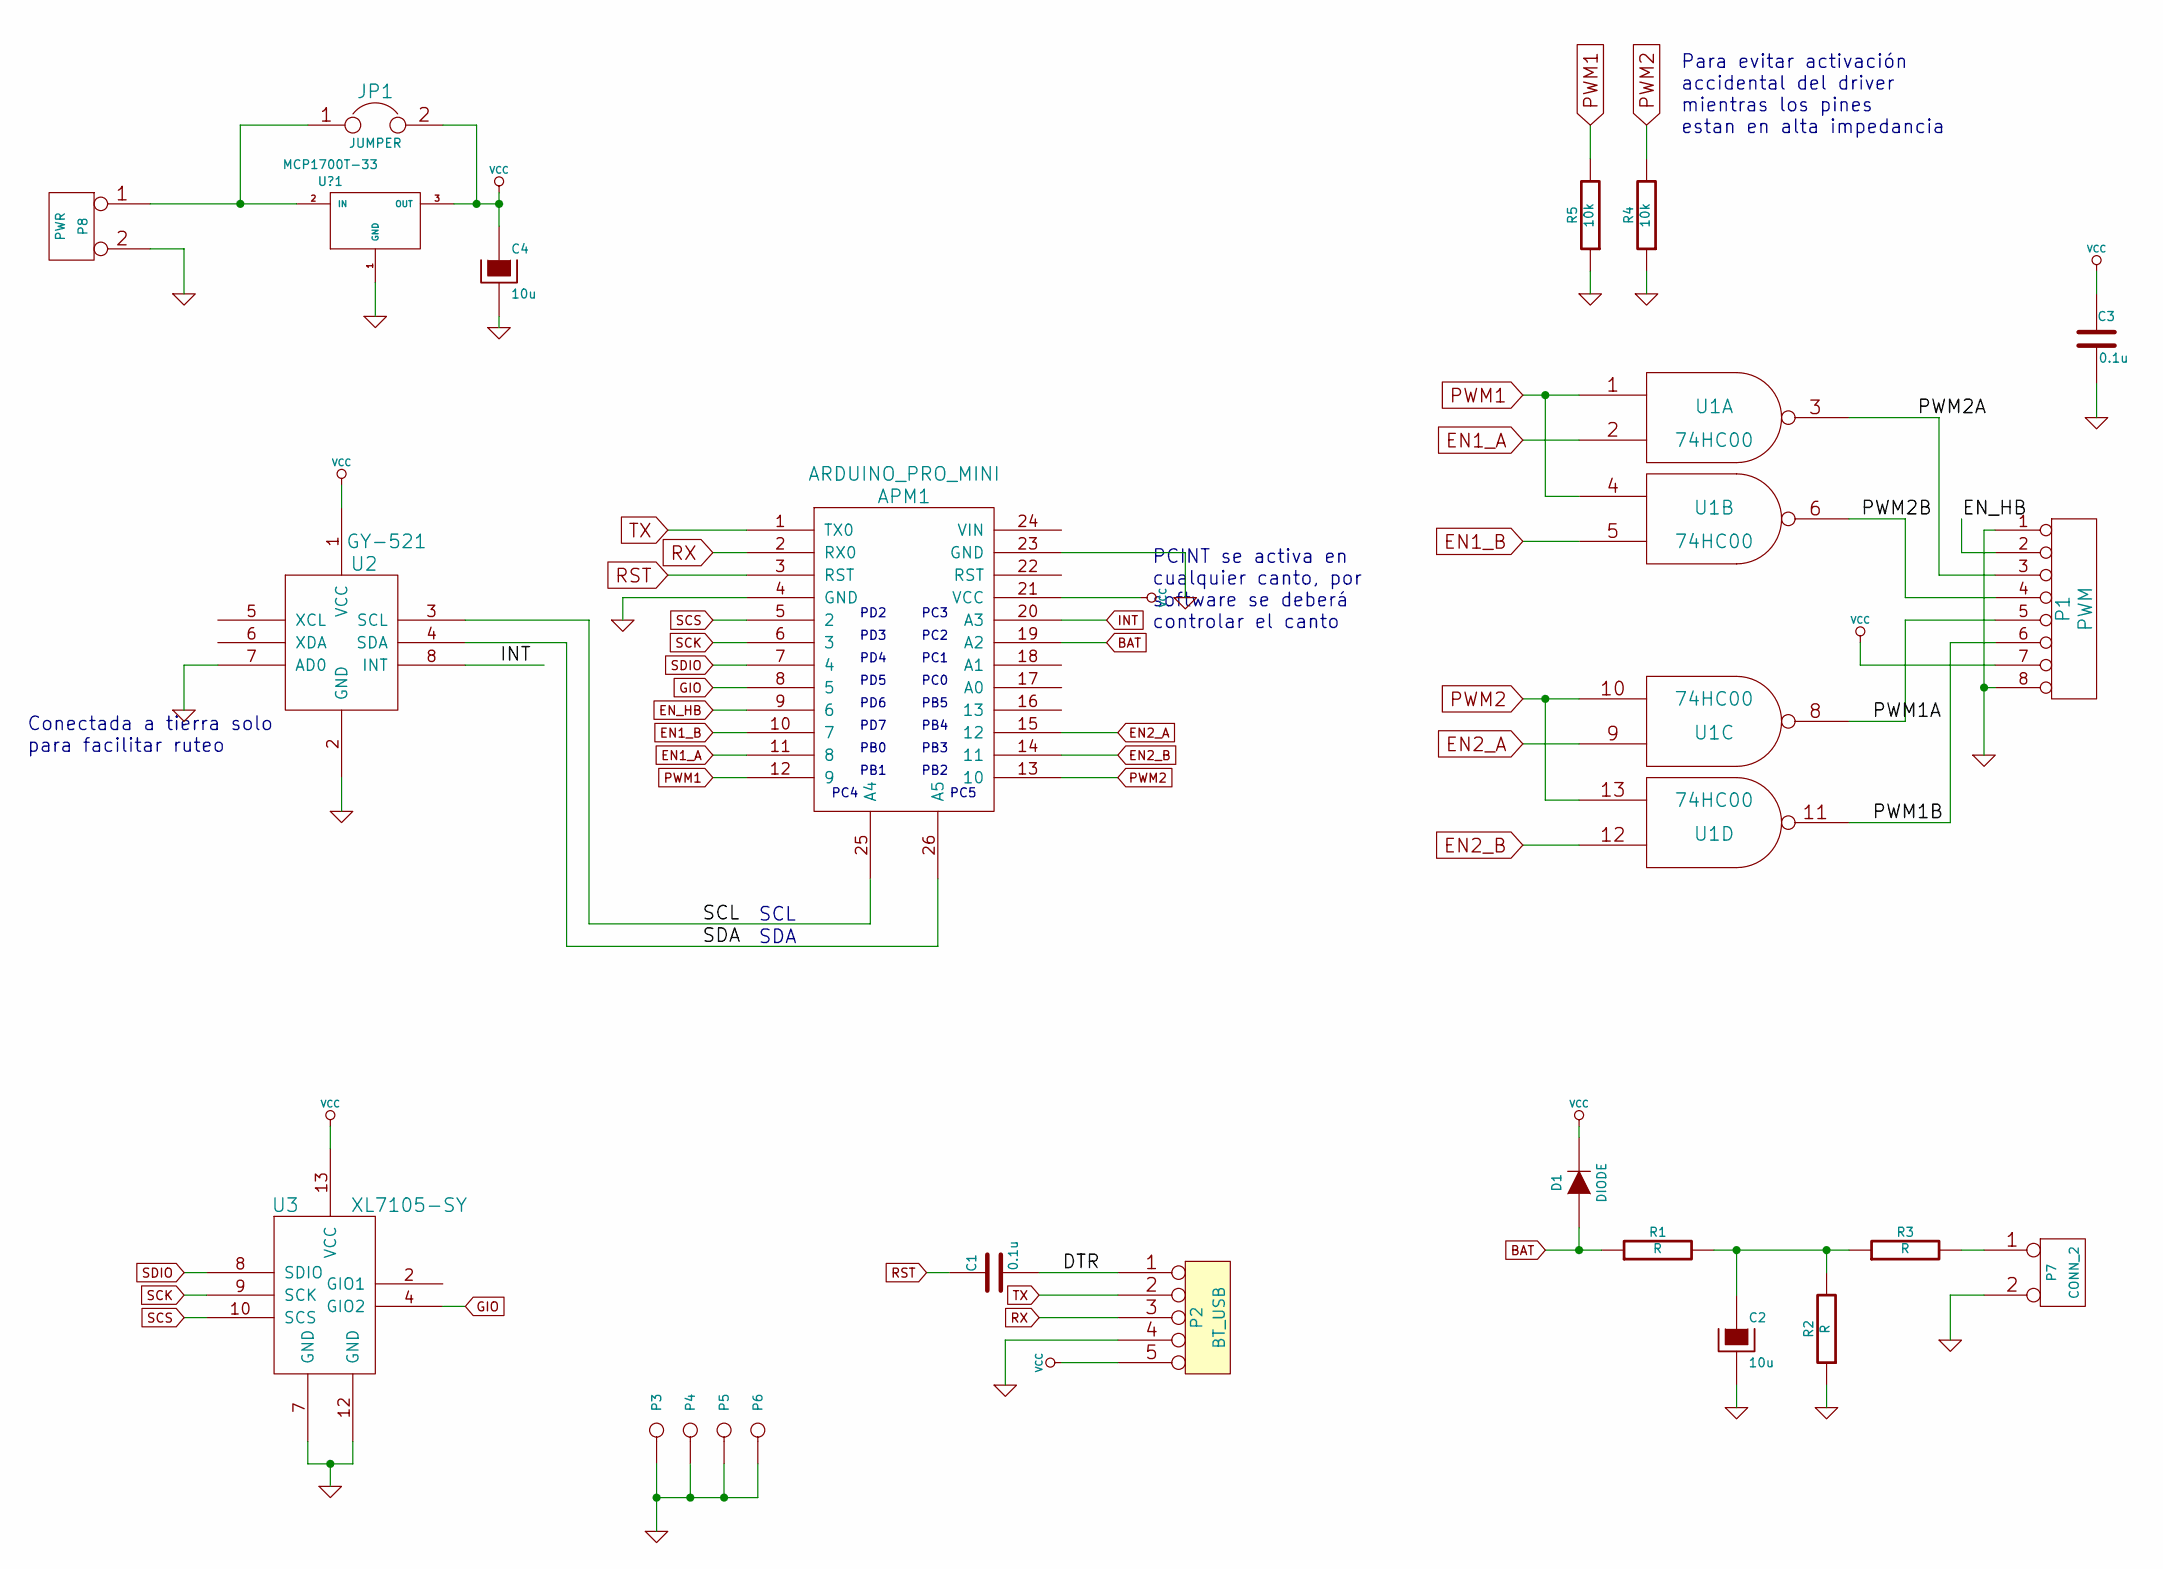
[picture p62: schematic BalancingRobot.sch, Robot Balancista]

Parts:
APM1: ARDUINO_PRO_MINI
C1, C3: 0.1u
C2, C4: 10u
D1: DIODE
JP1: JUMPER
P1: PWM
P2: BT_USB
P3, P4, P5, P6: CONN_1
P7: CONN_2
P8: PWR
R1, R2, R3: R
R4, R5: 10k
U1: 74HC00
U2: GY-521
U3: XL7105-SY
U?1: MCP1700T-33

Connections:
/DTR: C1.2, P2.1
/PWM1A: P1.5, U1.8
/PWM1B: P1.6, U1.11
/PWM2A: P1.3, U1.3
/PWM2B: P1.4, U1.6
/SCL: APM1.25 (A4), U2.3 (SCL)
/SDA: APM1.26 (A5), U2.4 (SDA)
BAT: APM1.19 (A2), D1.1 (A), R1.1
EN1_A: APM1.11 (8), U1.2
EN1_B: APM1.10 (7), U1.5
EN2_A: APM1.15 (12), U1.9
EN2_B: APM1.14 (11), U1.12
EN_HB: APM1.9 (6), P1.2
GIO: APM1.8 (5), U3.4 (GIO2)
GND: APM1.4 (GND), APM1.23 (GND), C2.2, C3.2, C4.2, P1.1, P1.8, P2.4, P3.1, P4.1, P5.1, P6.1, P7.2 (PM), P8.2 (PM), R2.1, R4.1, R5.1, U1.7 (GND), U2.2 (GND), U2.7 (AD0), U3.7 (GND), U3.12 (GND), U?1.1 (GND)
INT: APM1.20 (A3), U2.8 (INT)
unnamed: P7.1, R3.2
unnamed: C2.1, R1.2, R2.2, R3.1
unnamed: JP1.1, P8.1, U?1.2 (IN)
PWM1: APM1.12 (9), R5.2, U1.1, U1.4
PWM2: APM1.13 (10), R4.2, U1.10, U1.13
RST: APM1.3 (RST), C1.1
RX: APM1.2 (RX0), P2.3
SCK: APM1.6 (3), U3.9 (SCK)
SCS: APM1.5 (2), U3.10 (SCS)
SDIO: APM1.7 (4), U3.8 (SDIO)
TX: APM1.1 (TX0), P2.2
VCC: APM1.21 (VCC), C3.1, C4.1, D1.2 (K), JP1.2, P1.7, P2.5, U1.14 (VCC), U2.1 (VCC), U3.13 (VCC), U?1.3 (OUT)

Notes on the sheet:
SDA
SCL
Conectada a tierra solo para facilitar ruteo
PCINT se activa en cualquier canto, por software se deberá controlar el canto
PD2
PD3
PD4
PD5
PD6
PD7
PB0
PB1
PC3
PC2
PC1
PC0
PB5
PB4
PB3
PB2
PC4
PC5
Para evitar activación accidental del driver mientras los pines estan en alta impedancia

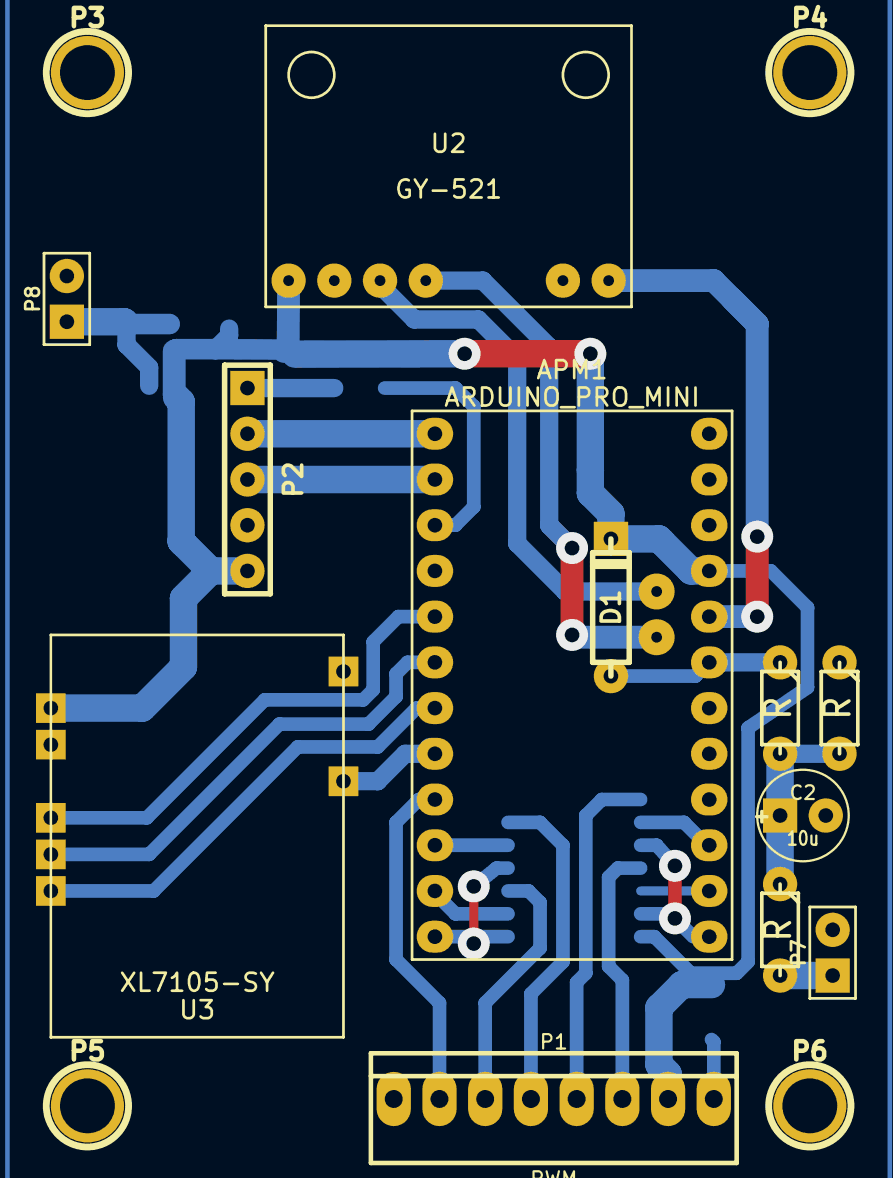
[picture p63: board BalancingRobot.kicad_pcb from above]

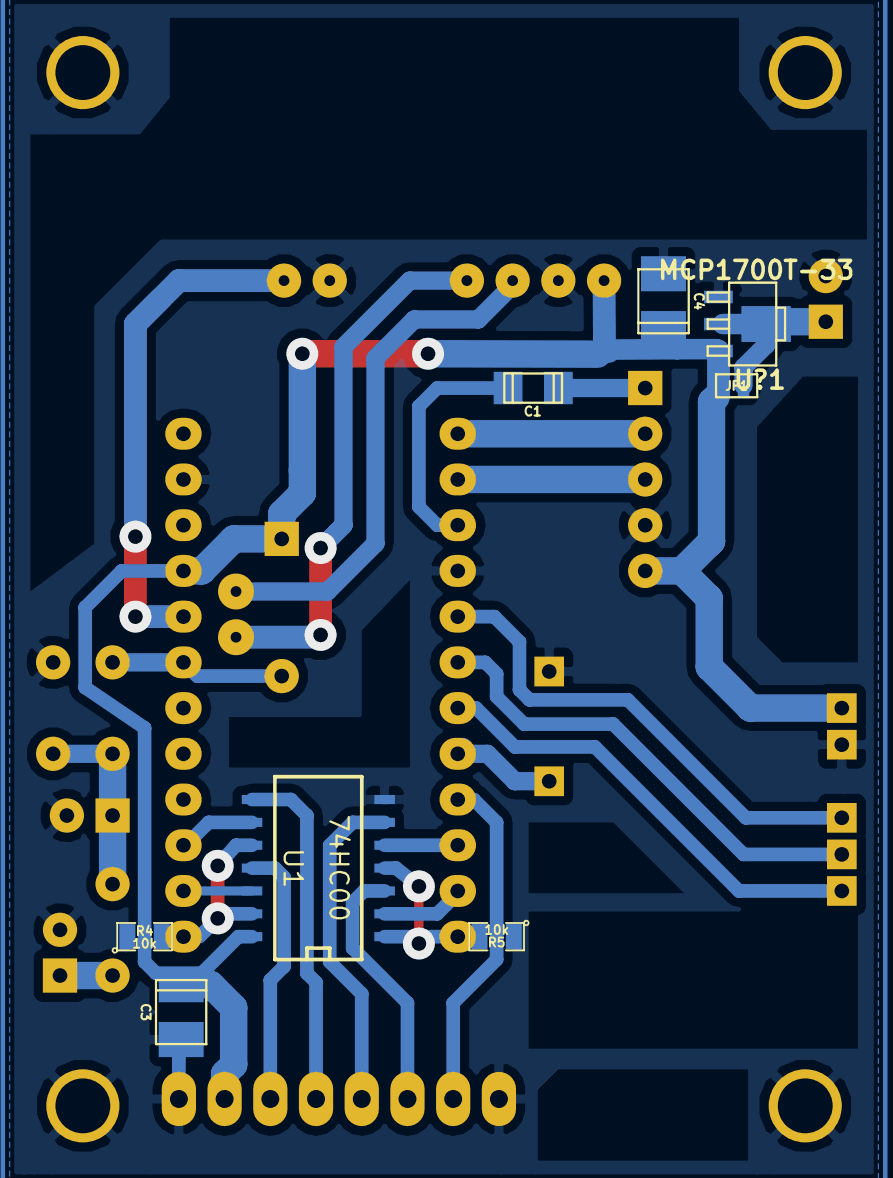
[picture p64: board BalancingRobot.kicad_pcb from below]

Board: 2 copper layers, 24 parts (8 on the bottom side), 28 nets.
