Shoziiii/David_marshal_project/(commit log)

2022-06-06 Added new files
    [15EDGVM-3.81-02P-14-00A(H).SLDDRW, 15EDGVM-3.81-02P-14-00A(H).SLDPRT, 19.19 .xlsx, 19.20.BOM.xlsx, 19.20.kicad_pcb, 19.20.kicad_sch, 19.20.xlsx, 4220-0500-0400-0350-0105-00.DXF]
2022-06-06 Updated the schematic
    [19.19 .xlsx, 19.20.BOM.xlsx, 19.20.kicad_pcb, 19.20.kicad_sch, 19.20.xlsx, 4220-0500-0400-0350-0105-00.DXF, 555 Coil.kicad_sch, Current Sensor 01.kicad_sch]
